beanz/m-draw-scad/readme.md

# M-draw-scad
Drawing bot with MGN rails

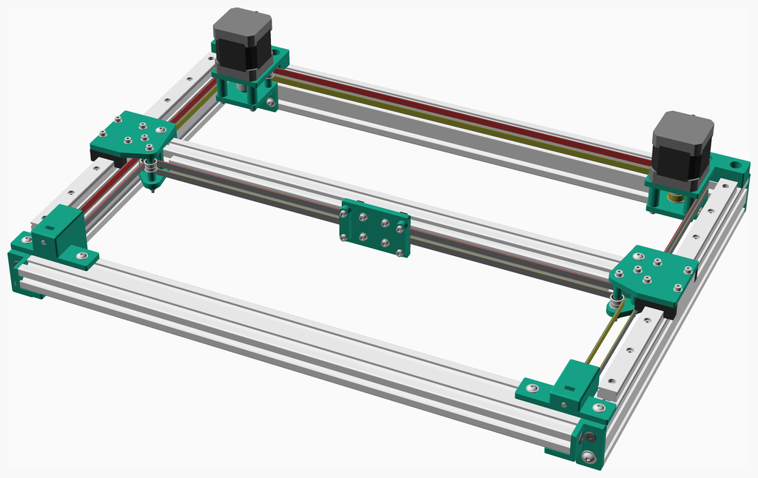
[picture p1: assemblies/main_assembled.png]
Main Assembly


<span></span>

---
## Table of Contents
1. [Parts list](#Parts_list)
1. [X Carriage Insert Assembly](#x_carriage_insert_assembly)
1. [X Carriage Assembly](#x_carriage_assembly)
1. [Idler Assembly](#idler_assembly)
1. [Right Y Carriage Assembly](#right_y_carriage_assembly)
1. [Left Y Carriage Assembly](#left_y_carriage_assembly)
1. [X Rail Carriage Assembly](#x_rail_carriage_assembly)
1. [X Rail Left Assembly](#x_rail_left_assembly)
1. [X Rail Assembly](#x_rail_assembly)
1. [Double Idler Assembly](#double_idler_assembly)
1. [Right Motor Pulley Assembly](#right_motor_pulley_assembly)
1. [Right Motor Assembly](#right_motor_assembly)
1. [Left Motor Pulley Assembly](#left_motor_pulley_assembly)
1. [Left Motor Assembly](#left_motor_assembly)
1. [Right Inner Idler Assembly](#right_inner_idler_assembly)
1. [Right Idler Assembly](#right_idler_assembly)
1. [Left Inner Idler Assembly](#left_inner_idler_assembly)
1. [Left Idler Assembly](#left_idler_assembly)
1. [Front Frame Left Assembly](#front_frame_left_assembly)
1. [Front Frame Assembly](#front_frame_assembly)
1. [Back Frame Left Assembly](#back_frame_left_assembly)
1. [Back Frame Assembly](#back_frame_assembly)
1. [Y Rail Assembly](#y_rail_assembly)
1. [Back And Y Assembly](#back_and_y_assembly)
1. [Frame Assembly](#frame_assembly)
1. [Frame Idler Assembly](#frame_idler_assembly)
1. [Frame Motor Assembly](#frame_motor_assembly)
1. [Frame X Rail Assembly](#frame_x_rail_assembly)
1. [Frame X Carriage Assembly](#frame_x_carriage_assembly)
1. [Main Assembly](#main_assembly)

<span></span>
[Top](#TOP)

---

## Parts list
| <span style="writing-mode: vertical-rl; text-orientation: mixed;">X&nbsp;Carriage&nbsp;Insert</span> | <span style="writing-mode: vertical-rl; text-orientation: mixed;">X&nbsp;Carriage</span> | <span style="writing-mode: vertical-rl; text-orientation: mixed;">8 x Idler</span> | <span style="writing-mode: vertical-rl; text-orientation: mixed;">Right&nbsp;Y&nbsp;Carriage</span> | <span style="writing-mode: vertical-rl; text-orientation: mixed;">Left&nbsp;Y&nbsp;Carriage</span> | <span style="writing-mode: vertical-rl; text-orientation: mixed;">X&nbsp;Rail&nbsp;Carriage</span> | <span style="writing-mode: vertical-rl; text-orientation: mixed;">X&nbsp;Rail&nbsp;Left</span> | <span style="writing-mode: vertical-rl; text-orientation: mixed;">X&nbsp;Rail</span> | <span style="writing-mode: vertical-rl; text-orientation: mixed;">2 x Double&nbsp;Idler</span> | <span style="writing-mode: vertical-rl; text-orientation: mixed;">Right&nbsp;Motor&nbsp;Pulley</span> | <span style="writing-mode: vertical-rl; text-orientation: mixed;">Right&nbsp;Motor</span> | <span style="writing-mode: vertical-rl; text-orientation: mixed;">Left&nbsp;Motor&nbsp;Pulley</span> | <span style="writing-mode: vertical-rl; text-orientation: mixed;">Left&nbsp;Motor</span> | <span style="writing-mode: vertical-rl; text-orientation: mixed;">Right&nbsp;Inner&nbsp;Idler</span> | <span style="writing-mode: vertical-rl; text-orientation: mixed;">Right&nbsp;Idler</span> | <span style="writing-mode: vertical-rl; text-orientation: mixed;">Left&nbsp;Inner&nbsp;Idler</span> | <span style="writing-mode: vertical-rl; text-orientation: mixed;">Left&nbsp;Idler</span> | <span style="writing-mode: vertical-rl; text-orientation: mixed;">Front&nbsp;Frame&nbsp;Left</span> | <span style="writing-mode: vertical-rl; text-orientation: mixed;">Front&nbsp;Frame</span> | <span style="writing-mode: vertical-rl; text-orientation: mixed;">Back&nbsp;Frame&nbsp;Left</span> | <span style="writing-mode: vertical-rl; text-orientation: mixed;">Back&nbsp;Frame</span> | <span style="writing-mode: vertical-rl; text-orientation: mixed;">2 x Y&nbsp;Rail</span> | <span style="writing-mode: vertical-rl; text-orientation: mixed;">Back&nbsp;And&nbsp;Y</span> | <span style="writing-mode: vertical-rl; text-orientation: mixed;">Frame</span> | <span style="writing-mode: vertical-rl; text-orientation: mixed;">Frame&nbsp;Idler</span> | <span style="writing-mode: vertical-rl; text-orientation: mixed;">Frame&nbsp;Motor</span> | <span style="writing-mode: vertical-rl; text-orientation: mixed;">Frame&nbsp;X&nbsp;Rail</span> | <span style="writing-mode: vertical-rl; text-orientation: mixed;">Frame&nbsp;X&nbsp;Carriage</span> | <span style="writing-mode: vertical-rl; text-orientation: mixed;">Main</span> | <span style="writing-mode: vertical-rl; text-orientation: mixed;">TOTALS</span> |  |
|---:|---:|---:|---:|---:|---:|---:|---:|---:|---:|---:|---:|---:|---:|---:|---:|---:|---:|---:|---:|---:|---:|---:|---:|---:|---:|---:|---:|---:|---:|:---|
|  |  |  |  |  |  |  |  |  |  |  |  |  |  |  |  |  |  |  |  |  |  |  |  |  |  |  |  |  | | **Vitamins** |
| &nbsp;&nbsp;.&nbsp; | &nbsp;&nbsp;.&nbsp; | &nbsp;&nbsp;16&nbsp; | &nbsp;&nbsp;.&nbsp; | &nbsp;&nbsp;.&nbsp; | &nbsp;&nbsp;.&nbsp; | &nbsp;&nbsp;.&nbsp; | &nbsp;&nbsp;.&nbsp; | &nbsp;&nbsp;8&nbsp; | &nbsp;&nbsp;.&nbsp; | &nbsp;&nbsp;.&nbsp; | &nbsp;&nbsp;.&nbsp; | &nbsp;&nbsp;.&nbsp; | &nbsp;&nbsp;.&nbsp; | &nbsp;&nbsp;.&nbsp; | &nbsp;&nbsp;.&nbsp; | &nbsp;&nbsp;.&nbsp; | &nbsp;&nbsp;.&nbsp; | &nbsp;&nbsp;.&nbsp; | &nbsp;&nbsp;.&nbsp; | &nbsp;&nbsp;.&nbsp; | &nbsp;&nbsp;.&nbsp; | &nbsp;&nbsp;.&nbsp; | &nbsp;&nbsp;.&nbsp; | &nbsp;&nbsp;.&nbsp; | &nbsp;&nbsp;.&nbsp; | &nbsp;&nbsp;.&nbsp; | &nbsp;&nbsp;.&nbsp; | &nbsp;&nbsp;.&nbsp; |  &nbsp;&nbsp;24&nbsp; | &nbsp;&nbsp; Ball bearing F623-2RS 3mm x 10mm x 4mm |
| &nbsp;&nbsp;.&nbsp; | &nbsp;&nbsp;.&nbsp; | &nbsp;&nbsp;.&nbsp; | &nbsp;&nbsp;.&nbsp; | &nbsp;&nbsp;.&nbsp; | &nbsp;&nbsp;.&nbsp; | &nbsp;&nbsp;.&nbsp; | &nbsp;&nbsp;.&nbsp; | &nbsp;&nbsp;.&nbsp; | &nbsp;&nbsp;.&nbsp; | &nbsp;&nbsp;.&nbsp; | &nbsp;&nbsp;.&nbsp; | &nbsp;&nbsp;.&nbsp; | &nbsp;&nbsp;.&nbsp; | &nbsp;&nbsp;.&nbsp; | &nbsp;&nbsp;.&nbsp; | &nbsp;&nbsp;.&nbsp; | &nbsp;&nbsp;.&nbsp; | &nbsp;&nbsp;.&nbsp; | &nbsp;&nbsp;.&nbsp; | &nbsp;&nbsp;.&nbsp; | &nbsp;&nbsp;.&nbsp; | &nbsp;&nbsp;.&nbsp; | &nbsp;&nbsp;.&nbsp; | &nbsp;&nbsp;.&nbsp; | &nbsp;&nbsp;.&nbsp; | &nbsp;&nbsp;.&nbsp; | &nbsp;&nbsp;.&nbsp; | &nbsp;&nbsp;1&nbsp; |  &nbsp;&nbsp;1&nbsp; | &nbsp;&nbsp; Belt GT2 x 6mm x 1524mm |
| &nbsp;&nbsp;.&nbsp; | &nbsp;&nbsp;.&nbsp; | &nbsp;&nbsp;.&nbsp; | &nbsp;&nbsp;.&nbsp; | &nbsp;&nbsp;.&nbsp; | &nbsp;&nbsp;.&nbsp; | &nbsp;&nbsp;.&nbsp; | &nbsp;&nbsp;.&nbsp; | &nbsp;&nbsp;.&nbsp; | &nbsp;&nbsp;.&nbsp; | &nbsp;&nbsp;.&nbsp; | &nbsp;&nbsp;.&nbsp; | &nbsp;&nbsp;.&nbsp; | &nbsp;&nbsp;.&nbsp; | &nbsp;&nbsp;.&nbsp; | &nbsp;&nbsp;.&nbsp; | &nbsp;&nbsp;.&nbsp; | &nbsp;&nbsp;.&nbsp; | &nbsp;&nbsp;.&nbsp; | &nbsp;&nbsp;.&nbsp; | &nbsp;&nbsp;.&nbsp; | &nbsp;&nbsp;.&nbsp; | &nbsp;&nbsp;.&nbsp; | &nbsp;&nbsp;.&nbsp; | &nbsp;&nbsp;.&nbsp; | &nbsp;&nbsp;.&nbsp; | &nbsp;&nbsp;.&nbsp; | &nbsp;&nbsp;.&nbsp; | &nbsp;&nbsp;1&nbsp; |  &nbsp;&nbsp;1&nbsp; | &nbsp;&nbsp; Belt GT2 x 6mm x 1524mm |
| &nbsp;&nbsp;.&nbsp; | &nbsp;&nbsp;.&nbsp; | &nbsp;&nbsp;.&nbsp; | &nbsp;&nbsp;.&nbsp; | &nbsp;&nbsp;.&nbsp; | &nbsp;&nbsp;1&nbsp; | &nbsp;&nbsp;.&nbsp; | &nbsp;&nbsp;.&nbsp; | &nbsp;&nbsp;.&nbsp; | &nbsp;&nbsp;.&nbsp; | &nbsp;&nbsp;.&nbsp; | &nbsp;&nbsp;.&nbsp; | &nbsp;&nbsp;.&nbsp; | &nbsp;&nbsp;.&nbsp; | &nbsp;&nbsp;.&nbsp; | &nbsp;&nbsp;.&nbsp; | &nbsp;&nbsp;.&nbsp; | &nbsp;&nbsp;.&nbsp; | &nbsp;&nbsp;.&nbsp; | &nbsp;&nbsp;.&nbsp; | &nbsp;&nbsp;.&nbsp; | &nbsp;&nbsp;.&nbsp; | &nbsp;&nbsp;.&nbsp; | &nbsp;&nbsp;.&nbsp; | &nbsp;&nbsp;.&nbsp; | &nbsp;&nbsp;.&nbsp; | &nbsp;&nbsp;.&nbsp; | &nbsp;&nbsp;.&nbsp; | &nbsp;&nbsp;.&nbsp; |  &nbsp;&nbsp;1&nbsp; | &nbsp;&nbsp; Extrusion E2020 x 450mm |
| &nbsp;&nbsp;.&nbsp; | &nbsp;&nbsp;.&nbsp; | &nbsp;&nbsp;.&nbsp; | &nbsp;&nbsp;.&nbsp; | &nbsp;&nbsp;.&nbsp; | &nbsp;&nbsp;.&nbsp; | &nbsp;&nbsp;.&nbsp; | &nbsp;&nbsp;.&nbsp; | &nbsp;&nbsp;.&nbsp; | &nbsp;&nbsp;.&nbsp; | &nbsp;&nbsp;.&nbsp; | &nbsp;&nbsp;.&nbsp; | &nbsp;&nbsp;.&nbsp; | &nbsp;&nbsp;.&nbsp; | &nbsp;&nbsp;.&nbsp; | &nbsp;&nbsp;.&nbsp; | &nbsp;&nbsp;.&nbsp; | &nbsp;&nbsp;.&nbsp; | &nbsp;&nbsp;.&nbsp; | &nbsp;&nbsp;.&nbsp; | &nbsp;&nbsp;.&nbsp; | &nbsp;&nbsp;2&nbsp; | &nbsp;&nbsp;.&nbsp; | &nbsp;&nbsp;.&nbsp; | &nbsp;&nbsp;.&nbsp; | &nbsp;&nbsp;.&nbsp; | &nbsp;&nbsp;.&nbsp; | &nbsp;&nbsp;.&nbsp; | &nbsp;&nbsp;.&nbsp; |  &nbsp;&nbsp;2&nbsp; | &nbsp;&nbsp; Extrusion E2040 x 354mm |
| &nbsp;&nbsp;.&nbsp; | &nbsp;&nbsp;.&nbsp; | &nbsp;&nbsp;.&nbsp; | &nbsp;&nbsp;.&nbsp; | &nbsp;&nbsp;.&nbsp; | &nbsp;&nbsp;.&nbsp; | &nbsp;&nbsp;.&nbsp; | &nbsp;&nbsp;.&nbsp; | &nbsp;&nbsp;.&nbsp; | &nbsp;&nbsp;.&nbsp; | &nbsp;&nbsp;.&nbsp; | &nbsp;&nbsp;.&nbsp; | &nbsp;&nbsp;.&nbsp; | &nbsp;&nbsp;.&nbsp; | &nbsp;&nbsp;.&nbsp; | &nbsp;&nbsp;.&nbsp; | &nbsp;&nbsp;.&nbsp; | &nbsp;&nbsp;1&nbsp; | &nbsp;&nbsp;.&nbsp; | &nbsp;&nbsp;1&nbsp; | &nbsp;&nbsp;.&nbsp; | &nbsp;&nbsp;.&nbsp; | &nbsp;&nbsp;.&nbsp; | &nbsp;&nbsp;.&nbsp; | &nbsp;&nbsp;.&nbsp; | &nbsp;&nbsp;.&nbsp; | &nbsp;&nbsp;.&nbsp; | &nbsp;&nbsp;.&nbsp; | &nbsp;&nbsp;.&nbsp; |  &nbsp;&nbsp;2&nbsp; | &nbsp;&nbsp; Extrusion E2040 x 472mm |
| &nbsp;&nbsp;4&nbsp; | &nbsp;&nbsp;.&nbsp; | &nbsp;&nbsp;.&nbsp; | &nbsp;&nbsp;.&nbsp; | &nbsp;&nbsp;.&nbsp; | &nbsp;&nbsp;.&nbsp; | &nbsp;&nbsp;.&nbsp; | &nbsp;&nbsp;.&nbsp; | &nbsp;&nbsp;.&nbsp; | &nbsp;&nbsp;.&nbsp; | &nbsp;&nbsp;.&nbsp; | &nbsp;&nbsp;.&nbsp; | &nbsp;&nbsp;.&nbsp; | &nbsp;&nbsp;.&nbsp; | &nbsp;&nbsp;.&nbsp; | &nbsp;&nbsp;.&nbsp; | &nbsp;&nbsp;.&nbsp; | &nbsp;&nbsp;.&nbsp; | &nbsp;&nbsp;.&nbsp; | &nbsp;&nbsp;.&nbsp; | &nbsp;&nbsp;.&nbsp; | &nbsp;&nbsp;.&nbsp; | &nbsp;&nbsp;.&nbsp; | &nbsp;&nbsp;.&nbsp; | &nbsp;&nbsp;.&nbsp; | &nbsp;&nbsp;.&nbsp; | &nbsp;&nbsp;.&nbsp; | &nbsp;&nbsp;.&nbsp; | &nbsp;&nbsp;.&nbsp; |  &nbsp;&nbsp;4&nbsp; | &nbsp;&nbsp; Heatfit insert M3 x 4mm |
| &nbsp;&nbsp;.&nbsp; | &nbsp;&nbsp;.&nbsp; | &nbsp;&nbsp;.&nbsp; | &nbsp;&nbsp;.&nbsp; | &nbsp;&nbsp;.&nbsp; | &nbsp;&nbsp;1&nbsp; | &nbsp;&nbsp;.&nbsp; | &nbsp;&nbsp;.&nbsp; | &nbsp;&nbsp;.&nbsp; | &nbsp;&nbsp;.&nbsp; | &nbsp;&nbsp;.&nbsp; | &nbsp;&nbsp;.&nbsp; | &nbsp;&nbsp;.&nbsp; | &nbsp;&nbsp;.&nbsp; | &nbsp;&nbsp;.&nbsp; | &nbsp;&nbsp;.&nbsp; | &nbsp;&nbsp;.&nbsp; | &nbsp;&nbsp;.&nbsp; | &nbsp;&nbsp;.&nbsp; | &nbsp;&nbsp;.&nbsp; | &nbsp;&nbsp;.&nbsp; | &nbsp;&nbsp;.&nbsp; | &nbsp;&nbsp;.&nbsp; | &nbsp;&nbsp;.&nbsp; | &nbsp;&nbsp;.&nbsp; | &nbsp;&nbsp;.&nbsp; | &nbsp;&nbsp;.&nbsp; | &nbsp;&nbsp;.&nbsp; | &nbsp;&nbsp;.&nbsp; |  &nbsp;&nbsp;1&nbsp; | &nbsp;&nbsp; Linear rail MGN12 x 400mm |
| &nbsp;&nbsp;.&nbsp; | &nbsp;&nbsp;.&nbsp; | &nbsp;&nbsp;.&nbsp; | &nbsp;&nbsp;.&nbsp; | &nbsp;&nbsp;.&nbsp; | &nbsp;&nbsp;.&nbsp; | &nbsp;&nbsp;.&nbsp; | &nbsp;&nbsp;.&nbsp; | &nbsp;&nbsp;.&nbsp; | &nbsp;&nbsp;.&nbsp; | &nbsp;&nbsp;.&nbsp; | &nbsp;&nbsp;.&nbsp; | &nbsp;&nbsp;.&nbsp; | &nbsp;&nbsp;.&nbsp; | &nbsp;&nbsp;.&nbsp; | &nbsp;&nbsp;.&nbsp; | &nbsp;&nbsp;.&nbsp; | &nbsp;&nbsp;.&nbsp; | &nbsp;&nbsp;.&nbsp; | &nbsp;&nbsp;.&nbsp; | &nbsp;&nbsp;.&nbsp; | &nbsp;&nbsp;2&nbsp; | &nbsp;&nbsp;.&nbsp; | &nbsp;&nbsp;.&nbsp; | &nbsp;&nbsp;.&nbsp; | &nbsp;&nbsp;.&nbsp; | &nbsp;&nbsp;.&nbsp; | &nbsp;&nbsp;.&nbsp; | &nbsp;&nbsp;.&nbsp; |  &nbsp;&nbsp;2&nbsp; | &nbsp;&nbsp; Linear rail MGN15 x 300mm |
| &nbsp;&nbsp;.&nbsp; | &nbsp;&nbsp;.&nbsp; | &nbsp;&nbsp;.&nbsp; | &nbsp;&nbsp;.&nbsp; | &nbsp;&nbsp;.&nbsp; | &nbsp;&nbsp;1&nbsp; | &nbsp;&nbsp;.&nbsp; | &nbsp;&nbsp;.&nbsp; | &nbsp;&nbsp;.&nbsp; | &nbsp;&nbsp;.&nbsp; | &nbsp;&nbsp;.&nbsp; | &nbsp;&nbsp;.&nbsp; | &nbsp;&nbsp;.&nbsp; | &nbsp;&nbsp;.&nbsp; | &nbsp;&nbsp;.&nbsp; | &nbsp;&nbsp;.&nbsp; | &nbsp;&nbsp;.&nbsp; | &nbsp;&nbsp;.&nbsp; | &nbsp;&nbsp;.&nbsp; | &nbsp;&nbsp;.&nbsp; | &nbsp;&nbsp;.&nbsp; | &nbsp;&nbsp;.&nbsp; | &nbsp;&nbsp;.&nbsp; | &nbsp;&nbsp;.&nbsp; | &nbsp;&nbsp;.&nbsp; | &nbsp;&nbsp;.&nbsp; | &nbsp;&nbsp;.&nbsp; | &nbsp;&nbsp;.&nbsp; | &nbsp;&nbsp;.&nbsp; |  &nbsp;&nbsp;1&nbsp; | &nbsp;&nbsp; Linear rail carriage MGN12H |
| &nbsp;&nbsp;.&nbsp; | &nbsp;&nbsp;.&nbsp; | &nbsp;&nbsp;.&nbsp; | &nbsp;&nbsp;.&nbsp; | &nbsp;&nbsp;.&nbsp; | &nbsp;&nbsp;.&nbsp; | &nbsp;&nbsp;.&nbsp; | &nbsp;&nbsp;.&nbsp; | &nbsp;&nbsp;.&nbsp; | &nbsp;&nbsp;.&nbsp; | &nbsp;&nbsp;.&nbsp; | &nbsp;&nbsp;.&nbsp; | &nbsp;&nbsp;.&nbsp; | &nbsp;&nbsp;.&nbsp; | &nbsp;&nbsp;.&nbsp; | &nbsp;&nbsp;.&nbsp; | &nbsp;&nbsp;.&nbsp; | &nbsp;&nbsp;.&nbsp; | &nbsp;&nbsp;.&nbsp; | &nbsp;&nbsp;.&nbsp; | &nbsp;&nbsp;.&nbsp; | &nbsp;&nbsp;2&nbsp; | &nbsp;&nbsp;.&nbsp; | &nbsp;&nbsp;.&nbsp; | &nbsp;&nbsp;.&nbsp; | &nbsp;&nbsp;.&nbsp; | &nbsp;&nbsp;.&nbsp; | &nbsp;&nbsp;.&nbsp; | &nbsp;&nbsp;.&nbsp; |  &nbsp;&nbsp;2&nbsp; | &nbsp;&nbsp; Linear rail carriage MGN15H |
| &nbsp;&nbsp;.&nbsp; | &nbsp;&nbsp;.&nbsp; | &nbsp;&nbsp;.&nbsp; | &nbsp;&nbsp;.&nbsp; | &nbsp;&nbsp;.&nbsp; | &nbsp;&nbsp;16&nbsp; | &nbsp;&nbsp;2&nbsp; | &nbsp;&nbsp;2&nbsp; | &nbsp;&nbsp;.&nbsp; | &nbsp;&nbsp;.&nbsp; | &nbsp;&nbsp;.&nbsp; | &nbsp;&nbsp;.&nbsp; | &nbsp;&nbsp;.&nbsp; | &nbsp;&nbsp;.&nbsp; | &nbsp;&nbsp;.&nbsp; | &nbsp;&nbsp;.&nbsp; | &nbsp;&nbsp;.&nbsp; | &nbsp;&nbsp;.&nbsp; | &nbsp;&nbsp;.&nbsp; | &nbsp;&nbsp;.&nbsp; | &nbsp;&nbsp;.&nbsp; | &nbsp;&nbsp;16&nbsp; | &nbsp;&nbsp;.&nbsp; | &nbsp;&nbsp;.&nbsp; | &nbsp;&nbsp;.&nbsp; | &nbsp;&nbsp;.&nbsp; | &nbsp;&nbsp;.&nbsp; | &nbsp;&nbsp;.&nbsp; | &nbsp;&nbsp;.&nbsp; |  &nbsp;&nbsp;36&nbsp; | &nbsp;&nbsp; Nut M3 sliding T |
| &nbsp;&nbsp;.&nbsp; | &nbsp;&nbsp;.&nbsp; | &nbsp;&nbsp;.&nbsp; | &nbsp;&nbsp;.&nbsp; | &nbsp;&nbsp;.&nbsp; | &nbsp;&nbsp;.&nbsp; | &nbsp;&nbsp;.&nbsp; | &nbsp;&nbsp;.&nbsp; | &nbsp;&nbsp;.&nbsp; | &nbsp;&nbsp;.&nbsp; | &nbsp;&nbsp;.&nbsp; | &nbsp;&nbsp;.&nbsp; | &nbsp;&nbsp;.&nbsp; | &nbsp;&nbsp;.&nbsp; | &nbsp;&nbsp;.&nbsp; | &nbsp;&nbsp;.&nbsp; | &nbsp;&nbsp;.&nbsp; | &nbsp;&nbsp;4&nbsp; | &nbsp;&nbsp;4&nbsp; | &nbsp;&nbsp;7&nbsp; | &nbsp;&nbsp;7&nbsp; | &nbsp;&nbsp;.&nbsp; | &nbsp;&nbsp;2&nbsp; | &nbsp;&nbsp;2&nbsp; | &nbsp;&nbsp;.&nbsp; | &nbsp;&nbsp;.&nbsp; | &nbsp;&nbsp;.&nbsp; | &nbsp;&nbsp;.&nbsp; | &nbsp;&nbsp;.&nbsp; |  &nbsp;&nbsp;26&nbsp; | &nbsp;&nbsp; Nut M4 sliding T |
| &nbsp;&nbsp;.&nbsp; | &nbsp;&nbsp;.&nbsp; | &nbsp;&nbsp;.&nbsp; | &nbsp;&nbsp;2&nbsp; | &nbsp;&nbsp;2&nbsp; | &nbsp;&nbsp;.&nbsp; | &nbsp;&nbsp;.&nbsp; | &nbsp;&nbsp;.&nbsp; | &nbsp;&nbsp;.&nbsp; | &nbsp;&nbsp;.&nbsp; | &nbsp;&nbsp;.&nbsp; | &nbsp;&nbsp;.&nbsp; | &nbsp;&nbsp;.&nbsp; | &nbsp;&nbsp;.&nbsp; | &nbsp;&nbsp;.&nbsp; | &nbsp;&nbsp;.&nbsp; | &nbsp;&nbsp;.&nbsp; | &nbsp;&nbsp;.&nbsp; | &nbsp;&nbsp;.&nbsp; | &nbsp;&nbsp;.&nbsp; | &nbsp;&nbsp;.&nbsp; | &nbsp;&nbsp;.&nbsp; | &nbsp;&nbsp;.&nbsp; | &nbsp;&nbsp;.&nbsp; | &nbsp;&nbsp;.&nbsp; | &nbsp;&nbsp;.&nbsp; | &nbsp;&nbsp;.&nbsp; | &nbsp;&nbsp;.&nbsp; | &nbsp;&nbsp;.&nbsp; |  &nbsp;&nbsp;4&nbsp; | &nbsp;&nbsp; Nut M4 x 3.2mm  |
| &nbsp;&nbsp;.&nbsp; | &nbsp;&nbsp;.&nbsp; | &nbsp;&nbsp;.&nbsp; | &nbsp;&nbsp;.&nbsp; | &nbsp;&nbsp;.&nbsp; | &nbsp;&nbsp;.&nbsp; | &nbsp;&nbsp;.&nbsp; | &nbsp;&nbsp;.&nbsp; | &nbsp;&nbsp;.&nbsp; | &nbsp;&nbsp;.&nbsp; | &nbsp;&nbsp;.&nbsp; | &nbsp;&nbsp;.&nbsp; | &nbsp;&nbsp;.&nbsp; | &nbsp;&nbsp;.&nbsp; | &nbsp;&nbsp;2&nbsp; | &nbsp;&nbsp;.&nbsp; | &nbsp;&nbsp;2&nbsp; | &nbsp;&nbsp;.&nbsp; | &nbsp;&nbsp;.&nbsp; | &nbsp;&nbsp;.&nbsp; | &nbsp;&nbsp;.&nbsp; | &nbsp;&nbsp;.&nbsp; | &nbsp;&nbsp;.&nbsp; | &nbsp;&nbsp;.&nbsp; | &nbsp;&nbsp;.&nbsp; | &nbsp;&nbsp;.&nbsp; | &nbsp;&nbsp;.&nbsp; | &nbsp;&nbsp;.&nbsp; | &nbsp;&nbsp;.&nbsp; |  &nbsp;&nbsp;4&nbsp; | &nbsp;&nbsp; Nut M4 x 3.2mm  |
| &nbsp;&nbsp;.&nbsp; | &nbsp;&nbsp;.&nbsp; | &nbsp;&nbsp;.&nbsp; | &nbsp;&nbsp;.&nbsp; | &nbsp;&nbsp;.&nbsp; | &nbsp;&nbsp;.&nbsp; | &nbsp;&nbsp;.&nbsp; | &nbsp;&nbsp;.&nbsp; | &nbsp;&nbsp;.&nbsp; | &nbsp;&nbsp;1&nbsp; | &nbsp;&nbsp;.&nbsp; | &nbsp;&nbsp;1&nbsp; | &nbsp;&nbsp;.&nbsp; | &nbsp;&nbsp;.&nbsp; | &nbsp;&nbsp;.&nbsp; | &nbsp;&nbsp;.&nbsp; | &nbsp;&nbsp;.&nbsp; | &nbsp;&nbsp;.&nbsp; | &nbsp;&nbsp;.&nbsp; | &nbsp;&nbsp;.&nbsp; | &nbsp;&nbsp;.&nbsp; | &nbsp;&nbsp;.&nbsp; | &nbsp;&nbsp;.&nbsp; | &nbsp;&nbsp;.&nbsp; | &nbsp;&nbsp;.&nbsp; | &nbsp;&nbsp;.&nbsp; | &nbsp;&nbsp;.&nbsp; | &nbsp;&nbsp;.&nbsp; | &nbsp;&nbsp;.&nbsp; |  &nbsp;&nbsp;2&nbsp; | &nbsp;&nbsp; Pulley GT2OB 20 teeth |
| &nbsp;&nbsp;.&nbsp; | &nbsp;&nbsp;4&nbsp; | &nbsp;&nbsp;.&nbsp; | &nbsp;&nbsp;.&nbsp; | &nbsp;&nbsp;.&nbsp; | &nbsp;&nbsp;14&nbsp; | &nbsp;&nbsp;.&nbsp; | &nbsp;&nbsp;.&nbsp; | &nbsp;&nbsp;.&nbsp; | &nbsp;&nbsp;.&nbsp; | &nbsp;&nbsp;.&nbsp; | &nbsp;&nbsp;.&nbsp; | &nbsp;&nbsp;.&nbsp; | &nbsp;&nbsp;.&nbsp; | &nbsp;&nbsp;.&nbsp; | &nbsp;&nbsp;.&nbsp; | &nbsp;&nbsp;.&nbsp; | &nbsp;&nbsp;.&nbsp; | &nbsp;&nbsp;.&nbsp; | &nbsp;&nbsp;.&nbsp; | &nbsp;&nbsp;.&nbsp; | &nbsp;&nbsp;12&nbsp; | &nbsp;&nbsp;.&nbsp; | &nbsp;&nbsp;.&nbsp; | &nbsp;&nbsp;.&nbsp; | &nbsp;&nbsp;.&nbsp; | &nbsp;&nbsp;8&nbsp; | &nbsp;&nbsp;4&nbsp; | &nbsp;&nbsp;.&nbsp; |  &nbsp;&nbsp;42&nbsp; | &nbsp;&nbsp; Screw M3 cap x 10mm |
| &nbsp;&nbsp;.&nbsp; | &nbsp;&nbsp;.&nbsp; | &nbsp;&nbsp;.&nbsp; | &nbsp;&nbsp;.&nbsp; | &nbsp;&nbsp;.&nbsp; | &nbsp;&nbsp;.&nbsp; | &nbsp;&nbsp;.&nbsp; | &nbsp;&nbsp;.&nbsp; | &nbsp;&nbsp;.&nbsp; | &nbsp;&nbsp;.&nbsp; | &nbsp;&nbsp;4&nbsp; | &nbsp;&nbsp;.&nbsp; | &nbsp;&nbsp;4&nbsp; | &nbsp;&nbsp;.&nbsp; | &nbsp;&nbsp;.&nbsp; | &nbsp;&nbsp;.&nbsp; | &nbsp;&nbsp;.&nbsp; | &nbsp;&nbsp;.&nbsp; | &nbsp;&nbsp;.&nbsp; | &nbsp;&nbsp;.&nbsp; | &nbsp;&nbsp;.&nbsp; | &nbsp;&nbsp;.&nbsp; | &nbsp;&nbsp;.&nbsp; | &nbsp;&nbsp;.&nbsp; | &nbsp;&nbsp;.&nbsp; | &nbsp;&nbsp;.&nbsp; | &nbsp;&nbsp;.&nbsp; | &nbsp;&nbsp;.&nbsp; | &nbsp;&nbsp;.&nbsp; |  &nbsp;&nbsp;8&nbsp; | &nbsp;&nbsp; Screw M3 cap x 35mm |
| &nbsp;&nbsp;.&nbsp; | &nbsp;&nbsp;.&nbsp; | &nbsp;&nbsp;.&nbsp; | &nbsp;&nbsp;2&nbsp; | &nbsp;&nbsp;2&nbsp; | &nbsp;&nbsp;.&nbsp; | &nbsp;&nbsp;.&nbsp; | &nbsp;&nbsp;.&nbsp; | &nbsp;&nbsp;.&nbsp; | &nbsp;&nbsp;.&nbsp; | &nbsp;&nbsp;.&nbsp; | &nbsp;&nbsp;.&nbsp; | &nbsp;&nbsp;.&nbsp; | &nbsp;&nbsp;.&nbsp; | &nbsp;&nbsp;.&nbsp; | &nbsp;&nbsp;.&nbsp; | &nbsp;&nbsp;.&nbsp; | &nbsp;&nbsp;.&nbsp; | &nbsp;&nbsp;.&nbsp; | &nbsp;&nbsp;.&nbsp; | &nbsp;&nbsp;.&nbsp; | &nbsp;&nbsp;.&nbsp; | &nbsp;&nbsp;.&nbsp; | &nbsp;&nbsp;.&nbsp; | &nbsp;&nbsp;.&nbsp; | &nbsp;&nbsp;.&nbsp; | &nbsp;&nbsp;.&nbsp; | &nbsp;&nbsp;.&nbsp; | &nbsp;&nbsp;.&nbsp; |  &nbsp;&nbsp;4&nbsp; | &nbsp;&nbsp; Screw M3 cap x 45mm |
| &nbsp;&nbsp;.&nbsp; | &nbsp;&nbsp;.&nbsp; | &nbsp;&nbsp;.&nbsp; | &nbsp;&nbsp;.&nbsp; | &nbsp;&nbsp;.&nbsp; | &nbsp;&nbsp;2&nbsp; | &nbsp;&nbsp;.&nbsp; | &nbsp;&nbsp;.&nbsp; | &nbsp;&nbsp;.&nbsp; | &nbsp;&nbsp;.&nbsp; | &nbsp;&nbsp;.&nbsp; | &nbsp;&nbsp;.&nbsp; | &nbsp;&nbsp;.&nbsp; | &nbsp;&nbsp;.&nbsp; | &nbsp;&nbsp;.&nbsp; | &nbsp;&nbsp;.&nbsp; | &nbsp;&nbsp;.&nbsp; | &nbsp;&nbsp;.&nbsp; | &nbsp;&nbsp;.&nbsp; | &nbsp;&nbsp;.&nbsp; | &nbsp;&nbsp;.&nbsp; | &nbsp;&nbsp;4&nbsp; | &nbsp;&nbsp;.&nbsp; | &nbsp;&nbsp;.&nbsp; | &nbsp;&nbsp;.&nbsp; | &nbsp;&nbsp;.&nbsp; | &nbsp;&nbsp;.&nbsp; | &nbsp;&nbsp;.&nbsp; | &nbsp;&nbsp;.&nbsp; |  &nbsp;&nbsp;6&nbsp; | &nbsp;&nbsp; Screw M3 cs cap x 12mm |
| &nbsp;&nbsp;.&nbsp; | &nbsp;&nbsp;.&nbsp; | &nbsp;&nbsp;.&nbsp; | &nbsp;&nbsp;.&nbsp; | &nbsp;&nbsp;.&nbsp; | &nbsp;&nbsp;.&nbsp; | &nbsp;&nbsp;.&nbsp; | &nbsp;&nbsp;.&nbsp; | &nbsp;&nbsp;.&nbsp; | &nbsp;&nbsp;2&nbsp; | &nbsp;&nbsp;.&nbsp; | &nbsp;&nbsp;2&nbsp; | &nbsp;&nbsp;.&nbsp; | &nbsp;&nbsp;.&nbsp; | &nbsp;&nbsp;.&nbsp; | &nbsp;&nbsp;.&nbsp; | &nbsp;&nbsp;.&nbsp; | &nbsp;&nbsp;.&nbsp; | &nbsp;&nbsp;.&nbsp; | &nbsp;&nbsp;.&nbsp; | &nbsp;&nbsp;.&nbsp; | &nbsp;&nbsp;.&nbsp; | &nbsp;&nbsp;.&nbsp; | &nbsp;&nbsp;.&nbsp; | &nbsp;&nbsp;.&nbsp; | &nbsp;&nbsp;.&nbsp; | &nbsp;&nbsp;.&nbsp; | &nbsp;&nbsp;.&nbsp; | &nbsp;&nbsp;.&nbsp; |  &nbsp;&nbsp;4&nbsp; | &nbsp;&nbsp; Screw M3 grub x  6mm |
| &nbsp;&nbsp;.&nbsp; | &nbsp;&nbsp;.&nbsp; | &nbsp;&nbsp;.&nbsp; | &nbsp;&nbsp;.&nbsp; | &nbsp;&nbsp;.&nbsp; | &nbsp;&nbsp;.&nbsp; | &nbsp;&nbsp;.&nbsp; | &nbsp;&nbsp;.&nbsp; | &nbsp;&nbsp;.&nbsp; | &nbsp;&nbsp;.&nbsp; | &nbsp;&nbsp;.&nbsp; | &nbsp;&nbsp;.&nbsp; | &nbsp;&nbsp;.&nbsp; | &nbsp;&nbsp;1&nbsp; | &nbsp;&nbsp;.&nbsp; | &nbsp;&nbsp;1&nbsp; | &nbsp;&nbsp;.&nbsp; | &nbsp;&nbsp;.&nbsp; | &nbsp;&nbsp;.&nbsp; | &nbsp;&nbsp;.&nbsp; | &nbsp;&nbsp;.&nbsp; | &nbsp;&nbsp;.&nbsp; | &nbsp;&nbsp;.&nbsp; | &nbsp;&nbsp;.&nbsp; | &nbsp;&nbsp;.&nbsp; | &nbsp;&nbsp;.&nbsp; | &nbsp;&nbsp;.&nbsp; | &nbsp;&nbsp;.&nbsp; | &nbsp;&nbsp;.&nbsp; |  &nbsp;&nbsp;2&nbsp; | &nbsp;&nbsp; Screw M3 grub x 20mm |
| &nbsp;&nbsp;.&nbsp; | &nbsp;&nbsp;.&nbsp; | &nbsp;&nbsp;.&nbsp; | &nbsp;&nbsp;.&nbsp; | &nbsp;&nbsp;.&nbsp; | &nbsp;&nbsp;.&nbsp; | &nbsp;&nbsp;1&nbsp; | &nbsp;&nbsp;1&nbsp; | &nbsp;&nbsp;.&nbsp; | &nbsp;&nbsp;.&nbsp; | &nbsp;&nbsp;.&nbsp; | &nbsp;&nbsp;.&nbsp; | &nbsp;&nbsp;.&nbsp; | &nbsp;&nbsp;.&nbsp; | &nbsp;&nbsp;.&nbsp; | &nbsp;&nbsp;.&nbsp; | &nbsp;&nbsp;.&nbsp; | &nbsp;&nbsp;1&nbsp; | &nbsp;&nbsp;1&nbsp; | &nbsp;&nbsp;3&nbsp; | &nbsp;&nbsp;3&nbsp; | &nbsp;&nbsp;.&nbsp; | &nbsp;&nbsp;.&nbsp; | &nbsp;&nbsp;.&nbsp; | &nbsp;&nbsp;6&nbsp; | &nbsp;&nbsp;10&nbsp; | &nbsp;&nbsp;.&nbsp; | &nbsp;&nbsp;.&nbsp; | &nbsp;&nbsp;.&nbsp; |  &nbsp;&nbsp;26&nbsp; | &nbsp;&nbsp; Screw M4 flanged x 10mm |
| &nbsp;&nbsp;.&nbsp; | &nbsp;&nbsp;.&nbsp; | &nbsp;&nbsp;.&nbsp; | &nbsp;&nbsp;.&nbsp; | &nbsp;&nbsp;.&nbsp; | &nbsp;&nbsp;.&nbsp; | &nbsp;&nbsp;1&nbsp; | &nbsp;&nbsp;1&nbsp; | &nbsp;&nbsp;.&nbsp; | &nbsp;&nbsp;.&nbsp; | &nbsp;&nbsp;.&nbsp; | &nbsp;&nbsp;.&nbsp; | &nbsp;&nbsp;.&nbsp; | &nbsp;&nbsp;.&nbsp; | &nbsp;&nbsp;.&nbsp; | &nbsp;&nbsp;.&nbsp; | &nbsp;&nbsp;.&nbsp; | &nbsp;&nbsp;.&nbsp; | &nbsp;&nbsp;.&nbsp; | &nbsp;&nbsp;.&nbsp; | &nbsp;&nbsp;.&nbsp; | &nbsp;&nbsp;.&nbsp; | &nbsp;&nbsp;.&nbsp; | &nbsp;&nbsp;.&nbsp; | &nbsp;&nbsp;.&nbsp; | &nbsp;&nbsp;.&nbsp; | &nbsp;&nbsp;.&nbsp; | &nbsp;&nbsp;.&nbsp; | &nbsp;&nbsp;.&nbsp; |  &nbsp;&nbsp;2&nbsp; | &nbsp;&nbsp; Screw M4 flanged x 16mm |
| &nbsp;&nbsp;.&nbsp; | &nbsp;&nbsp;.&nbsp; | &nbsp;&nbsp;.&nbsp; | &nbsp;&nbsp;.&nbsp; | &nbsp;&nbsp;.&nbsp; | &nbsp;&nbsp;.&nbsp; | &nbsp;&nbsp;.&nbsp; | &nbsp;&nbsp;.&nbsp; | &nbsp;&nbsp;.&nbsp; | &nbsp;&nbsp;.&nbsp; | &nbsp;&nbsp;.&nbsp; | &nbsp;&nbsp;.&nbsp; | &nbsp;&nbsp;.&nbsp; | &nbsp;&nbsp;2&nbsp; | &nbsp;&nbsp;.&nbsp; | &nbsp;&nbsp;2&nbsp; | &nbsp;&nbsp;.&nbsp; | &nbsp;&nbsp;.&nbsp; | &nbsp;&nbsp;.&nbsp; | &nbsp;&nbsp;.&nbsp; | &nbsp;&nbsp;.&nbsp; | &nbsp;&nbsp;.&nbsp; | &nbsp;&nbsp;.&nbsp; | &nbsp;&nbsp;.&nbsp; | &nbsp;&nbsp;.&nbsp; | &nbsp;&nbsp;.&nbsp; | &nbsp;&nbsp;.&nbsp; | &nbsp;&nbsp;.&nbsp; | &nbsp;&nbsp;.&nbsp; |  &nbsp;&nbsp;4&nbsp; | &nbsp;&nbsp; Screw M4 flanged x 45mm |
| &nbsp;&nbsp;.&nbsp; | &nbsp;&nbsp;.&nbsp; | &nbsp;&nbsp;.&nbsp; | &nbsp;&nbsp;.&nbsp; | &nbsp;&nbsp;.&nbsp; | &nbsp;&nbsp;.&nbsp; | &nbsp;&nbsp;.&nbsp; | &nbsp;&nbsp;.&nbsp; | &nbsp;&nbsp;.&nbsp; | &nbsp;&nbsp;.&nbsp; | &nbsp;&nbsp;.&nbsp; | &nbsp;&nbsp;.&nbsp; | &nbsp;&nbsp;.&nbsp; | &nbsp;&nbsp;.&nbsp; | &nbsp;&nbsp;.&nbsp; | &nbsp;&nbsp;.&nbsp; | &nbsp;&nbsp;.&nbsp; | &nbsp;&nbsp;.&nbsp; | &nbsp;&nbsp;.&nbsp; | &nbsp;&nbsp;.&nbsp; | &nbsp;&nbsp;.&nbsp; | &nbsp;&nbsp;.&nbsp; | &nbsp;&nbsp;4&nbsp; | &nbsp;&nbsp;2&nbsp; | &nbsp;&nbsp;.&nbsp; | &nbsp;&nbsp;.&nbsp; | &nbsp;&nbsp;.&nbsp; | &nbsp;&nbsp;.&nbsp; | &nbsp;&nbsp;.&nbsp; |  &nbsp;&nbsp;6&nbsp; | &nbsp;&nbsp; Screw M5 flanged x 10mm |
| &nbsp;&nbsp;.&nbsp; | &nbsp;&nbsp;.&nbsp; | &nbsp;&nbsp;.&nbsp; | &nbsp;&nbsp;.&nbsp; | &nbsp;&nbsp;.&nbsp; | &nbsp;&nbsp;.&nbsp; | &nbsp;&nbsp;.&nbsp; | &nbsp;&nbsp;.&nbsp; | &nbsp;&nbsp;.&nbsp; | &nbsp;&nbsp;.&nbsp; | &nbsp;&nbsp;.&nbsp; | &nbsp;&nbsp;.&nbsp; | &nbsp;&nbsp;.&nbsp; | &nbsp;&nbsp;.&nbsp; | &nbsp;&nbsp;.&nbsp; | &nbsp;&nbsp;.&nbsp; | &nbsp;&nbsp;.&nbsp; | &nbsp;&nbsp;1&nbsp; | &nbsp;&nbsp;1&nbsp; | &nbsp;&nbsp;.&nbsp; | &nbsp;&nbsp;.&nbsp; | &nbsp;&nbsp;.&nbsp; | &nbsp;&nbsp;.&nbsp; | &nbsp;&nbsp;2&nbsp; | &nbsp;&nbsp;.&nbsp; | &nbsp;&nbsp;.&nbsp; | &nbsp;&nbsp;.&nbsp; | &nbsp;&nbsp;.&nbsp; | &nbsp;&nbsp;.&nbsp; |  &nbsp;&nbsp;4&nbsp; | &nbsp;&nbsp; Screw M5 low profile x 10mm |
| &nbsp;&nbsp;.&nbsp; | &nbsp;&nbsp;.&nbsp; | &nbsp;&nbsp;.&nbsp; | &nbsp;&nbsp;.&nbsp; | &nbsp;&nbsp;.&nbsp; | &nbsp;&nbsp;.&nbsp; | &nbsp;&nbsp;.&nbsp; | &nbsp;&nbsp;.&nbsp; | &nbsp;&nbsp;.&nbsp; | &nbsp;&nbsp;1&nbsp; | &nbsp;&nbsp;.&nbsp; | &nbsp;&nbsp;1&nbsp; | &nbsp;&nbsp;.&nbsp; | &nbsp;&nbsp;.&nbsp; | &nbsp;&nbsp;.&nbsp; | &nbsp;&nbsp;.&nbsp; | &nbsp;&nbsp;.&nbsp; | &nbsp;&nbsp;.&nbsp; | &nbsp;&nbsp;.&nbsp; | &nbsp;&nbsp;.&nbsp; | &nbsp;&nbsp;.&nbsp; | &nbsp;&nbsp;.&nbsp; | &nbsp;&nbsp;.&nbsp; | &nbsp;&nbsp;.&nbsp; | &nbsp;&nbsp;.&nbsp; | &nbsp;&nbsp;.&nbsp; | &nbsp;&nbsp;.&nbsp; | &nbsp;&nbsp;.&nbsp; | &nbsp;&nbsp;.&nbsp; |  &nbsp;&nbsp;2&nbsp; | &nbsp;&nbsp; Stepper motor NEMA17 x 47mm (5x24 shaft) |
| &nbsp;&nbsp;.&nbsp; | &nbsp;&nbsp;.&nbsp; | &nbsp;&nbsp;24&nbsp; | &nbsp;&nbsp;2&nbsp; | &nbsp;&nbsp;2&nbsp; | &nbsp;&nbsp;.&nbsp; | &nbsp;&nbsp;.&nbsp; | &nbsp;&nbsp;.&nbsp; | &nbsp;&nbsp;14&nbsp; | &nbsp;&nbsp;.&nbsp; | &nbsp;&nbsp;4&nbsp; | &nbsp;&nbsp;.&nbsp; | &nbsp;&nbsp;4&nbsp; | &nbsp;&nbsp;.&nbsp; | &nbsp;&nbsp;.&nbsp; | &nbsp;&nbsp;.&nbsp; | &nbsp;&nbsp;.&nbsp; | &nbsp;&nbsp;.&nbsp; | &nbsp;&nbsp;.&nbsp; | &nbsp;&nbsp;.&nbsp; | &nbsp;&nbsp;.&nbsp; | &nbsp;&nbsp;.&nbsp; | &nbsp;&nbsp;.&nbsp; | &nbsp;&nbsp;.&nbsp; | &nbsp;&nbsp;.&nbsp; | &nbsp;&nbsp;.&nbsp; | &nbsp;&nbsp;8&nbsp; | &nbsp;&nbsp;4&nbsp; | &nbsp;&nbsp;.&nbsp; |  &nbsp;&nbsp;62&nbsp; | &nbsp;&nbsp; Washer  M3 x 7mm x 0.5mm |
| &nbsp;&nbsp;.&nbsp; | &nbsp;&nbsp;.&nbsp; | &nbsp;&nbsp;.&nbsp; | &nbsp;&nbsp;2&nbsp; | &nbsp;&nbsp;2&nbsp; | &nbsp;&nbsp;.&nbsp; | &nbsp;&nbsp;.&nbsp; | &nbsp;&nbsp;.&nbsp; | &nbsp;&nbsp;.&nbsp; | &nbsp;&nbsp;.&nbsp; | &nbsp;&nbsp;.&nbsp; | &nbsp;&nbsp;.&nbsp; | &nbsp;&nbsp;.&nbsp; | &nbsp;&nbsp;.&nbsp; | &nbsp;&nbsp;.&nbsp; | &nbsp;&nbsp;.&nbsp; | &nbsp;&nbsp;.&nbsp; | &nbsp;&nbsp;.&nbsp; | &nbsp;&nbsp;.&nbsp; | &nbsp;&nbsp;.&nbsp; | &nbsp;&nbsp;.&nbsp; | &nbsp;&nbsp;.&nbsp; | &nbsp;&nbsp;.&nbsp; | &nbsp;&nbsp;.&nbsp; | &nbsp;&nbsp;.&nbsp; | &nbsp;&nbsp;.&nbsp; | &nbsp;&nbsp;.&nbsp; | &nbsp;&nbsp;.&nbsp; | &nbsp;&nbsp;.&nbsp; |  &nbsp;&nbsp;4&nbsp; | &nbsp;&nbsp; Washer  M4 x 9mm x 0.8mm |
| &nbsp;&nbsp;4&nbsp; | &nbsp;&nbsp;4&nbsp; | &nbsp;&nbsp;40&nbsp; | &nbsp;&nbsp;8&nbsp; | &nbsp;&nbsp;8&nbsp; | &nbsp;&nbsp;35&nbsp; | &nbsp;&nbsp;4&nbsp; | &nbsp;&nbsp;4&nbsp; | &nbsp;&nbsp;22&nbsp; | &nbsp;&nbsp;4&nbsp; | &nbsp;&nbsp;8&nbsp; | &nbsp;&nbsp;4&nbsp; | &nbsp;&nbsp;8&nbsp; | &nbsp;&nbsp;3&nbsp; | &nbsp;&nbsp;2&nbsp; | &nbsp;&nbsp;3&nbsp; | &nbsp;&nbsp;2&nbsp; | &nbsp;&nbsp;7&nbsp; | &nbsp;&nbsp;6&nbsp; | &nbsp;&nbsp;11&nbsp; | &nbsp;&nbsp;10&nbsp; | &nbsp;&nbsp;38&nbsp; | &nbsp;&nbsp;6&nbsp; | &nbsp;&nbsp;6&nbsp; | &nbsp;&nbsp;6&nbsp; | &nbsp;&nbsp;10&nbsp; | &nbsp;&nbsp;16&nbsp; | &nbsp;&nbsp;8&nbsp; | &nbsp;&nbsp;2&nbsp; | &nbsp;&nbsp;289&nbsp; | &nbsp;&nbsp;Total vitamins count |
|  |  |  |  |  |  |  |  |  |  |  |  |  |  |  |  |  |  |  |  |  |  |  |  |  |  |  |  |  | | **3D printed parts** |
| &nbsp;&nbsp;.&nbsp; | &nbsp;&nbsp;.&nbsp; | &nbsp;&nbsp;.&nbsp; | &nbsp;&nbsp;.&nbsp; | &nbsp;&nbsp;.&nbsp; | &nbsp;&nbsp;.&nbsp; | &nbsp;&nbsp;.&nbsp; | &nbsp;&nbsp;.&nbsp; | &nbsp;&nbsp;.&nbsp; | &nbsp;&nbsp;.&nbsp; | &nbsp;&nbsp;.&nbsp; | &nbsp;&nbsp;.&nbsp; | &nbsp;&nbsp;.&nbsp; | &nbsp;&nbsp;.&nbsp; | &nbsp;&nbsp;.&nbsp; | &nbsp;&nbsp;.&nbsp; | &nbsp;&nbsp;.&nbsp; | &nbsp;&nbsp;.&nbsp; | &nbsp;&nbsp;.&nbsp; | &nbsp;&nbsp;1&nbsp; | &nbsp;&nbsp;.&nbsp; | &nbsp;&nbsp;.&nbsp; | &nbsp;&nbsp;.&nbsp; | &nbsp;&nbsp;.&nbsp; | &nbsp;&nbsp;.&nbsp; | &nbsp;&nbsp;.&nbsp; | &nbsp;&nbsp;.&nbsp; | &nbsp;&nbsp;.&nbsp; | &nbsp;&nbsp;.&nbsp; |  &nbsp;&nbsp;1&nbsp; | &nbsp;&nbsp;left_back_corner.stl |
| &nbsp;&nbsp;.&nbsp; | &nbsp;&nbsp;.&nbsp; | &nbsp;&nbsp;.&nbsp; | &nbsp;&nbsp;.&nbsp; | &nbsp;&nbsp;.&nbsp; | &nbsp;&nbsp;.&nbsp; | &nbsp;&nbsp;.&nbsp; | &nbsp;&nbsp;.&nbsp; | &nbsp;&nbsp;.&nbsp; | &nbsp;&nbsp;.&nbsp; | &nbsp;&nbsp;.&nbsp; | &nbsp;&nbsp;.&nbsp; | &nbsp;&nbsp;.&nbsp; | &nbsp;&nbsp;.&nbsp; | &nbsp;&nbsp;.&nbsp; | &nbsp;&nbsp;.&nbsp; | &nbsp;&nbsp;.&nbsp; | &nbsp;&nbsp;1&nbsp; | &nbsp;&nbsp;.&nbsp; | &nbsp;&nbsp;.&nbsp; | &nbsp;&nbsp;.&nbsp; | &nbsp;&nbsp;.&nbsp; | &nbsp;&nbsp;.&nbsp; | &nbsp;&nbsp;.&nbsp; | &nbsp;&nbsp;.&nbsp; | &nbsp;&nbsp;.&nbsp; | &nbsp;&nbsp;.&nbsp; | &nbsp;&nbsp;.&nbsp; | &nbsp;&nbsp;.&nbsp; |  &nbsp;&nbsp;1&nbsp; | &nbsp;&nbsp;left_front_corner.stl |
| &nbsp;&nbsp;.&nbsp; | &nbsp;&nbsp;.&nbsp; | &nbsp;&nbsp;.&nbsp; | &nbsp;&nbsp;.&nbsp; | &nbsp;&nbsp;.&nbsp; | &nbsp;&nbsp;.&nbsp; | &nbsp;&nbsp;.&nbsp; | &nbsp;&nbsp;.&nbsp; | &nbsp;&nbsp;.&nbsp; | &nbsp;&nbsp;.&nbsp; | &nbsp;&nbsp;.&nbsp; | &nbsp;&nbsp;.&nbsp; | &nbsp;&nbsp;.&nbsp; | &nbsp;&nbsp;.&nbsp; | &nbsp;&nbsp;.&nbsp; | &nbsp;&nbsp;1&nbsp; | &nbsp;&nbsp;.&nbsp; | &nbsp;&nbsp;.&nbsp; | &nbsp;&nbsp;.&nbsp; | &nbsp;&nbsp;.&nbsp; | &nbsp;&nbsp;.&nbsp; | &nbsp;&nbsp;.&nbsp; | &nbsp;&nbsp;.&nbsp; | &nbsp;&nbsp;.&nbsp; | &nbsp;&nbsp;.&nbsp; | &nbsp;&nbsp;.&nbsp; | &nbsp;&nbsp;.&nbsp; | &nbsp;&nbsp;.&nbsp; | &nbsp;&nbsp;.&nbsp; |  &nbsp;&nbsp;1&nbsp; | &nbsp;&nbsp;left_front_idler.stl |
| &nbsp;&nbsp;.&nbsp; | &nbsp;&nbsp;.&nbsp; | &nbsp;&nbsp;.&nbsp; | &nbsp;&nbsp;.&nbsp; | &nbsp;&nbsp;.&nbsp; | &nbsp;&nbsp;.&nbsp; | &nbsp;&nbsp;.&nbsp; | &nbsp;&nbsp;.&nbsp; | &nbsp;&nbsp;.&nbsp; | &nbsp;&nbsp;.&nbsp; | &nbsp;&nbsp;.&nbsp; | &nbsp;&nbsp;.&nbsp; | &nbsp;&nbsp;.&nbsp; | &nbsp;&nbsp;.&nbsp; | &nbsp;&nbsp;.&nbsp; | &nbsp;&nbsp;.&nbsp; | &nbsp;&nbsp;1&nbsp; | &nbsp;&nbsp;.&nbsp; | &nbsp;&nbsp;.&nbsp; | &nbsp;&nbsp;.&nbsp; | &nbsp;&nbsp;.&nbsp; | &nbsp;&nbsp;.&nbsp; | &nbsp;&nbsp;.&nbsp; | &nbsp;&nbsp;.&nbsp; | &nbsp;&nbsp;.&nbsp; | &nbsp;&nbsp;.&nbsp; | &nbsp;&nbsp;.&nbsp; | &nbsp;&nbsp;.&nbsp; | &nbsp;&nbsp;.&nbsp; |  &nbsp;&nbsp;1&nbsp; | &nbsp;&nbsp;left_idler_mount.stl |
| &nbsp;&nbsp;.&nbsp; | &nbsp;&nbsp;.&nbsp; | &nbsp;&nbsp;.&nbsp; | &nbsp;&nbsp;.&nbsp; | &nbsp;&nbsp;.&nbsp; | &nbsp;&nbsp;.&nbsp; | &nbsp;&nbsp;.&nbsp; | &nbsp;&nbsp;.&nbsp; | &nbsp;&nbsp;.&nbsp; | &nbsp;&nbsp;.&nbsp; | &nbsp;&nbsp;.&nbsp; | &nbsp;&nbsp;.&nbsp; | &nbsp;&nbsp;1&nbsp; | &nbsp;&nbsp;.&nbsp; | &nbsp;&nbsp;.&nbsp; | &nbsp;&nbsp;.&nbsp; | &nbsp;&nbsp;.&nbsp; | &nbsp;&nbsp;.&nbsp; | &nbsp;&nbsp;.&nbsp; | &nbsp;&nbsp;.&nbsp; | &nbsp;&nbsp;.&nbsp; | &nbsp;&nbsp;.&nbsp; | &nbsp;&nbsp;.&nbsp; | &nbsp;&nbsp;.&nbsp; | &nbsp;&nbsp;.&nbsp; | &nbsp;&nbsp;.&nbsp; | &nbsp;&nbsp;.&nbsp; | &nbsp;&nbsp;.&nbsp; | &nbsp;&nbsp;.&nbsp; |  &nbsp;&nbsp;1&nbsp; | &nbsp;&nbsp;left_lower_motor_mount.stl |
| &nbsp;&nbsp;.&nbsp; | &nbsp;&nbsp;.&nbsp; | &nbsp;&nbsp;.&nbsp; | &nbsp;&nbsp;.&nbsp; | &nbsp;&nbsp;1&nbsp; | &nbsp;&nbsp;.&nbsp; | &nbsp;&nbsp;.&nbsp; | &nbsp;&nbsp;.&nbsp; | &nbsp;&nbsp;.&nbsp; | &nbsp;&nbsp;.&nbsp; | &nbsp;&nbsp;.&nbsp; | &nbsp;&nbsp;.&nbsp; | &nbsp;&nbsp;.&nbsp; | &nbsp;&nbsp;.&nbsp; | &nbsp;&nbsp;.&nbsp; | &nbsp;&nbsp;.&nbsp; | &nbsp;&nbsp;.&nbsp; | &nbsp;&nbsp;.&nbsp; | &nbsp;&nbsp;.&nbsp; | &nbsp;&nbsp;.&nbsp; | &nbsp;&nbsp;.&nbsp; | &nbsp;&nbsp;.&nbsp; | &nbsp;&nbsp;.&nbsp; | &nbsp;&nbsp;.&nbsp; | &nbsp;&nbsp;.&nbsp; | &nbsp;&nbsp;.&nbsp; | &nbsp;&nbsp;.&nbsp; | &nbsp;&nbsp;.&nbsp; | &nbsp;&nbsp;.&nbsp; |  &nbsp;&nbsp;1&nbsp; | &nbsp;&nbsp;left_lower_y_carriage.stl |
| &nbsp;&nbsp;.&nbsp; | &nbsp;&nbsp;.&nbsp; | &nbsp;&nbsp;.&nbsp; | &nbsp;&nbsp;.&nbsp; | &nbsp;&nbsp;.&nbsp; | &nbsp;&nbsp;.&nbsp; | &nbsp;&nbsp;.&nbsp; | &nbsp;&nbsp;.&nbsp; | &nbsp;&nbsp;.&nbsp; | &nbsp;&nbsp;.&nbsp; | &nbsp;&nbsp;.&nbsp; | &nbsp;&nbsp;.&nbsp; | &nbsp;&nbsp;1&nbsp; | &nbsp;&nbsp;.&nbsp; | &nbsp;&nbsp;.&nbsp; | &nbsp;&nbsp;.&nbsp; | &nbsp;&nbsp;.&nbsp; | &nbsp;&nbsp;.&nbsp; | &nbsp;&nbsp;.&nbsp; | &nbsp;&nbsp;.&nbsp; | &nbsp;&nbsp;.&nbsp; | &nbsp;&nbsp;.&nbsp; | &nbsp;&nbsp;.&nbsp; | &nbsp;&nbsp;.&nbsp; | &nbsp;&nbsp;.&nbsp; | &nbsp;&nbsp;.&nbsp; | &nbsp;&nbsp;.&nbsp; | &nbsp;&nbsp;.&nbsp; | &nbsp;&nbsp;.&nbsp; |  &nbsp;&nbsp;1&nbsp; | &nbsp;&nbsp;left_motor_mount.stl |
| &nbsp;&nbsp;.&nbsp; | &nbsp;&nbsp;.&nbsp; | &nbsp;&nbsp;.&nbsp; | &nbsp;&nbsp;.&nbsp; | &nbsp;&nbsp;1&nbsp; | &nbsp;&nbsp;.&nbsp; | &nbsp;&nbsp;.&nbsp; | &nbsp;&nbsp;.&nbsp; | &nbsp;&nbsp;.&nbsp; | &nbsp;&nbsp;.&nbsp; | &nbsp;&nbsp;.&nbsp; | &nbsp;&nbsp;.&nbsp; | &nbsp;&nbsp;.&nbsp; | &nbsp;&nbsp;.&nbsp; | &nbsp;&nbsp;.&nbsp; | &nbsp;&nbsp;.&nbsp; | &nbsp;&nbsp;.&nbsp; | &nbsp;&nbsp;.&nbsp; | &nbsp;&nbsp;.&nbsp; | &nbsp;&nbsp;.&nbsp; | &nbsp;&nbsp;.&nbsp; | &nbsp;&nbsp;.&nbsp; | &nbsp;&nbsp;.&nbsp; | &nbsp;&nbsp;.&nbsp; | &nbsp;&nbsp;.&nbsp; | &nbsp;&nbsp;.&nbsp; | &nbsp;&nbsp;.&nbsp; | &nbsp;&nbsp;.&nbsp; | &nbsp;&nbsp;.&nbsp; |  &nbsp;&nbsp;1&nbsp; | &nbsp;&nbsp;left_y_carriage.stl |
| &nbsp;&nbsp;.&nbsp; | &nbsp;&nbsp;.&nbsp; | &nbsp;&nbsp;.&nbsp; | &nbsp;&nbsp;.&nbsp; | &nbsp;&nbsp;.&nbsp; | &nbsp;&nbsp;.&nbsp; | &nbsp;&nbsp;.&nbsp; | &nbsp;&nbsp;.&nbsp; | &nbsp;&nbsp;.&nbsp; | &nbsp;&nbsp;.&nbsp; | &nbsp;&nbsp;.&nbsp; | &nbsp;&nbsp;.&nbsp; | &nbsp;&nbsp;.&nbsp; | &nbsp;&nbsp;.&nbsp; | &nbsp;&nbsp;.&nbsp; | &nbsp;&nbsp;.&nbsp; | &nbsp;&nbsp;.&nbsp; | &nbsp;&nbsp;.&nbsp; | &nbsp;&nbsp;.&nbsp; | &nbsp;&nbsp;.&nbsp; | &nbsp;&nbsp;1&nbsp; | &nbsp;&nbsp;.&nbsp; | &nbsp;&nbsp;.&nbsp; | &nbsp;&nbsp;.&nbsp; | &nbsp;&nbsp;.&nbsp; | &nbsp;&nbsp;.&nbsp; | &nbsp;&nbsp;.&nbsp; | &nbsp;&nbsp;.&nbsp; | &nbsp;&nbsp;.&nbsp; |  &nbsp;&nbsp;1&nbsp; | &nbsp;&nbsp;right_back_corner.stl |
| &nbsp;&nbsp;.&nbsp; | &nbsp;&nbsp;.&nbsp; | &nbsp;&nbsp;.&nbsp; | &nbsp;&nbsp;.&nbsp; | &nbsp;&nbsp;.&nbsp; | &nbsp;&nbsp;.&nbsp; | &nbsp;&nbsp;.&nbsp; | &nbsp;&nbsp;.&nbsp; | &nbsp;&nbsp;.&nbsp; | &nbsp;&nbsp;.&nbsp; | &nbsp;&nbsp;.&nbsp; | &nbsp;&nbsp;.&nbsp; | &nbsp;&nbsp;.&nbsp; | &nbsp;&nbsp;.&nbsp; | &nbsp;&nbsp;.&nbsp; | &nbsp;&nbsp;.&nbsp; | &nbsp;&nbsp;.&nbsp; | &nbsp;&nbsp;.&nbsp; | &nbsp;&nbsp;1&nbsp; | &nbsp;&nbsp;.&nbsp; | &nbsp;&nbsp;.&nbsp; | &nbsp;&nbsp;.&nbsp; | &nbsp;&nbsp;.&nbsp; | &nbsp;&nbsp;.&nbsp; | &nbsp;&nbsp;.&nbsp; | &nbsp;&nbsp;.&nbsp; | &nbsp;&nbsp;.&nbsp; | &nbsp;&nbsp;.&nbsp; | &nbsp;&nbsp;.&nbsp; |  &nbsp;&nbsp;1&nbsp; | &nbsp;&nbsp;right_front_corner.stl |
| &nbsp;&nbsp;.&nbsp; | &nbsp;&nbsp;.&nbsp; | &nbsp;&nbsp;.&nbsp; | &nbsp;&nbsp;.&nbsp; | &nbsp;&nbsp;.&nbsp; | &nbsp;&nbsp;.&nbsp; | &nbsp;&nbsp;.&nbsp; | &nbsp;&nbsp;.&nbsp; | &nbsp;&nbsp;.&nbsp; | &nbsp;&nbsp;.&nbsp; | &nbsp;&nbsp;.&nbsp; | &nbsp;&nbsp;.&nbsp; | &nbsp;&nbsp;.&nbsp; | &nbsp;&nbsp;1&nbsp; | &nbsp;&nbsp;.&nbsp; | &nbsp;&nbsp;.&nbsp; | &nbsp;&nbsp;.&nbsp; | &nbsp;&nbsp;.&nbsp; | &nbsp;&nbsp;.&nbsp; | &nbsp;&nbsp;.&nbsp; | &nbsp;&nbsp;.&nbsp; | &nbsp;&nbsp;.&nbsp; | &nbsp;&nbsp;.&nbsp; | &nbsp;&nbsp;.&nbsp; | &nbsp;&nbsp;.&nbsp; | &nbsp;&nbsp;.&nbsp; | &nbsp;&nbsp;.&nbsp; | &nbsp;&nbsp;.&nbsp; | &nbsp;&nbsp;.&nbsp; |  &nbsp;&nbsp;1&nbsp; | &nbsp;&nbsp;right_front_idler.stl |
| &nbsp;&nbsp;.&nbsp; | &nbsp;&nbsp;.&nbsp; | &nbsp;&nbsp;.&nbsp; | &nbsp;&nbsp;.&nbsp; | &nbsp;&nbsp;.&nbsp; | &nbsp;&nbsp;.&nbsp; | &nbsp;&nbsp;.&nbsp; | &nbsp;&nbsp;.&nbsp; | &nbsp;&nbsp;.&nbsp; | &nbsp;&nbsp;.&nbsp; | &nbsp;&nbsp;.&nbsp; | &nbsp;&nbsp;.&nbsp; | &nbsp;&nbsp;.&nbsp; | &nbsp;&nbsp;.&nbsp; | &nbsp;&nbsp;1&nbsp; | &nbsp;&nbsp;.&nbsp; | &nbsp;&nbsp;.&nbsp; | &nbsp;&nbsp;.&nbsp; | &nbsp;&nbsp;.&nbsp; | &nbsp;&nbsp;.&nbsp; | &nbsp;&nbsp;.&nbsp; | &nbsp;&nbsp;.&nbsp; | &nbsp;&nbsp;.&nbsp; | &nbsp;&nbsp;.&nbsp; | &nbsp;&nbsp;.&nbsp; | &nbsp;&nbsp;.&nbsp; | &nbsp;&nbsp;.&nbsp; | &nbsp;&nbsp;.&nbsp; | &nbsp;&nbsp;.&nbsp; |  &nbsp;&nbsp;1&nbsp; | &nbsp;&nbsp;right_idler_mount.stl |
| &nbsp;&nbsp;.&nbsp; | &nbsp;&nbsp;.&nbsp; | &nbsp;&nbsp;.&nbsp; | &nbsp;&nbsp;.&nbsp; | &nbsp;&nbsp;.&nbsp; | &nbsp;&nbsp;.&nbsp; | &nbsp;&nbsp;.&nbsp; | &nbsp;&nbsp;.&nbsp; | &nbsp;&nbsp;.&nbsp; | &nbsp;&nbsp;.&nbsp; | &nbsp;&nbsp;1&nbsp; | &nbsp;&nbsp;.&nbsp; | &nbsp;&nbsp;.&nbsp; | &nbsp;&nbsp;.&nbsp; | &nbsp;&nbsp;.&nbsp; | &nbsp;&nbsp;.&nbsp; | &nbsp;&nbsp;.&nbsp; | &nbsp;&nbsp;.&nbsp; | &nbsp;&nbsp;.&nbsp; | &nbsp;&nbsp;.&nbsp; | &nbsp;&nbsp;.&nbsp; | &nbsp;&nbsp;.&nbsp; | &nbsp;&nbsp;.&nbsp; | &nbsp;&nbsp;.&nbsp; | &nbsp;&nbsp;.&nbsp; | &nbsp;&nbsp;.&nbsp; | &nbsp;&nbsp;.&nbsp; | &nbsp;&nbsp;.&nbsp; | &nbsp;&nbsp;.&nbsp; |  &nbsp;&nbsp;1&nbsp; | &nbsp;&nbsp;right_lower_motor_mount.stl |
| &nbsp;&nbsp;.&nbsp; | &nbsp;&nbsp;.&nbsp; | &nbsp;&nbsp;.&nbsp; | &nbsp;&nbsp;1&nbsp; | &nbsp;&nbsp;.&nbsp; | &nbsp;&nbsp;.&nbsp; | &nbsp;&nbsp;.&nbsp; | &nbsp;&nbsp;.&nbsp; | &nbsp;&nbsp;.&nbsp; | &nbsp;&nbsp;.&nbsp; | &nbsp;&nbsp;.&nbsp; | &nbsp;&nbsp;.&nbsp; | &nbsp;&nbsp;.&nbsp; | &nbsp;&nbsp;.&nbsp; | &nbsp;&nbsp;.&nbsp; | &nbsp;&nbsp;.&nbsp; | &nbsp;&nbsp;.&nbsp; | &nbsp;&nbsp;.&nbsp; | &nbsp;&nbsp;.&nbsp; | &nbsp;&nbsp;.&nbsp; | &nbsp;&nbsp;.&nbsp; | &nbsp;&nbsp;.&nbsp; | &nbsp;&nbsp;.&nbsp; | &nbsp;&nbsp;.&nbsp; | &nbsp;&nbsp;.&nbsp; | &nbsp;&nbsp;.&nbsp; | &nbsp;&nbsp;.&nbsp; | &nbsp;&nbsp;.&nbsp; | &nbsp;&nbsp;.&nbsp; |  &nbsp;&nbsp;1&nbsp; | &nbsp;&nbsp;right_lower_y_carriage.stl |
| &nbsp;&nbsp;.&nbsp; | &nbsp;&nbsp;.&nbsp; | &nbsp;&nbsp;.&nbsp; | &nbsp;&nbsp;.&nbsp; | &nbsp;&nbsp;.&nbsp; | &nbsp;&nbsp;.&nbsp; | &nbsp;&nbsp;.&nbsp; | &nbsp;&nbsp;.&nbsp; | &nbsp;&nbsp;.&nbsp; | &nbsp;&nbsp;.&nbsp; | &nbsp;&nbsp;1&nbsp; | &nbsp;&nbsp;.&nbsp; | &nbsp;&nbsp;.&nbsp; | &nbsp;&nbsp;.&nbsp; | &nbsp;&nbsp;.&nbsp; | &nbsp;&nbsp;.&nbsp; | &nbsp;&nbsp;.&nbsp; | &nbsp;&nbsp;.&nbsp; | &nbsp;&nbsp;.&nbsp; | &nbsp;&nbsp;.&nbsp; | &nbsp;&nbsp;.&nbsp; | &nbsp;&nbsp;.&nbsp; | &nbsp;&nbsp;.&nbsp; | &nbsp;&nbsp;.&nbsp; | &nbsp;&nbsp;.&nbsp; | &nbsp;&nbsp;.&nbsp; | &nbsp;&nbsp;.&nbsp; | &nbsp;&nbsp;.&nbsp; | &nbsp;&nbsp;.&nbsp; |  &nbsp;&nbsp;1&nbsp; | &nbsp;&nbsp;right_motor_mount.stl |
| &nbsp;&nbsp;.&nbsp; | &nbsp;&nbsp;.&nbsp; | &nbsp;&nbsp;.&nbsp; | &nbsp;&nbsp;1&nbsp; | &nbsp;&nbsp;.&nbsp; | &nbsp;&nbsp;.&nbsp; | &nbsp;&nbsp;.&nbsp; | &nbsp;&nbsp;.&nbsp; | &nbsp;&nbsp;.&nbsp; | &nbsp;&nbsp;.&nbsp; | &nbsp;&nbsp;.&nbsp; | &nbsp;&nbsp;.&nbsp; | &nbsp;&nbsp;.&nbsp; | &nbsp;&nbsp;.&nbsp; | &nbsp;&nbsp;.&nbsp; | &nbsp;&nbsp;.&nbsp; | &nbsp;&nbsp;.&nbsp; | &nbsp;&nbsp;.&nbsp; | &nbsp;&nbsp;.&nbsp; | &nbsp;&nbsp;.&nbsp; | &nbsp;&nbsp;.&nbsp; | &nbsp;&nbsp;.&nbsp; | &nbsp;&nbsp;.&nbsp; | &nbsp;&nbsp;.&nbsp; | &nbsp;&nbsp;.&nbsp; | &nbsp;&nbsp;.&nbsp; | &nbsp;&nbsp;.&nbsp; | &nbsp;&nbsp;.&nbsp; | &nbsp;&nbsp;.&nbsp; |  &nbsp;&nbsp;1&nbsp; | &nbsp;&nbsp;right_y_carriage.stl |
| &nbsp;&nbsp;.&nbsp; | &nbsp;&nbsp;2&nbsp; | &nbsp;&nbsp;.&nbsp; | &nbsp;&nbsp;.&nbsp; | &nbsp;&nbsp;.&nbsp; | &nbsp;&nbsp;.&nbsp; | &nbsp;&nbsp;.&nbsp; | &nbsp;&nbsp;.&nbsp; | &nbsp;&nbsp;.&nbsp; | &nbsp;&nbsp;.&nbsp; | &nbsp;&nbsp;.&nbsp; | &nbsp;&nbsp;.&nbsp; | &nbsp;&nbsp;.&nbsp; | &nbsp;&nbsp;.&nbsp; | &nbsp;&nbsp;.&nbsp; | &nbsp;&nbsp;.&nbsp; | &nbsp;&nbsp;.&nbsp; | &nbsp;&nbsp;.&nbsp; | &nbsp;&nbsp;.&nbsp; | &nbsp;&nbsp;.&nbsp; | &nbsp;&nbsp;.&nbsp; | &nbsp;&nbsp;.&nbsp; | &nbsp;&nbsp;.&nbsp; | &nbsp;&nbsp;.&nbsp; | &nbsp;&nbsp;.&nbsp; | &nbsp;&nbsp;.&nbsp; | &nbsp;&nbsp;.&nbsp; | &nbsp;&nbsp;.&nbsp; | &nbsp;&nbsp;.&nbsp; |  &nbsp;&nbsp;2&nbsp; | &nbsp;&nbsp;x_belt_clamp.stl |
| &nbsp;&nbsp;1&nbsp; | &nbsp;&nbsp;.&nbsp; | &nbsp;&nbsp;.&nbsp; | &nbsp;&nbsp;.&nbsp; | &nbsp;&nbsp;.&nbsp; | &nbsp;&nbsp;.&nbsp; | &nbsp;&nbsp;.&nbsp; | &nbsp;&nbsp;.&nbsp; | &nbsp;&nbsp;.&nbsp; | &nbsp;&nbsp;.&nbsp; | &nbsp;&nbsp;.&nbsp; | &nbsp;&nbsp;.&nbsp; | &nbsp;&nbsp;.&nbsp; | &nbsp;&nbsp;.&nbsp; | &nbsp;&nbsp;.&nbsp; | &nbsp;&nbsp;.&nbsp; | &nbsp;&nbsp;.&nbsp; | &nbsp;&nbsp;.&nbsp; | &nbsp;&nbsp;.&nbsp; | &nbsp;&nbsp;.&nbsp; | &nbsp;&nbsp;.&nbsp; | &nbsp;&nbsp;.&nbsp; | &nbsp;&nbsp;.&nbsp; | &nbsp;&nbsp;.&nbsp; | &nbsp;&nbsp;.&nbsp; | &nbsp;&nbsp;.&nbsp; | &nbsp;&nbsp;.&nbsp; | &nbsp;&nbsp;.&nbsp; | &nbsp;&nbsp;.&nbsp; |  &nbsp;&nbsp;1&nbsp; | &nbsp;&nbsp;x_carriage.stl |
| &nbsp;&nbsp;1&nbsp; | &nbsp;&nbsp;2&nbsp; | &nbsp;&nbsp;.&nbsp; | &nbsp;&nbsp;2&nbsp; | &nbsp;&nbsp;2&nbsp; | &nbsp;&nbsp;.&nbsp; | &nbsp;&nbsp;.&nbsp; | &nbsp;&nbsp;.&nbsp; | &nbsp;&nbsp;.&nbsp; | &nbsp;&nbsp;.&nbsp; | &nbsp;&nbsp;2&nbsp; | &nbsp;&nbsp;.&nbsp; | &nbsp;&nbsp;2&nbsp; | &nbsp;&nbsp;1&nbsp; | &nbsp;&nbsp;1&nbsp; | &nbsp;&nbsp;1&nbsp; | &nbsp;&nbsp;1&nbsp; | &nbsp;&nbsp;1&nbsp; | &nbsp;&nbsp;1&nbsp; | &nbsp;&nbsp;1&nbsp; | &nbsp;&nbsp;1&nbsp; | &nbsp;&nbsp;.&nbsp; | &nbsp;&nbsp;.&nbsp; | &nbsp;&nbsp;.&nbsp; | &nbsp;&nbsp;.&nbsp; | &nbsp;&nbsp;.&nbsp; | &nbsp;&nbsp;.&nbsp; | &nbsp;&nbsp;.&nbsp; | &nbsp;&nbsp;.&nbsp; | &nbsp;&nbsp;19&nbsp; | &nbsp;&nbsp;Total 3D printed parts count |

<span></span>
[Top](#TOP)

---

## X Carriage Insert Assembly
### Vitamins
|Qty|Description|
|---:|:---|
|4| Heatfit insert M3 x 4mm|

### 3D Printed parts

| 1 x [x_carriage.stl](stls/x_carriage.stl) |
|---|
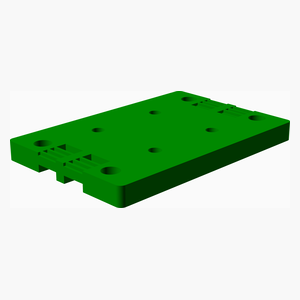
[picture p2: stls/x_carriage.png]
x_carriage.stl
|  

### Assembly instructions
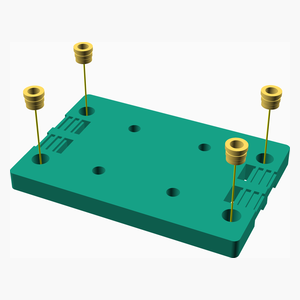
[picture p3: assemblies/x_carriage_insert_assembly_tn.png]
x_carriage_insert_assembly


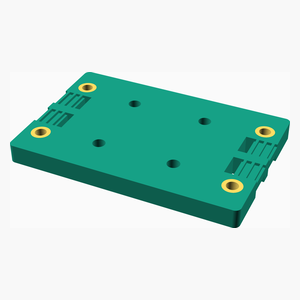
[picture p4: assemblies/x_carriage_insert_assembled_tn.png]
x_carriage_insert_assembled


<span></span>
[Top](#TOP)

---

## X Carriage Assembly
### Vitamins
|Qty|Description|
|---:|:---|
|4| Screw M3 cap x 10mm|

### 3D Printed parts

| 2 x [x_belt_clamp.stl](stls/x_belt_clamp.stl) |
|---|
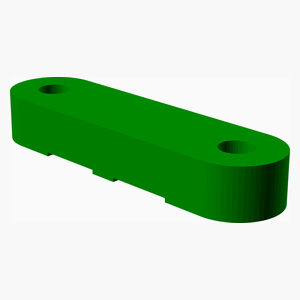
[picture p5: stls/x_belt_clamp.png]
x_belt_clamp.stl
|  

### Sub-assemblies

| 1 x x_carriage_insert_assembly |
|---|
| x_carriage_insert_assembled 

### Assembly instructions
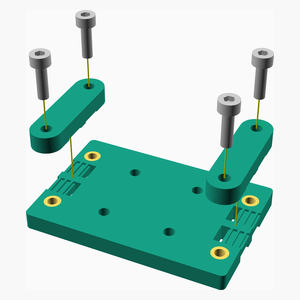
[picture p6: assemblies/x_carriage_assembly_tn.png]
x_carriage_assembly


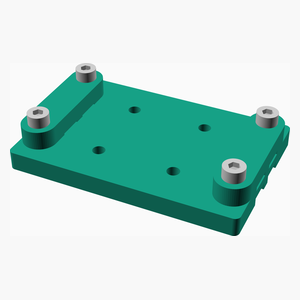
[picture p7: assemblies/x_carriage_assembled_tn.png]
x_carriage_assembled


<span></span>
[Top](#TOP)

---

## 8 x Idler Assembly
### Vitamins
|Qty|Description|
|---:|:---|
|16| Ball bearing F623-2RS 3mm x 10mm x 4mm|
|24| Washer  M3 x 7mm x 0.5mm|

### Assembly instructions
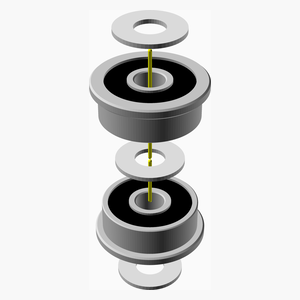
[picture p8: assemblies/idler_assembly_tn.png]
idler_assembly


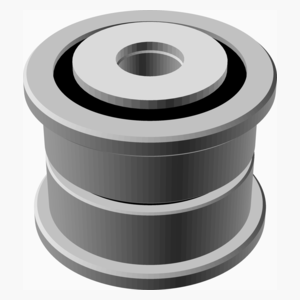
[picture p9: assemblies/idler_assembled_tn.png]
idler_assembled


<span></span>
[Top](#TOP)

---

## Right Y Carriage Assembly
### Vitamins
|Qty|Description|
|---:|:---|
|2| Nut M4 x 3.2mm |
|2| Screw M3 cap x 45mm|
|2| Washer  M3 x 7mm x 0.5mm|
|2| Washer  M4 x 9mm x 0.8mm|

### 3D Printed parts

| 1 x [right_lower_y_carriage.stl](stls/right_lower_y_carriage.stl) | 1 x [right_y_carriage.stl](stls/right_y_carriage.stl) |
|---|---|
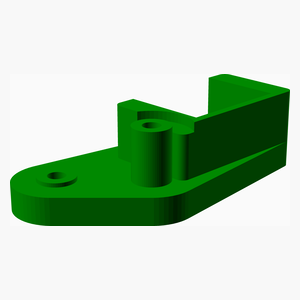
[picture p10: stls/right_lower_y_carriage.png]
right_lower_y_carriage.stl
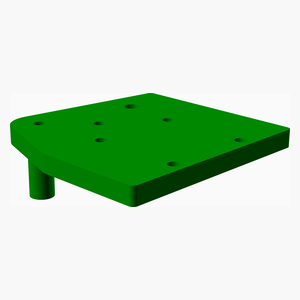
[picture p11: stls/right_y_carriage.png]
right_y_carriage.stl
|  |  

### Sub-assemblies

| 2 x idler_assembly |
|---|
| idler_assembled 

### Assembly instructions
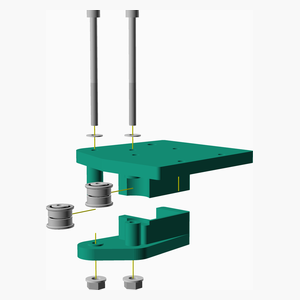
[picture p12: assemblies/right_y_carriage_assembly_tn.png]
right_y_carriage_assembly


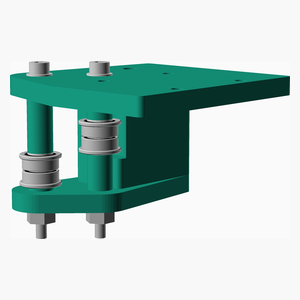
[picture p13: assemblies/right_y_carriage_assembled_tn.png]
right_y_carriage_assembled


<span></span>
[Top](#TOP)

---

## Left Y Carriage Assembly
### Vitamins
|Qty|Description|
|---:|:---|
|2| Nut M4 x 3.2mm |
|2| Screw M3 cap x 45mm|
|2| Washer  M3 x 7mm x 0.5mm|
|2| Washer  M4 x 9mm x 0.8mm|

### 3D Printed parts

| 1 x [left_lower_y_carriage.stl](stls/left_lower_y_carriage.stl) | 1 x [left_y_carriage.stl](stls/left_y_carriage.stl) |
|---|---|
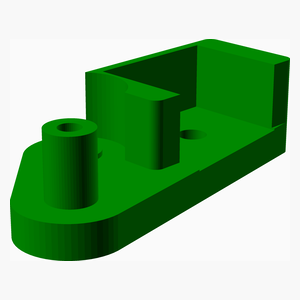
[picture p14: stls/left_lower_y_carriage.png]
left_lower_y_carriage.stl
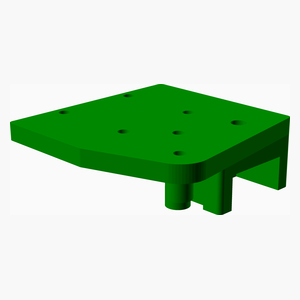
[picture p15: stls/left_y_carriage.png]
left_y_carriage.stl
|  |  

### Sub-assemblies

| 2 x idler_assembly |
|---|
| idler_assembled 

### Assembly instructions
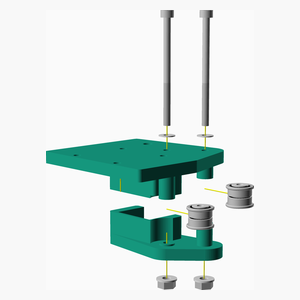
[picture p16: assemblies/left_y_carriage_assembly_tn.png]
left_y_carriage_assembly


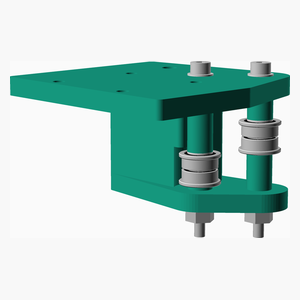
[picture p17: assemblies/left_y_carriage_assembled_tn.png]
left_y_carriage_assembled


<span></span>
[Top](#TOP)

---

## X Rail Carriage Assembly
### Vitamins
|Qty|Description|
|---:|:---|
|1| Extrusion E2020 x 450mm|
|1| Linear rail MGN12 x 400mm|
|1| Linear rail carriage MGN12H|
|16| Nut M3 sliding T|
|14| Screw M3 cap x 10mm|
|2| Screw M3 cs cap x 12mm|

### Assembly instructions
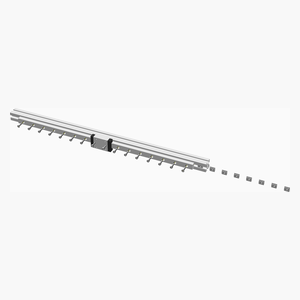
[picture p18: assemblies/x_rail_carriage_assembly_tn.png]
x_rail_carriage_assembly


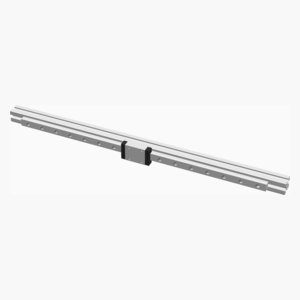
[picture p19: assemblies/x_rail_carriage_assembled_tn.png]
x_rail_carriage_assembled


<span></span>
[Top](#TOP)

---

## X Rail Left Assembly
### Vitamins
|Qty|Description|
|---:|:---|
|2| Nut M3 sliding T|
|1| Screw M4 flanged x 10mm|
|1| Screw M4 flanged x 16mm|

### Sub-assemblies

| 1 x left_y_carriage_assembly | 1 x x_rail_carriage_assembly |
|---|---|
| left_y_carriage_assembled | x_rail_carriage_assembled 

### Assembly instructions
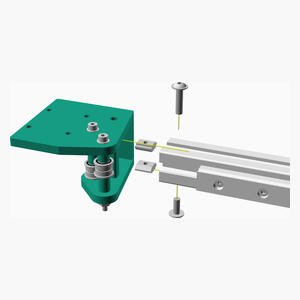
[picture p20: assemblies/x_rail_left_assembly_tn.png]
x_rail_left_assembly


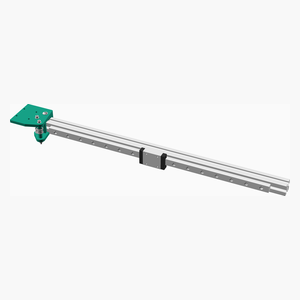
[picture p21: assemblies/x_rail_left_assembled_tn.png]
x_rail_left_assembled


<span></span>
[Top](#TOP)

---

## X Rail Assembly
### Vitamins
|Qty|Description|
|---:|:---|
|2| Nut M3 sliding T|
|1| Screw M4 flanged x 10mm|
|1| Screw M4 flanged x 16mm|

### Sub-assemblies

| 1 x right_y_carriage_assembly | 1 x x_rail_left_assembly |
|---|---|
| right_y_carriage_assembled | x_rail_left_assembled 

### Assembly instructions
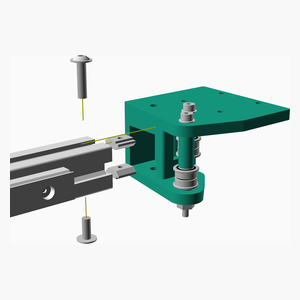
[picture p22: assemblies/x_rail_assembly_tn.png]
x_rail_assembly


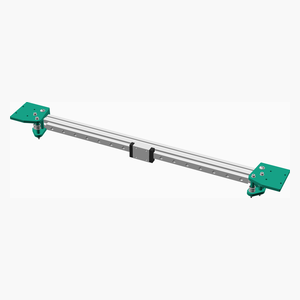
[picture p23: assemblies/x_rail_assembled_tn.png]
x_rail_assembled


<span></span>
[Top](#TOP)

---

## 2 x Double Idler Assembly
### Vitamins
|Qty|Description|
|---:|:---|
|8| Ball bearing F623-2RS 3mm x 10mm x 4mm|
|14| Washer  M3 x 7mm x 0.5mm|

### Assembly instructions
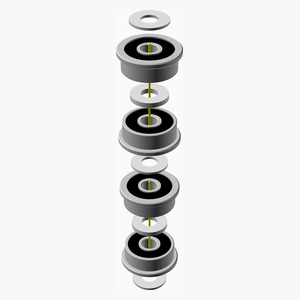
[picture p24: assemblies/double_idler_assembly_tn.png]
double_idler_assembly


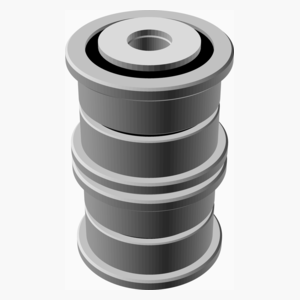
[picture p25: assemblies/double_idler_assembled_tn.png]
double_idler_assembled


<span></span>
[Top](#TOP)

---

## Right Motor Pulley Assembly
### Vitamins
|Qty|Description|
|---:|:---|
|1| Pulley GT2OB 20 teeth|
|2| Screw M3 grub x  6mm|
|1| Stepper motor NEMA17 x 47mm (5x24 shaft)|

### Assembly instructions
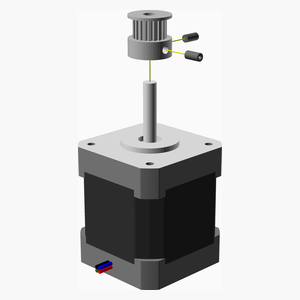
[picture p26: assemblies/right_motor_pulley_assembly_tn.png]
right_motor_pulley_assembly


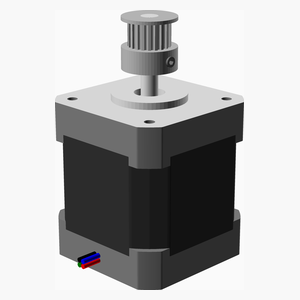
[picture p27: assemblies/right_motor_pulley_assembled_tn.png]
right_motor_pulley_assembled


<span></span>
[Top](#TOP)

---

## Right Motor Assembly
### Vitamins
|Qty|Description|
|---:|:---|
|4| Screw M3 cap x 35mm|
|4| Washer  M3 x 7mm x 0.5mm|

### 3D Printed parts

| 1 x [right_lower_motor_mount.stl](stls/right_lower_motor_mount.stl) | 1 x [right_motor_mount.stl](stls/right_motor_mount.stl) |
|---|---|
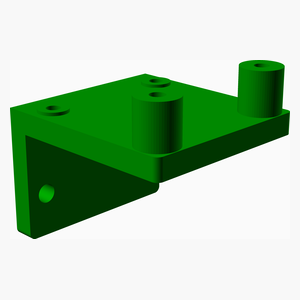
[picture p28: stls/right_lower_motor_mount.png]
right_lower_motor_mount.stl
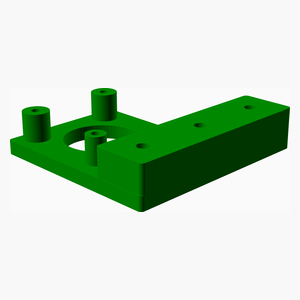
[picture p29: stls/right_motor_mount.png]
right_motor_mount.stl
|  |  

### Sub-assemblies

| 1 x double_idler_assembly | 1 x idler_assembly | 1 x right_motor_pulley_assembly |
|---|---|---|
| double_idler_assembled | idler_assembled | right_motor_pulley_assembled 

### Assembly instructions
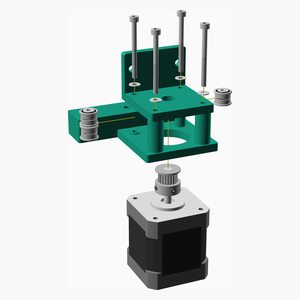
[picture p30: assemblies/right_motor_assembly_tn.png]
right_motor_assembly


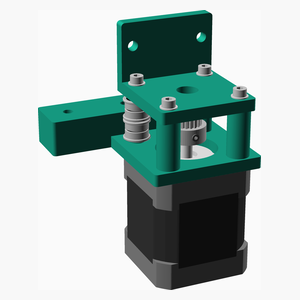
[picture p31: assemblies/right_motor_assembled_tn.png]
right_motor_assembled


<span></span>
[Top](#TOP)

---

## Left Motor Pulley Assembly
### Vitamins
|Qty|Description|
|---:|:---|
|1| Pulley GT2OB 20 teeth|
|2| Screw M3 grub x  6mm|
|1| Stepper motor NEMA17 x 47mm (5x24 shaft)|

### Assembly instructions
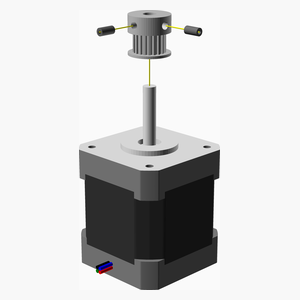
[picture p32: assemblies/left_motor_pulley_assembly_tn.png]
left_motor_pulley_assembly


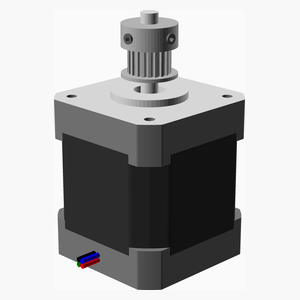
[picture p33: assemblies/left_motor_pulley_assembled_tn.png]
left_motor_pulley_assembled


<span></span>
[Top](#TOP)

---

## Left Motor Assembly
### Vitamins
|Qty|Description|
|---:|:---|
|4| Screw M3 cap x 35mm|
|4| Washer  M3 x 7mm x 0.5mm|

### 3D Printed parts

| 1 x [left_lower_motor_mount.stl](stls/left_lower_motor_mount.stl) | 1 x [left_motor_mount.stl](stls/left_motor_mount.stl) |
|---|---|
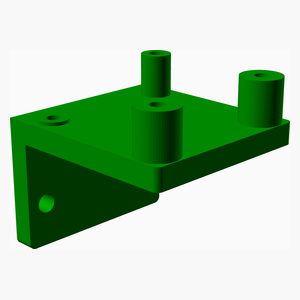
[picture p34: stls/left_lower_motor_mount.png]
left_lower_motor_mount.stl
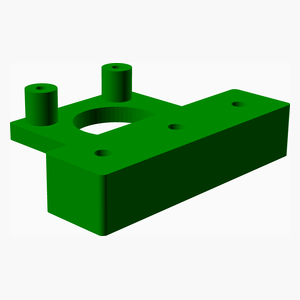
[picture p35: stls/left_motor_mount.png]
left_motor_mount.stl
|  |  

### Sub-assemblies

| 1 x double_idler_assembly | 1 x idler_assembly | 1 x left_motor_pulley_assembly |
|---|---|---|
| double_idler_assembled | idler_assembled | left_motor_pulley_assembled 

### Assembly instructions
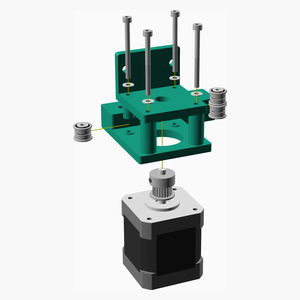
[picture p36: assemblies/left_motor_assembly_tn.png]
left_motor_assembly


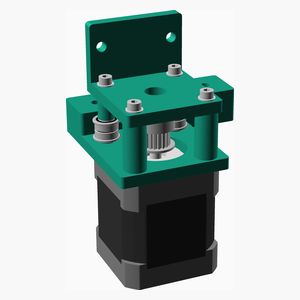
[picture p37: assemblies/left_motor_assembled_tn.png]
left_motor_assembled


<span></span>
[Top](#TOP)

---

## Right Inner Idler Assembly
### Vitamins
|Qty|Description|
|---:|:---|
|1| Screw M3 grub x 20mm|
|2| Screw M4 flanged x 45mm|

### 3D Printed parts

| 1 x [right_front_idler.stl](stls/right_front_idler.stl) |
|---|
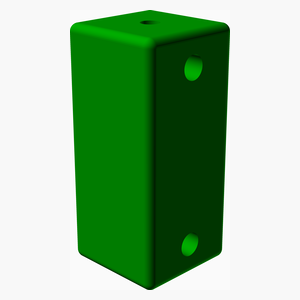
[picture p38: stls/right_front_idler.png]
right_front_idler.stl
|  

### Sub-assemblies

| 1 x idler_assembly |
|---|
| idler_assembled 

### Assembly instructions
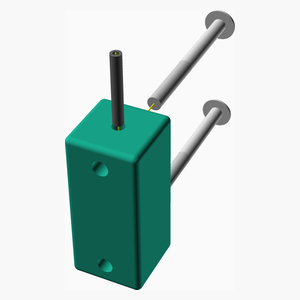
[picture p39: assemblies/right_inner_idler_assembly_tn.png]
right_inner_idler_assembly


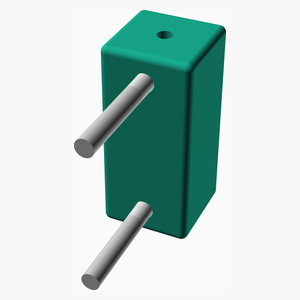
[picture p40: assemblies/right_inner_idler_assembled_tn.png]
right_inner_idler_assembled


<span></span>
[Top](#TOP)

---

## Right Idler Assembly
### Vitamins
|Qty|Description|
|---:|:---|
|2| Nut M4 x 3.2mm |

### 3D Printed parts

| 1 x [right_idler_mount.stl](stls/right_idler_mount.stl) |
|---|
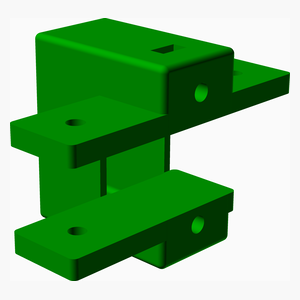
[picture p41: stls/right_idler_mount.png]
right_idler_mount.stl
|  

### Sub-assemblies

| 1 x right_inner_idler_assembly |
|---|
| right_inner_idler_assembled 

### Assembly instructions
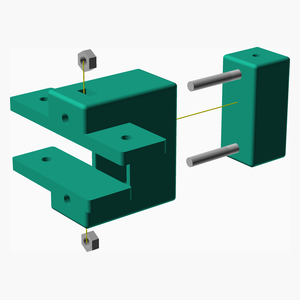
[picture p42: assemblies/right_idler_assembly_tn.png]
right_idler_assembly


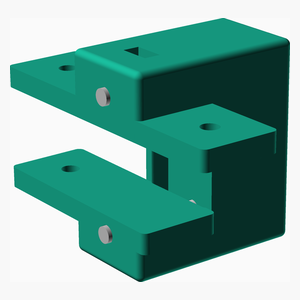
[picture p43: assemblies/right_idler_assembled_tn.png]
right_idler_assembled


<span></span>
[Top](#TOP)

---

## Left Inner Idler Assembly
### Vitamins
|Qty|Description|
|---:|:---|
|1| Screw M3 grub x 20mm|
|2| Screw M4 flanged x 45mm|

### 3D Printed parts

| 1 x [left_front_idler.stl](stls/left_front_idler.stl) |
|---|
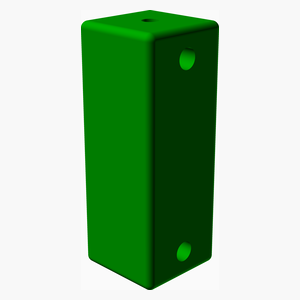
[picture p44: stls/left_front_idler.png]
left_front_idler.stl
|  

### Sub-assemblies

| 1 x idler_assembly |
|---|
| idler_assembled 

### Assembly instructions
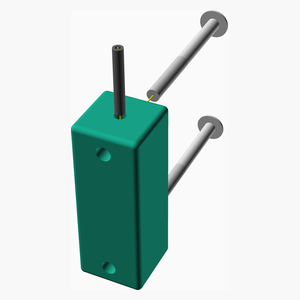
[picture p45: assemblies/left_inner_idler_assembly_tn.png]
left_inner_idler_assembly


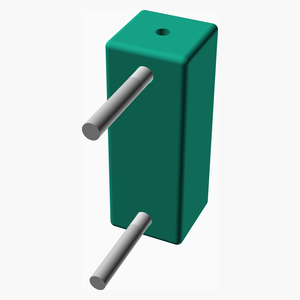
[picture p46: assemblies/left_inner_idler_assembled_tn.png]
left_inner_idler_assembled


<span></span>
[Top](#TOP)

---

## Left Idler Assembly
### Vitamins
|Qty|Description|
|---:|:---|
|2| Nut M4 x 3.2mm |

### 3D Printed parts

| 1 x [left_idler_mount.stl](stls/left_idler_mount.stl) |
|---|
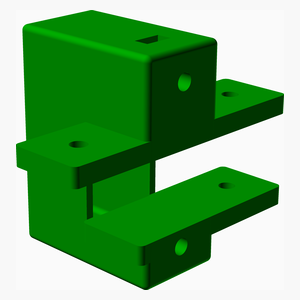
[picture p47: stls/left_idler_mount.png]
left_idler_mount.stl
|  

### Sub-assemblies

| 1 x left_inner_idler_assembly |
|---|
| left_inner_idler_assembled 

### Assembly instructions
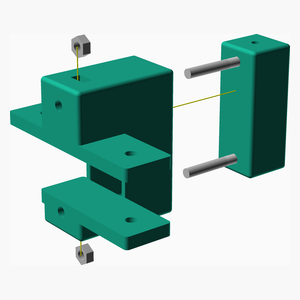
[picture p48: assemblies/left_idler_assembly_tn.png]
left_idler_assembly


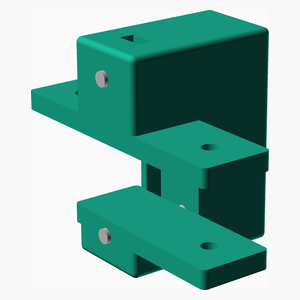
[picture p49: assemblies/left_idler_assembled_tn.png]
left_idler_assembled


<span></span>
[Top](#TOP)

---

## Front Frame Left Assembly
### Vitamins
|Qty|Description|
|---:|:---|
|1| Extrusion E2040 x 472mm|
|4| Nut M4 sliding T|
|1| Screw M4 flanged x 10mm|
|1| Screw M5 low profile x 10mm|

### 3D Printed parts

| 1 x [left_front_corner.stl](stls/left_front_corner.stl) |
|---|
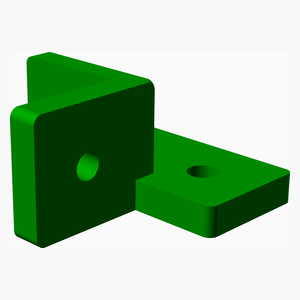
[picture p50: stls/left_front_corner.png]
left_front_corner.stl
|  

### Assembly instructions
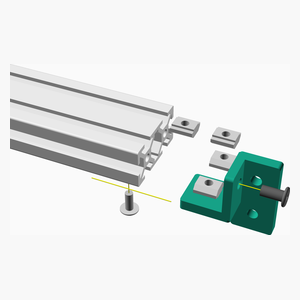
[picture p51: assemblies/front_frame_left_assembly_tn.png]
front_frame_left_assembly


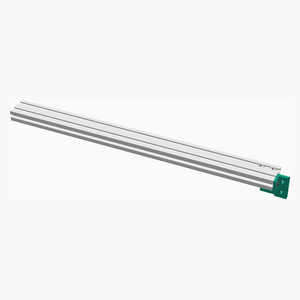
[picture p52: assemblies/front_frame_left_assembled_tn.png]
front_frame_left_assembled


<span></span>
[Top](#TOP)

---

## Front Frame Assembly
### Vitamins
|Qty|Description|
|---:|:---|
|4| Nut M4 sliding T|
|1| Screw M4 flanged x 10mm|
|1| Screw M5 low profile x 10mm|

### 3D Printed parts

| 1 x [right_front_corner.stl](stls/right_front_corner.stl) |
|---|
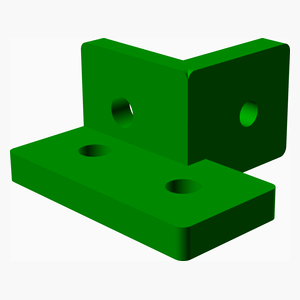
[picture p53: stls/right_front_corner.png]
right_front_corner.stl
|  

### Sub-assemblies

| 1 x front_frame_left_assembly |
|---|
| front_frame_left_assembled 

### Assembly instructions
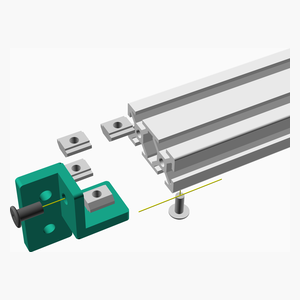
[picture p54: assemblies/front_frame_assembly_tn.png]
front_frame_assembly


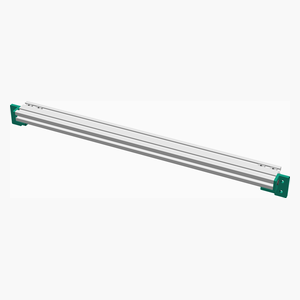
[picture p55: assemblies/front_frame_assembled_tn.png]
front_frame_assembled


<span></span>
[Top](#TOP)

---

## Back Frame Left Assembly
### Vitamins
|Qty|Description|
|---:|:---|
|1| Extrusion E2040 x 472mm|
|7| Nut M4 sliding T|
|3| Screw M4 flanged x 10mm|

### 3D Printed parts

| 1 x [left_back_corner.stl](stls/left_back_corner.stl) |
|---|
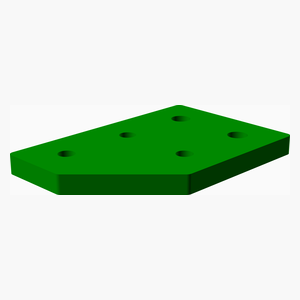
[picture p56: stls/left_back_corner.png]
left_back_corner.stl
|  

### Assembly instructions
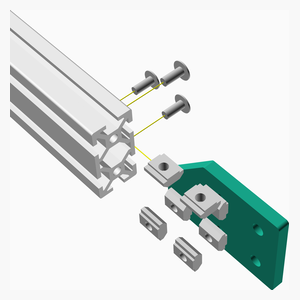
[picture p57: assemblies/back_frame_left_assembly_tn.png]
back_frame_left_assembly


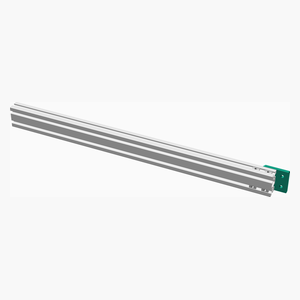
[picture p58: assemblies/back_frame_left_assembled_tn.png]
back_frame_left_assembled


<span></span>
[Top](#TOP)

---

## Back Frame Assembly
### Vitamins
|Qty|Description|
|---:|:---|
|7| Nut M4 sliding T|
|3| Screw M4 flanged x 10mm|

### 3D Printed parts

| 1 x [right_back_corner.stl](stls/right_back_corner.stl) |
|---|
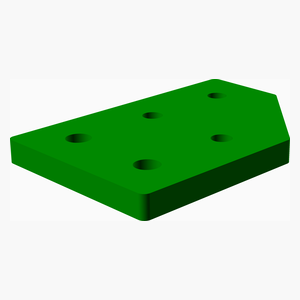
[picture p59: stls/right_back_corner.png]
right_back_corner.stl
|  

### Sub-assemblies

| 1 x back_frame_left_assembly |
|---|
| back_frame_left_assembled 

### Assembly instructions
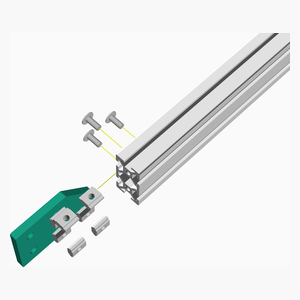
[picture p60: assemblies/back_frame_assembly_tn.png]
back_frame_assembly


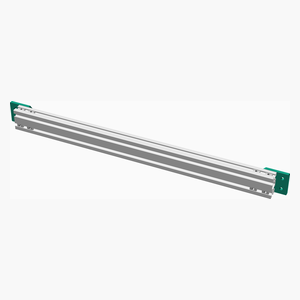
[picture p61: assemblies/back_frame_assembled_tn.png]
back_frame_assembled


<span></span>
[Top](#TOP)

---

## 2 x Y Rail Assembly
### Vitamins
|Qty|Description|
|---:|:---|
|2| Extrusion E2040 x 354mm|
|2| Linear rail MGN15 x 300mm|
|2| Linear rail carriage MGN15H|
|16| Nut M3 sliding T|
|12| Screw M3 cap x 10mm|
|4| Screw M3 cs cap x 12mm|

### Assembly instructions
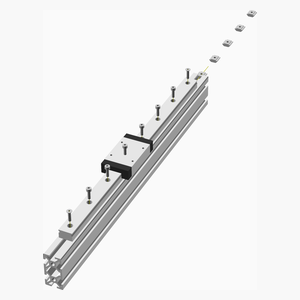
[picture p62: assemblies/y_rail_assembly_tn.png]
y_rail_assembly


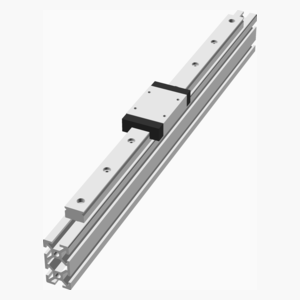
[picture p63: assemblies/y_rail_assembled_tn.png]
y_rail_assembled


<span></span>
[Top](#TOP)

---

## Back And Y Assembly
### Vitamins
|Qty|Description|
|---:|:---|
|2| Nut M4 sliding T|
|4| Screw M5 flanged x 10mm|

### Sub-assemblies

| 1 x back_frame_assembly | 2 x y_rail_assembly |
|---|---|
| back_frame_assembled | y_rail_assembled 

### Assembly instructions
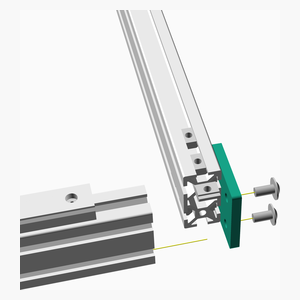
[picture p64: assemblies/back_and_y_assembly_tn.png]
back_and_y_assembly


Repeat for both back corners

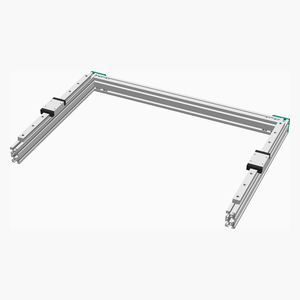
[picture p65: assemblies/back_and_y_assembled_tn.png]
back_and_y_assembled


<span></span>
[Top](#TOP)

---

## Frame Assembly
### Vitamins
|Qty|Description|
|---:|:---|
|2| Nut M4 sliding T|
|2| Screw M5 flanged x 10mm|
|2| Screw M5 low profile x 10mm|

### Sub-assemblies

| 1 x back_and_y_assembly | 1 x front_frame_assembly |
|---|---|
| back_and_y_assembled | front_frame_assembled 

### Assembly instructions
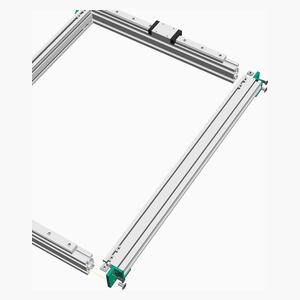
[picture p66: assemblies/frame_assembly_tn.png]
frame_assembly


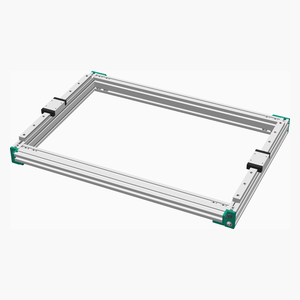
[picture p67: assemblies/frame_assembled_tn.png]
frame_assembled


<span></span>
[Top](#TOP)

---

## Frame Idler Assembly
### Vitamins
|Qty|Description|
|---:|:---|
|6| Screw M4 flanged x 10mm|

### Sub-assemblies

| 1 x frame_assembly | 1 x left_idler_assembly | 1 x right_idler_assembly |
|---|---|---|
| frame_assembled | left_idler_assembled | right_idler_assembled 

### Assembly instructions
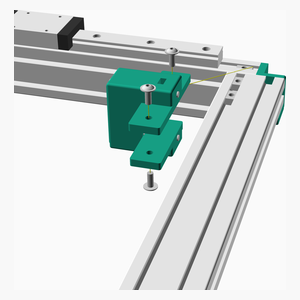
[picture p68: assemblies/frame_idler_assembly_tn.png]
frame_idler_assembly


Repeat at both front idler mounts

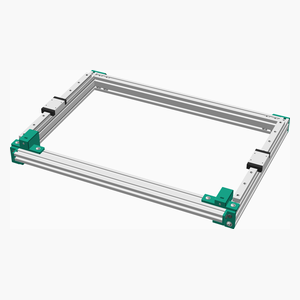
[picture p69: assemblies/frame_idler_assembled_tn.png]
frame_idler_assembled


<span></span>
[Top](#TOP)

---

## Frame Motor Assembly
### Vitamins
|Qty|Description|
|---:|:---|
|10| Screw M4 flanged x 10mm|

### Sub-assemblies

| 1 x frame_idler_assembly | 1 x left_motor_assembly | 1 x right_motor_assembly |
|---|---|---|
| frame_idler_assembled | left_motor_assembled | right_motor_assembled 

### Assembly instructions
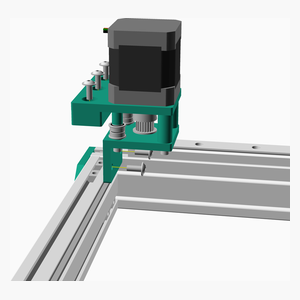
[picture p70: assemblies/frame_motor_assembly_tn.png]
frame_motor_assembly


Repeat at both motor mounts

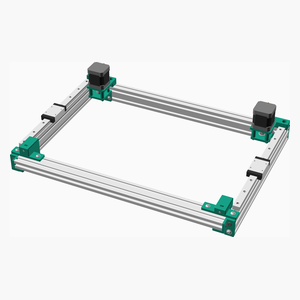
[picture p71: assemblies/frame_motor_assembled_tn.png]
frame_motor_assembled


<span></span>
[Top](#TOP)

---

## Frame X Rail Assembly
### Vitamins
|Qty|Description|
|---:|:---|
|8| Screw M3 cap x 10mm|
|8| Washer  M3 x 7mm x 0.5mm|

### Sub-assemblies

| 1 x frame_motor_assembly | 1 x x_rail_assembly |
|---|---|
| frame_motor_assembled | x_rail_assembled 

### Assembly instructions
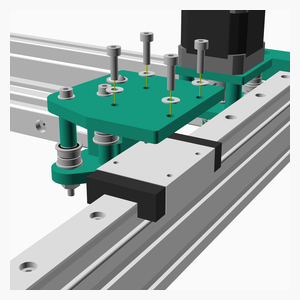
[picture p72: assemblies/frame_x_rail_assembly_tn.png]
frame_x_rail_assembly


Repeat at both y carriages

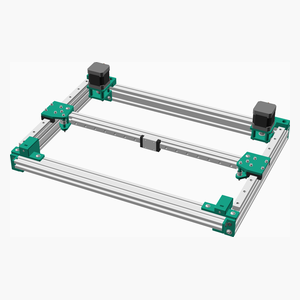
[picture p73: assemblies/frame_x_rail_assembled_tn.png]
frame_x_rail_assembled


<span></span>
[Top](#TOP)

---

## Frame X Carriage Assembly
### Vitamins
|Qty|Description|
|---:|:---|
|4| Screw M3 cap x 10mm|
|4| Washer  M3 x 7mm x 0.5mm|

### Sub-assemblies

| 1 x frame_x_rail_assembly | 1 x x_carriage_assembly |
|---|---|
| frame_x_rail_assembled | x_carriage_assembled 

### Assembly instructions
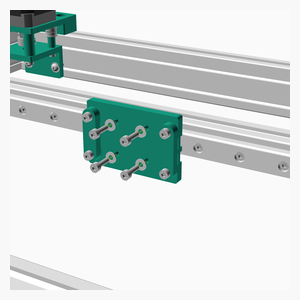
[picture p74: assemblies/frame_x_carriage_assembly_tn.png]
frame_x_carriage_assembly


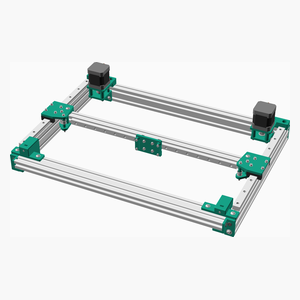
[picture p75: assemblies/frame_x_carriage_assembled_tn.png]
frame_x_carriage_assembled


<span></span>
[Top](#TOP)

---

## Main Assembly
### Vitamins
|Qty|Description|
|---:|:---|
|1| Belt GT2 x 6mm x 1524mm|
|1| Belt GT2 x 6mm x 1524mm|

### Sub-assemblies

| 1 x frame_x_carriage_assembly |
|---|
| frame_x_carriage_assembled 

### Assembly instructions
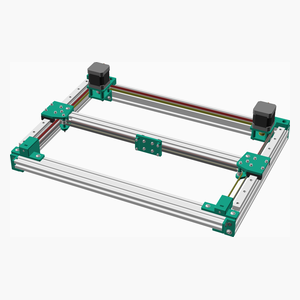
[picture p76: assemblies/main_assembly_tn.png]
main_assembly


Put the belts in with front idlers as loose then
tighten the clamps. Finally, tighten the idlers
evenly.

main_assembled

<span></span>
[Top](#TOP)
