beanz/m-draw-scad/stls/x_belt_clamp.stl

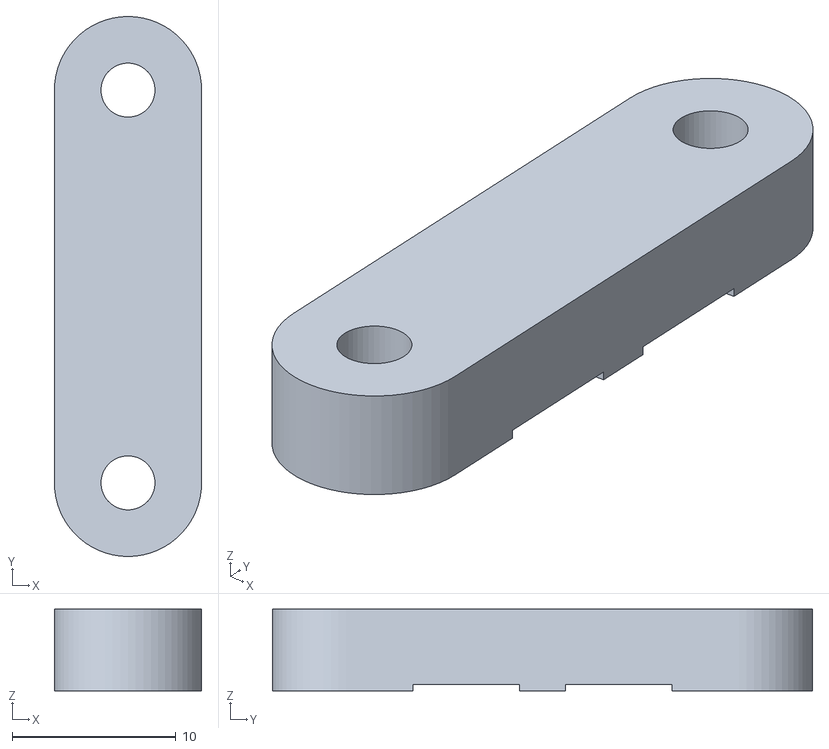
[picture p77: CAD file, 2025-06-01]
stls/x_belt_clamp.stl
9.00 x 33.0 x 5.00
