beanz/m-draw-scad/stls/x_carriage.stl

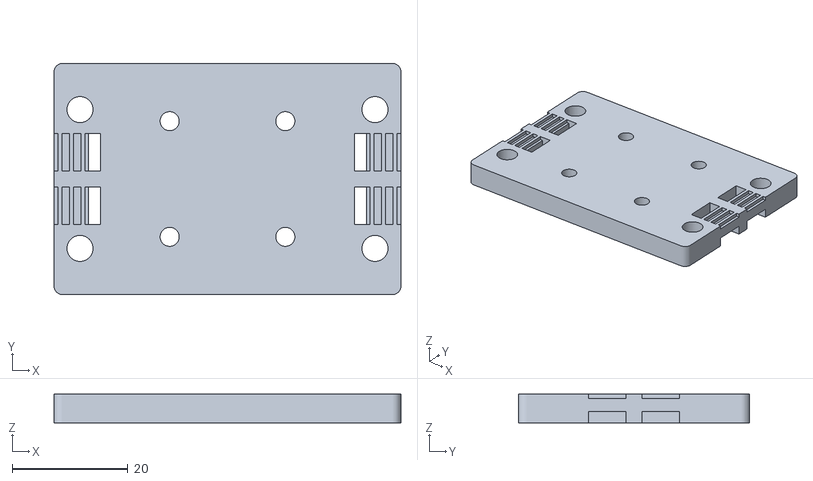
[picture p78: CAD file, 2025-06-01]
stls/x_carriage.stl
60.0 x 40.0 x 5.00
