beanz/m-draw-scad/stls/right_front_corner.stl

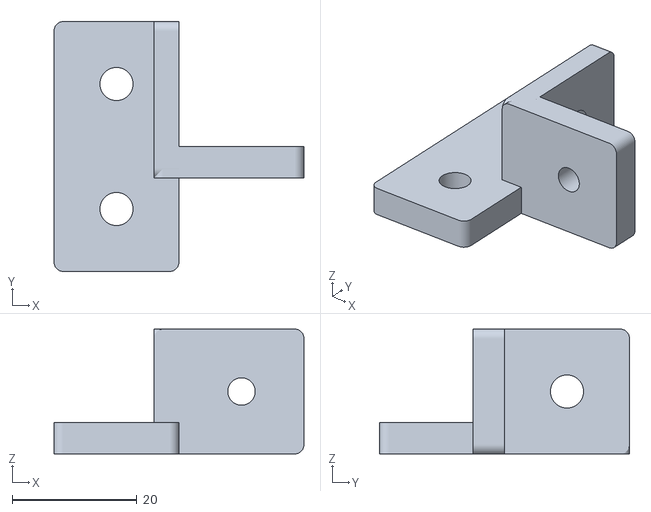
[picture p79: CAD file, 2025-06-01]
stls/right_front_corner.stl
40.0 x 40.0 x 20.0
