beanz/m-draw-scad/stls/right_idler_mount.stl

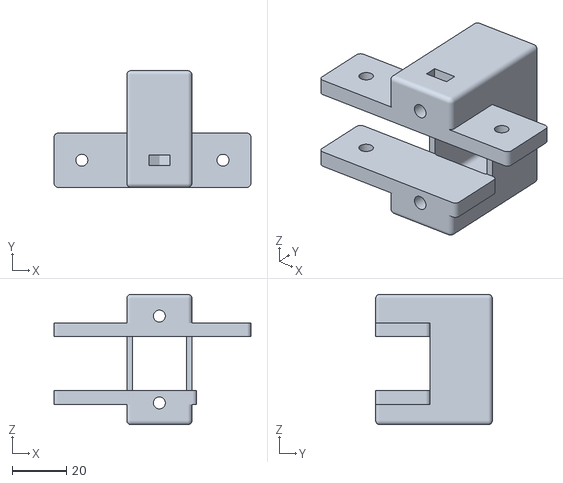
[picture p80: CAD file, 2025-06-01]
stls/right_idler_mount.stl
72.6 x 43.0 x 48.0
