beanz/m-draw-scad/stls/left_idler_mount.stl

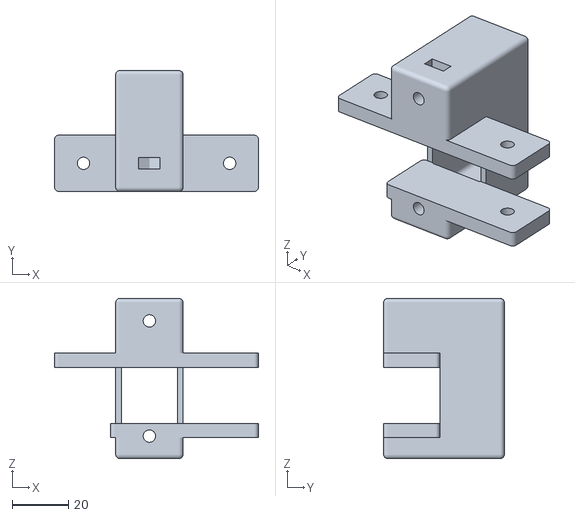
[picture p81: CAD file, 2025-06-01]
stls/left_idler_mount.stl
72.6 x 43.0 x 57.0
