beanz/m-draw-scad/stls/left_lower_y_carriage.stl

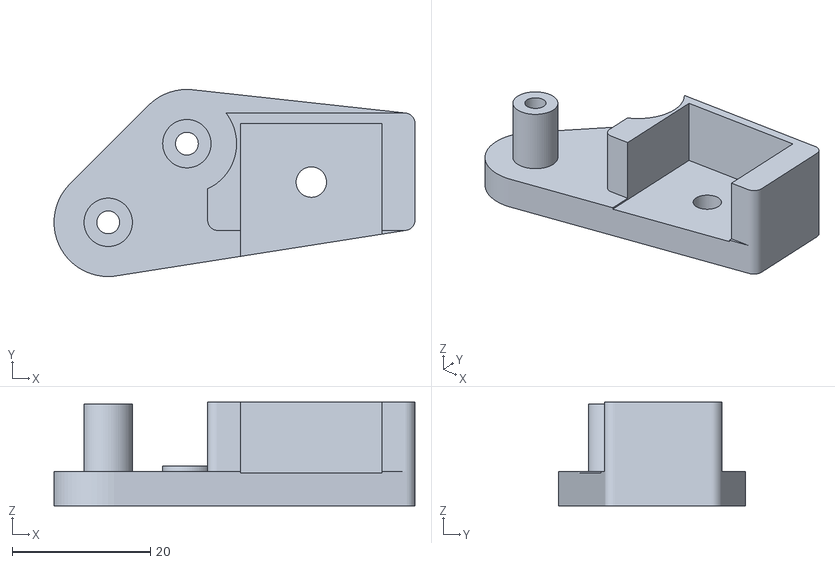
[picture p82: CAD file, 2025-06-01]
stls/left_lower_y_carriage.stl
52.2 x 27.1 x 15.0
