beanz/m-draw-scad/stls/right_lower_motor_mount.stl

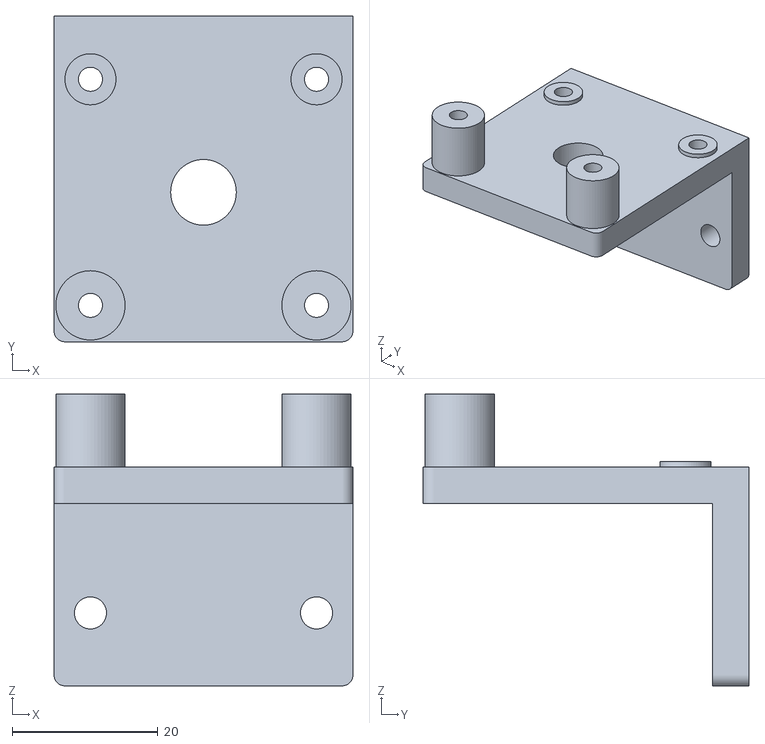
[picture p83: CAD file, 2025-06-01]
stls/right_lower_motor_mount.stl
41.0 x 44.6 x 40.0
