beanz/m-draw-scad/stls/right_motor_mount.stl

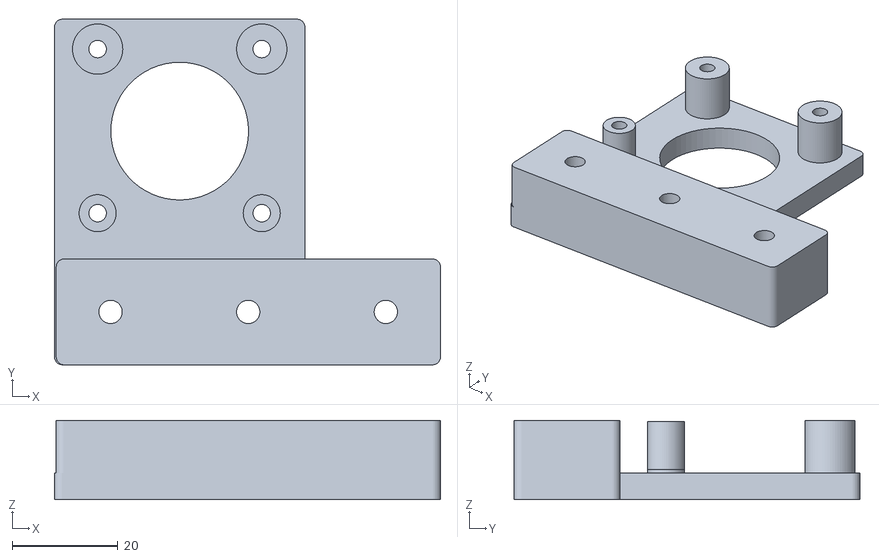
[picture p84: CAD file, 2025-06-01]
stls/right_motor_mount.stl
72.9 x 65.3 x 15.0
