beanz/m-draw-scad/stls/left_front_idler.stl

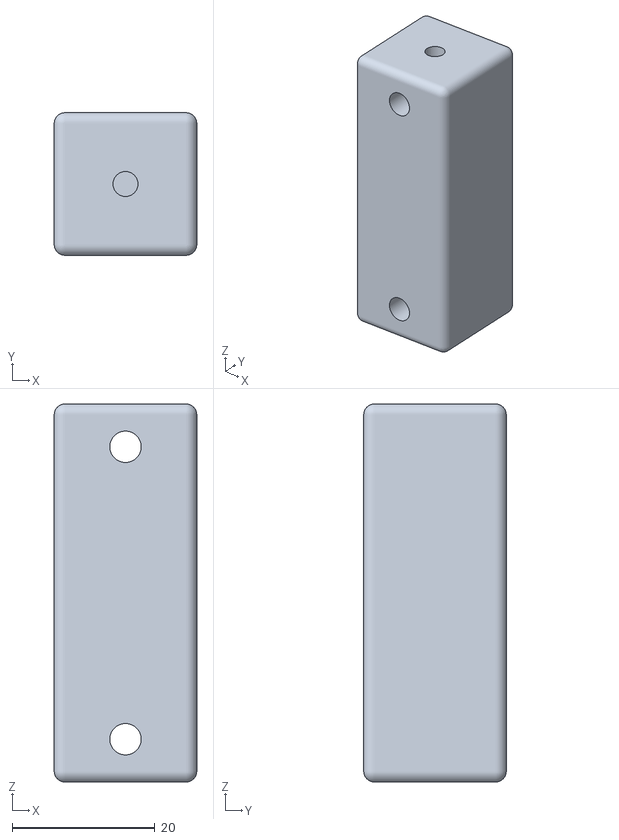
[picture p85: CAD file, 2025-06-01]
stls/left_front_idler.stl
20.0 x 20.0 x 53.0
