beanz/m-draw-scad/stls/right_back_corner.stl

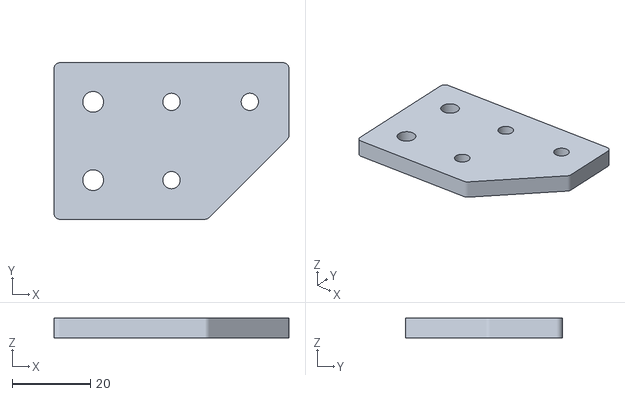
[picture p86: CAD file, 2025-06-01]
stls/right_back_corner.stl
60.0 x 40.0 x 5.00
