beanz/m-draw-scad/stls/right_lower_y_carriage.stl

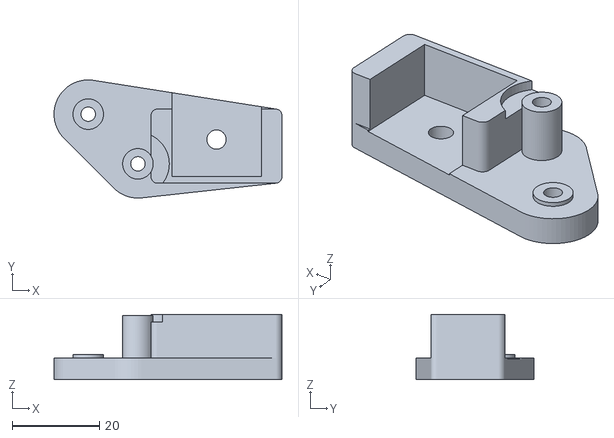
[picture p87: CAD file, 2025-06-01]
stls/right_lower_y_carriage.stl
52.2 x 27.1 x 15.0
