beanz/m-draw-scad/stls/right_y_carriage.stl

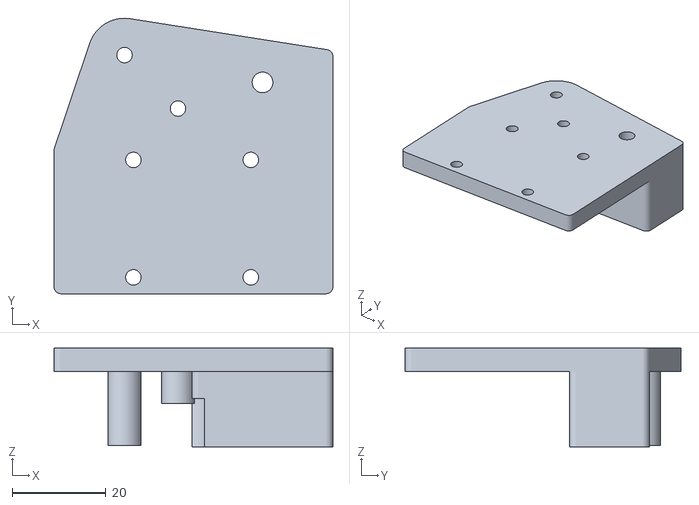
[picture p88: CAD file, 2025-06-01]
stls/right_y_carriage.stl
59.4 x 58.7 x 21.0
