beanz/m-draw-scad/stls/right_front_idler.stl

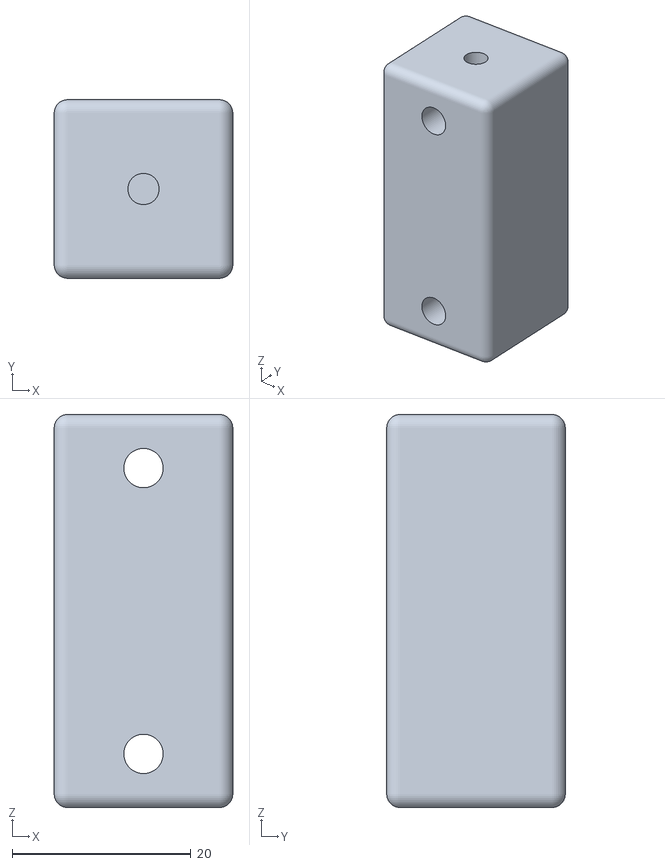
[picture p89: CAD file, 2025-06-01]
stls/right_front_idler.stl
20.0 x 20.0 x 44.0
