beanz/m-draw-scad/stls/left_lower_motor_mount.stl

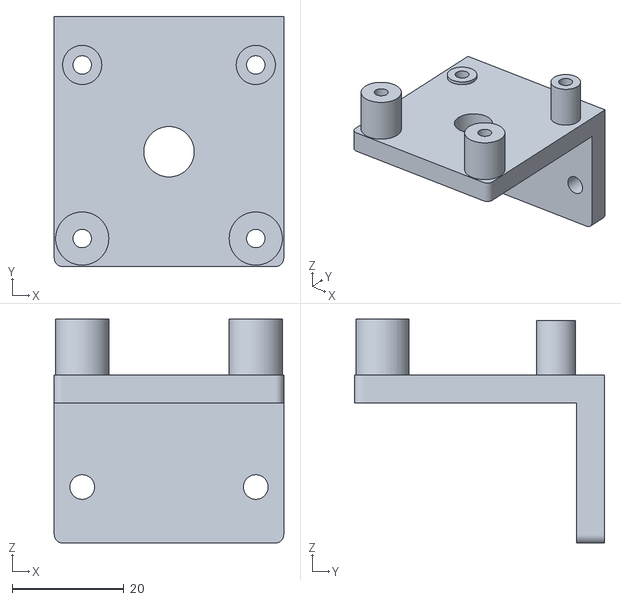
[picture p90: CAD file, 2025-06-01]
stls/left_lower_motor_mount.stl
41.0 x 44.6 x 40.0
