beanz/m-draw-scad/scad/idlers.scad

include <conf.scad>
include <lazy.scad>
include <shapes.scad>

module left_idler_assembly()
    pose([70, 0, 52], [-14, 2, -8]) assembly("left_idler") {
  left_idler_mount_stl();
  txyz(-NEMA_hole_pitch(NEMA17_47)/2, -10,
       -(ew2-top_belt_h-idler_h/2)-idler_h/2) {
    explode([0, 60, 0]) left_inner_idler_assembly();
    for (z = [12, -20-(top_belt_h-bottom_belt_h)]) {
      tz(z) rx(-90)
       tz(-motor_y_offset+ew-nut_thickness(tensioning_nut)/2)
          explode([0, z < 0 ? 20 : -20, 0]) rz(90) nut(tensioning_nut);
    }
  }
}

module left_idler_mount_stl() stl("left_idler_mount") {
  depth = 43;
  color(print_color) render() difference() {
    union() {
      txy(-motor_x_offset/2+(ew+3)/2, -motor_y_offset+ew/2)
        rrcf([motor_x_offset+NEMA_width(NEMA17_47)/2+th/2, ew, th]);
      txyz(-NEMA_hole_pitch(NEMA17_47)/2,
           -10,
           -(ew2-top_belt_h-idler_h/2)-idler_h/2) {
        tyz(-motor_y_offset+depth/2+ew/2, -4-(top_belt_h-bottom_belt_h)/2)
          rc([24, depth, 48+(top_belt_h-bottom_belt_h)]);
      }
      txyz(-motor_x_offset/2+(ew+3)/2+ew/2, -motor_y_offset+ew/2, -ew-th)
        rrcf([motor_x_offset+NEMA_width(NEMA17_47)/2+th/2-ew, ew, th]);
    }

    // idler slot
    hull() for (y = [10,-4]) {
      txyz(-NEMA_hole_pitch(NEMA17_47)/2,
           y-10,
           -(ew2-top_belt_h-idler_h/2)-idler_h/2) {
        tz(-4-(top_belt_h-bottom_belt_h)/2)
          rc([21,21,45+(top_belt_h-bottom_belt_h)]);
      }
    }

    // tensioning screw holes
    txyz(-NEMA_hole_pitch(NEMA17_47)/2, -10,
           -(ew2-top_belt_h-idler_h/2)-idler_h/2) {
      for (z = [12, -20-(top_belt_h-bottom_belt_h)]) {
        tz(z) rx(-90) {
          cylinder(d = screw_clearance_d(tensioning_screw),
                   h = 80, center = true);
        }
        tz(z) ty(-motor_y_offset+ew) {
          hull() {
            simple_nut_trap(M4_nut);
            tz(z < 0 ? -20 : 20) simple_nut_trap(M4_nut);
          }
        }
      }
    }

    txyz(-motor_x_offset/2+(ew+3)/2, -motor_y_offset+ew/2, -ew/2)
      cc([100, ew, ew]);

    // extrusion mount holes
    for (x = [ew*.5, 72-ew/2]) {
      txy(-motor_x_offset+x, -motor_y_offset+ew*.5) {
        cylinder(d = screw_clearance_d(ex_print_screw),
                 h = 100, center = true);
      }
    }
  }
}

module left_inner_idler_assembly() assembly("left_inner_idler") {
  idler_assembly();
  left_front_idler_stl();
  for (z = [12, -20-(top_belt_h-bottom_belt_h)])
    tz(z) rx(-90) tz(10) screw(tensioning_screw, 45);
  tz(9) screw(front_idler_screw, 20);
}

module left_front_idler_stl() stl("left_front_idler") {
  color(print_color) render() difference() {
    tz(-4-(top_belt_h-bottom_belt_h)/2)
      rc([20,20,44+(top_belt_h-bottom_belt_h)]);
    // belt hole
    hull() {
      cylinder(d = 15, h = idler_h+1, center = true);
      ty(10) cylinder(d = 15, h = idler_h+1, center = true);
    }

    // axle hole
    tz(-11) cylinder(d = 3.5, h = 32);

    // tensioning screw holes
    for (z = [12, -20-(top_belt_h-bottom_belt_h)]) {
      tz(z) rx(-90)
        cylinder(d = screw_clearance_d(tensioning_screw),
                 h = 100, center = true);
    }
  }
}

module right_idler_assembly()
    pose([70, 0, 52], [-1, 14, -15]) assembly("right_idler") {
  right_idler_mount_stl();
  txyz(NEMA_hole_pitch(NEMA17_47)/2, -10,
       -(ew2-bottom_belt_h-idler_h/2)-idler_h/2) {
    explode([0, 60, 0]) right_inner_idler_assembly();
    for (z = [12, -20]) {
      tz(z) rx(-90)
       tz(-motor_y_offset+ew-nut_thickness(tensioning_nut)/2)
          explode([0, z < 0 ? 20 : -20, 0]) rz(90) nut(tensioning_nut);
    }
  }
}

module right_idler_mount_stl() stl("right_idler_mount") {
  depth = 43;
  color(print_color) render() difference() {
    union() {
      txy(+motor_x_offset/2-(ew+3)/2, -motor_y_offset+ew/2)
        rrcf([motor_x_offset+NEMA_width(NEMA17_47)/2+th/2, ew, th]);
      txyz(NEMA_hole_pitch(NEMA17_47)/2,
           -10,
           -(ew2-bottom_belt_h-idler_h/2)-idler_h/2) {
        tyz(-motor_y_offset+depth/2+ew/2, -4)
          rc([24, depth, 48]);
      }
      txyz(+motor_x_offset/2-(ew+3)/2-ew/2, -motor_y_offset+ew/2, -ew-th)
        rrcf([motor_x_offset+NEMA_width(NEMA17_47)/2+th/2-ew, ew, th]);
    }

    // idler slot
    hull() for (y = [10,-4]) {
      txyz(NEMA_hole_pitch(NEMA17_47)/2,
           y-10,
           -(ew2-bottom_belt_h-idler_h/2)-idler_h/2) {
        tz(-4) rc([21,21,45]);
      }
    }

    // tensioning screw holes
    txyz(NEMA_hole_pitch(NEMA17_47)/2, -10,
           -(ew2-bottom_belt_h-idler_h/2)-idler_h/2) {
      for (z = [12, -20]) {
        tz(z) rx(-90) {
          cylinder(d = screw_clearance_d(tensioning_screw),
                   h = 80, center = true);
        }
        tz(z) ty(-motor_y_offset+ew) {
          hull() {
            simple_nut_trap(M4_nut);
            tz(z < 0 ? -20 : 20) simple_nut_trap(M4_nut);
          }
        }
      }
    }

    txyz(+motor_x_offset/2-(ew+3)/2, -motor_y_offset+ew/2, -ew/2)
      cc([100, ew, ew]);

    // extrusion mount holes
    for (x = [ew*.5, 72-ew/2]) {
      txy(motor_x_offset-x, -motor_y_offset+ew*.5) {
        cylinder(d = screw_clearance_d(ex_print_screw),
                 h = 100, center = true);
      }
    }
  }
}

module right_inner_idler_assembly() assembly("right_inner_idler") {
  idler_assembly();
  right_front_idler_stl();
  for (z = [12, -20])
    tz(z) rx(-90) tz(10) screw(tensioning_screw, 45);
  tz(9) screw(front_idler_screw, 20);
}

module right_front_idler_stl() stl("right_front_idler") {
  color(print_color) render() difference() {
    tz(-4) rc([20,20,44]);
    // belt hole
    hull() {
      cylinder(d = 15, h = idler_h+1, center = true);
      ty(10) cylinder(d = 15, h = idler_h+1, center = true);
    }

    // axle hole
    tz(-11) cylinder(d = 3.5, h = 32);

    // tensioning screw holes
    for (z = [12, -20]) {
      tz(z) rx(-90)
        cylinder(d = screw_clearance_d(tensioning_screw),
                 h = 100, center = true);
    }
  }
}

module idler_assembly() assembly("idler") {
  tz(-washer_h(M3_washer)/2) washer(M3_washer);
  mxy(washer_h(M3_washer)/2) {
    explode([0, 0, 5], true) {
      tz(ball_bearing_h(BBF623)/2) {
        mirror([0,0,1]) ball_bearing(BBF623);
        explode([0, 0, 5], true) {
          tz(ball_bearing_h(BBF623)/2) {
            washer(M3_washer);
          }
        }
      }
    }
  }
}

module double_idler_assembly() assembly("double_idler") {
  tz(-washer_h(M3_washer)/2) washer(M3_washer);
  mxy(idler_h/2-washer_h(M3_washer)/2) {
    explode([0, 0, 10], true) {
      mxy(washer_h(M3_washer)/2) {
        tz(-washer_h(M3_washer)/2) washer(M3_washer);
        explode([0, 0, 5], true) {
          tz(ball_bearing_h(BBF623)/2) {
            mirror([0,0,1]) ball_bearing(BBF623);
          }
        }
      }
      explode([0, 0, 10]) tz(idler_h/2-washer_h(M3_washer))
        washer(M3_washer);
    }
  }
}

module simple_nut_trap(type) {
 rx(-90) rz(90)
   nut_trap(0, nut_trap_radius(type)+0.4, supported = false,
            depth = nut_trap_depth(type)/2);
}
