beanz/m-draw-scad/(list of files, cad)

Other CAD files:
stls/left_front_corner.stl
stls/left_back_corner.stl
stls/left_y_carriage.stl
stls/left_motor_mount.stl
