beanz/m-draw-scad/printme.html

# M-draw-scad

Drawing bot with MGN rails

Main Assembly

## Table of Contents

1. Parts list
2. X Carriage Insert Assembly
3. X Carriage Assembly
4. Idler Assembly
5. Right Y Carriage Assembly
6. Left Y Carriage Assembly
7. X Rail Carriage Assembly
8. X Rail Left Assembly
9. X Rail Assembly
10. Double Idler Assembly
11. Right Motor Pulley Assembly
12. Right Motor Assembly
13. Left Motor Pulley Assembly
14. Left Motor Assembly
15. Right Inner Idler Assembly
16. Right Idler Assembly
17. Left Inner Idler Assembly
18. Left Idler Assembly
19. Front Frame Left Assembly
20. Front Frame Assembly
21. Back Frame Left Assembly
22. Back Frame Assembly
23. Y Rail Assembly
24. Back And Y Assembly
25. Frame Assembly
26. Frame Idler Assembly
27. Frame Motor Assembly
28. Frame X Rail Assembly
29. Frame X Carriage Assembly
30. Main Assembly

## Parts list

X Carriage Insert | X Carriage | 8 x Idler | Right Y Carriage | Left Y Carriage | X Rail Carriage | X Rail Left | X Rail | 2 x Double Idler | Right Motor Pulley | Right Motor | Left Motor Pulley | Left Motor | Right Inner Idler | Right Idler | Left Inner Idler | Left Idler | Front Frame Left | Front Frame | Back Frame Left | Back Frame | 2 x Y Rail | Back And Y | Frame | Frame Idler | Frame Motor | Frame X Rail | Frame X Carriage | Main | TOTALS
| | | | | | | | | | | | | | | | | | | | | | | | | | | | | | Vitamins
. | . | 16 | . | . | . | . | . | 8 | . | . | . | . | . | . | . | . | . | . | . | . | . | . | . | . | . | . | . | . | 24 | Ball bearing F623-2RS 3mm x 10mm x 4mm
. | . | . | . | . | . | . | . | . | . | . | . | . | . | . | . | . | . | . | . | . | . | . | . | . | . | . | . | 1 | 1 | Belt GT2 x 6mm x 1524mm
. | . | . | . | . | . | . | . | . | . | . | . | . | . | . | . | . | . | . | . | . | . | . | . | . | . | . | . | 1 | 1 | Belt GT2 x 6mm x 1524mm
. | . | . | . | . | 1 | . | . | . | . | . | . | . | . | . | . | . | . | . | . | . | . | . | . | . | . | . | . | . | 1 | Extrusion E2020 x 450mm
. | . | . | . | . | . | . | . | . | . | . | . | . | . | . | . | . | . | . | . | . | 2 | . | . | . | . | . | . | . | 2 | Extrusion E2040 x 354mm
. | . | . | . | . | . | . | . | . | . | . | . | . | . | . | . | . | 1 | . | 1 | . | . | . | . | . | . | . | . | . | 2 | Extrusion E2040 x 472mm
4 | . | . | . | . | . | . | . | . | . | . | . | . | . | . | . | . | . | . | . | . | . | . | . | . | . | . | . | . | 4 | Heatfit insert M3 x 4mm
. | . | . | . | . | 1 | . | . | . | . | . | . | . | . | . | . | . | . | . | . | . | . | . | . | . | . | . | . | . | 1 | Linear rail MGN12 x 400mm
. | . | . | . | . | . | . | . | . | . | . | . | . | . | . | . | . | . | . | . | . | 2 | . | . | . | . | . | . | . | 2 | Linear rail MGN15 x 300mm
. | . | . | . | . | 1 | . | . | . | . | . | . | . | . | . | . | . | . | . | . | . | . | . | . | . | . | . | . | . | 1 | Linear rail carriage MGN12H
. | . | . | . | . | . | . | . | . | . | . | . | . | . | . | . | . | . | . | . | . | 2 | . | . | . | . | . | . | . | 2 | Linear rail carriage MGN15H
. | . | . | . | . | 16 | 2 | 2 | . | . | . | . | . | . | . | . | . | . | . | . | . | 16 | . | . | . | . | . | . | . | 36 | Nut M3 sliding T
. | . | . | . | . | . | . | . | . | . | . | . | . | . | . | . | . | 4 | 4 | 7 | 7 | . | 2 | 2 | . | . | . | . | . | 26 | Nut M4 sliding T
. | . | . | 2 | 2 | . | . | . | . | . | . | . | . | . | . | . | . | . | . | . | . | . | . | . | . | . | . | . | . | 4 | Nut M4 x 3.2mm
. | . | . | . | . | . | . | . | . | . | . | . | . | . | 2 | . | 2 | . | . | . | . | . | . | . | . | . | . | . | . | 4 | Nut M4 x 3.2mm
. | . | . | . | . | . | . | . | . | 1 | . | 1 | . | . | . | . | . | . | . | . | . | . | . | . | . | . | . | . | . | 2 | Pulley GT2OB 20 teeth
. | 4 | . | . | . | 14 | . | . | . | . | . | . | . | . | . | . | . | . | . | . | . | 12 | . | . | . | . | 8 | 4 | . | 42 | Screw M3 cap x 10mm
. | . | . | . | . | . | . | . | . | . | 4 | . | 4 | . | . | . | . | . | . | . | . | . | . | . | . | . | . | . | . | 8 | Screw M3 cap x 35mm
. | . | . | 2 | 2 | . | . | . | . | . | . | . | . | . | . | . | . | . | . | . | . | . | . | . | . | . | . | . | . | 4 | Screw M3 cap x 45mm
. | . | . | . | . | 2 | . | . | . | . | . | . | . | . | . | . | . | . | . | . | . | 4 | . | . | . | . | . | . | . | 6 | Screw M3 cs cap x 12mm
. | . | . | . | . | . | . | . | . | 2 | . | 2 | . | . | . | . | . | . | . | . | . | . | . | . | . | . | . | . | . | 4 | Screw M3 grub x 6mm
. | . | . | . | . | . | . | . | . | . | . | . | . | 1 | . | 1 | . | . | . | . | . | . | . | . | . | . | . | . | . | 2 | Screw M3 grub x 20mm
. | . | . | . | . | . | 1 | 1 | . | . | . | . | . | . | . | . | . | 1 | 1 | 3 | 3 | . | . | . | 6 | 10 | . | . | . | 26 | Screw M4 flanged x 10mm
. | . | . | . | . | . | 1 | 1 | . | . | . | . | . | . | . | . | . | . | . | . | . | . | . | . | . | . | . | . | . | 2 | Screw M4 flanged x 16mm
. | . | . | . | . | . | . | . | . | . | . | . | . | 2 | . | 2 | . | . | . | . | . | . | . | . | . | . | . | . | . | 4 | Screw M4 flanged x 45mm
. | . | . | . | . | . | . | . | . | . | . | . | . | . | . | . | . | . | . | . | . | . | 4 | 2 | . | . | . | . | . | 6 | Screw M5 flanged x 10mm
. | . | . | . | . | . | . | . | . | . | . | . | . | . | . | . | . | 1 | 1 | . | . | . | . | 2 | . | . | . | . | . | 4 | Screw M5 low profile x 10mm
. | . | . | . | . | . | . | . | . | 1 | . | 1 | . | . | . | . | . | . | . | . | . | . | . | . | . | . | . | . | . | 2 | Stepper motor NEMA17 x 47mm (5x24 shaft)
. | . | 24 | 2 | 2 | . | . | . | 14 | . | 4 | . | 4 | . | . | . | . | . | . | . | . | . | . | . | . | . | 8 | 4 | . | 62 | Washer M3 x 7mm x 0.5mm
. | . | . | 2 | 2 | . | . | . | . | . | . | . | . | . | . | . | . | . | . | . | . | . | . | . | . | . | . | . | . | 4 | Washer M4 x 9mm x 0.8mm
4 | 4 | 40 | 8 | 8 | 35 | 4 | 4 | 22 | 4 | 8 | 4 | 8 | 3 | 2 | 3 | 2 | 7 | 6 | 11 | 10 | 38 | 6 | 6 | 6 | 10 | 16 | 8 | 2 | 289 | Total vitamins count
| | | | | | | | | | | | | | | | | | | | | | | | | | | | | | 3D printed parts
. | . | . | . | . | . | . | . | . | . | . | . | . | . | . | . | . | . | . | 1 | . | . | . | . | . | . | . | . | . | 1 | left_back_corner.stl
. | . | . | . | . | . | . | . | . | . | . | . | . | . | . | . | . | 1 | . | . | . | . | . | . | . | . | . | . | . | 1 | left_front_corner.stl
. | . | . | . | . | . | . | . | . | . | . | . | . | . | . | 1 | . | . | . | . | . | . | . | . | . | . | . | . | . | 1 | left_front_idler.stl
. | . | . | . | . | . | . | . | . | . | . | . | . | . | . | . | 1 | . | . | . | . | . | . | . | . | . | . | . | . | 1 | left_idler_mount.stl
. | . | . | . | . | . | . | . | . | . | . | . | 1 | . | . | . | . | . | . | . | . | . | . | . | . | . | . | . | . | 1 | left_lower_motor_mount.stl
. | . | . | . | 1 | . | . | . | . | . | . | . | . | . | . | . | . | . | . | . | . | . | . | . | . | . | . | . | . | 1 | left_lower_y_carriage.stl
. | . | . | . | . | . | . | . | . | . | . | . | 1 | . | . | . | . | . | . | . | . | . | . | . | . | . | . | . | . | 1 | left_motor_mount.stl
. | . | . | . | 1 | . | . | . | . | . | . | . | . | . | . | . | . | . | . | . | . | . | . | . | . | . | . | . | . | 1 | left_y_carriage.stl
. | . | . | . | . | . | . | . | . | . | . | . | . | . | . | . | . | . | . | . | 1 | . | . | . | . | . | . | . | . | 1 | right_back_corner.stl
. | . | . | . | . | . | . | . | . | . | . | . | . | . | . | . | . | . | 1 | . | . | . | . | . | . | . | . | . | . | 1 | right_front_corner.stl
. | . | . | . | . | . | . | . | . | . | . | . | . | 1 | . | . | . | . | . | . | . | . | . | . | . | . | . | . | . | 1 | right_front_idler.stl
. | . | . | . | . | . | . | . | . | . | . | . | . | . | 1 | . | . | . | . | . | . | . | . | . | . | . | . | . | . | 1 | right_idler_mount.stl
. | . | . | . | . | . | . | . | . | . | 1 | . | . | . | . | . | . | . | . | . | . | . | . | . | . | . | . | . | . | 1 | right_lower_motor_mount.stl
. | . | . | 1 | . | . | . | . | . | . | . | . | . | . | . | . | . | . | . | . | . | . | . | . | . | . | . | . | . | 1 | right_lower_y_carriage.stl
. | . | . | . | . | . | . | . | . | . | 1 | . | . | . | . | . | . | . | . | . | . | . | . | . | . | . | . | . | . | 1 | right_motor_mount.stl
. | . | . | 1 | . | . | . | . | . | . | . | . | . | . | . | . | . | . | . | . | . | . | . | . | . | . | . | . | . | 1 | right_y_carriage.stl
. | 2 | . | . | . | . | . | . | . | . | . | . | . | . | . | . | . | . | . | . | . | . | . | . | . | . | . | . | . | 2 | x_belt_clamp.stl
1 | . | . | . | . | . | . | . | . | . | . | . | . | . | . | . | . | . | . | . | . | . | . | . | . | . | . | . | . | 1 | x_carriage.stl
1 | 2 | . | 2 | 2 | . | . | . | . | . | 2 | . | 2 | 1 | 1 | 1 | 1 | 1 | 1 | 1 | 1 | . | . | . | . | . | . | . | . | 19 | Total 3D printed parts count

## X Carriage Insert Assembly

### Vitamins

Qty | Description
4 | Heatfit insert M3 x 4mm

### 3D Printed parts

1 x x_carriage.stl

x_carriage.stl

### Assembly instructions

x_carriage_insert_assembly

x_carriage_insert_assembled

## X Carriage Assembly

### Vitamins

Qty | Description
4 | Screw M3 cap x 10mm

### 3D Printed parts

2 x x_belt_clamp.stl

x_belt_clamp.stl

### Sub-assemblies

1 x x_carriage_insert_assembly

x_carriage_insert_assembled

### Assembly instructions

x_carriage_assembly

x_carriage_assembled

## 8 x Idler Assembly

### Vitamins

Qty | Description
16 | Ball bearing F623-2RS 3mm x 10mm x 4mm
24 | Washer M3 x 7mm x 0.5mm

### Assembly instructions

idler_assembly

idler_assembled

## Right Y Carriage Assembly

### Vitamins

Qty | Description
2 | Nut M4 x 3.2mm
2 | Screw M3 cap x 45mm
2 | Washer M3 x 7mm x 0.5mm
2 | Washer M4 x 9mm x 0.8mm

### 3D Printed parts

1 x right_lower_y_carriage.stl | 1 x right_y_carriage.stl
right_lower_y_carriage.stl | right_y_carriage.stl

### Sub-assemblies

2 x idler_assembly

idler_assembled

### Assembly instructions

right_y_carriage_assembly

right_y_carriage_assembled

## Left Y Carriage Assembly

### Vitamins

Qty | Description
2 | Nut M4 x 3.2mm
2 | Screw M3 cap x 45mm
2 | Washer M3 x 7mm x 0.5mm
2 | Washer M4 x 9mm x 0.8mm

### 3D Printed parts

1 x left_lower_y_carriage.stl | 1 x left_y_carriage.stl
left_lower_y_carriage.stl | left_y_carriage.stl

### Sub-assemblies

2 x idler_assembly

idler_assembled

### Assembly instructions

left_y_carriage_assembly

left_y_carriage_assembled

## X Rail Carriage Assembly

### Vitamins

Qty | Description
1 | Extrusion E2020 x 450mm
1 | Linear rail MGN12 x 400mm
1 | Linear rail carriage MGN12H
16 | Nut M3 sliding T
14 | Screw M3 cap x 10mm
2 | Screw M3 cs cap x 12mm

### Assembly instructions

x_rail_carriage_assembly

x_rail_carriage_assembled

## X Rail Left Assembly

### Vitamins

Qty | Description
2 | Nut M3 sliding T
1 | Screw M4 flanged x 10mm
1 | Screw M4 flanged x 16mm

### Sub-assemblies

1 x left_y_carriage_assembly | 1 x x_rail_carriage_assembly
left_y_carriage_assembled | x_rail_carriage_assembled

### Assembly instructions

x_rail_left_assembly

x_rail_left_assembled

## X Rail Assembly

### Vitamins

Qty | Description
2 | Nut M3 sliding T
1 | Screw M4 flanged x 10mm
1 | Screw M4 flanged x 16mm

### Sub-assemblies

1 x right_y_carriage_assembly | 1 x x_rail_left_assembly
right_y_carriage_assembled | x_rail_left_assembled

### Assembly instructions

x_rail_assembly

x_rail_assembled

## 2 x Double Idler Assembly

### Vitamins

Qty | Description
8 | Ball bearing F623-2RS 3mm x 10mm x 4mm
14 | Washer M3 x 7mm x 0.5mm

### Assembly instructions

double_idler_assembly

double_idler_assembled

## Right Motor Pulley Assembly

### Vitamins

Qty | Description
1 | Pulley GT2OB 20 teeth
2 | Screw M3 grub x 6mm
1 | Stepper motor NEMA17 x 47mm (5x24 shaft)

### Assembly instructions

right_motor_pulley_assembly

right_motor_pulley_assembled

## Right Motor Assembly

### Vitamins

Qty | Description
4 | Screw M3 cap x 35mm
4 | Washer M3 x 7mm x 0.5mm

### 3D Printed parts

1 x right_lower_motor_mount.stl | 1 x right_motor_mount.stl
right_lower_motor_mount.stl | right_motor_mount.stl

### Sub-assemblies

1 x double_idler_assembly | 1 x idler_assembly | 1 x right_motor_pulley_assembly
double_idler_assembled | idler_assembled | right_motor_pulley_assembled

### Assembly instructions

right_motor_assembly

right_motor_assembled

## Left Motor Pulley Assembly

### Vitamins

Qty | Description
1 | Pulley GT2OB 20 teeth
2 | Screw M3 grub x 6mm
1 | Stepper motor NEMA17 x 47mm (5x24 shaft)

### Assembly instructions

left_motor_pulley_assembly

left_motor_pulley_assembled

## Left Motor Assembly

### Vitamins

Qty | Description
4 | Screw M3 cap x 35mm
4 | Washer M3 x 7mm x 0.5mm

### 3D Printed parts

1 x left_lower_motor_mount.stl | 1 x left_motor_mount.stl
left_lower_motor_mount.stl | left_motor_mount.stl

### Sub-assemblies

1 x double_idler_assembly | 1 x idler_assembly | 1 x left_motor_pulley_assembly
double_idler_assembled | idler_assembled | left_motor_pulley_assembled

### Assembly instructions

left_motor_assembly

left_motor_assembled

## Right Inner Idler Assembly

### Vitamins

Qty | Description
1 | Screw M3 grub x 20mm
2 | Screw M4 flanged x 45mm

### 3D Printed parts

1 x right_front_idler.stl

right_front_idler.stl

### Sub-assemblies

1 x idler_assembly

idler_assembled

### Assembly instructions

right_inner_idler_assembly

right_inner_idler_assembled

## Right Idler Assembly

### Vitamins

Qty | Description
2 | Nut M4 x 3.2mm

### 3D Printed parts

1 x right_idler_mount.stl

right_idler_mount.stl

### Sub-assemblies

1 x right_inner_idler_assembly

right_inner_idler_assembled

### Assembly instructions

right_idler_assembly

right_idler_assembled

## Left Inner Idler Assembly

### Vitamins

Qty | Description
1 | Screw M3 grub x 20mm
2 | Screw M4 flanged x 45mm

### 3D Printed parts

1 x left_front_idler.stl

left_front_idler.stl

### Sub-assemblies

1 x idler_assembly

idler_assembled

### Assembly instructions

left_inner_idler_assembly

left_inner_idler_assembled

## Left Idler Assembly

### Vitamins

Qty | Description
2 | Nut M4 x 3.2mm

### 3D Printed parts

1 x left_idler_mount.stl

left_idler_mount.stl

### Sub-assemblies

1 x left_inner_idler_assembly

left_inner_idler_assembled

### Assembly instructions

left_idler_assembly

left_idler_assembled

## Front Frame Left Assembly

### Vitamins

Qty | Description
1 | Extrusion E2040 x 472mm
4 | Nut M4 sliding T
1 | Screw M4 flanged x 10mm
1 | Screw M5 low profile x 10mm

### 3D Printed parts

1 x left_front_corner.stl

left_front_corner.stl

### Assembly instructions

front_frame_left_assembly

front_frame_left_assembled

## Front Frame Assembly

### Vitamins

Qty | Description
4 | Nut M4 sliding T
1 | Screw M4 flanged x 10mm
1 | Screw M5 low profile x 10mm

### 3D Printed parts

1 x right_front_corner.stl

right_front_corner.stl

### Sub-assemblies

1 x front_frame_left_assembly

front_frame_left_assembled

### Assembly instructions

front_frame_assembly

front_frame_assembled

## Back Frame Left Assembly

### Vitamins

Qty | Description
1 | Extrusion E2040 x 472mm
7 | Nut M4 sliding T
3 | Screw M4 flanged x 10mm

### 3D Printed parts

1 x left_back_corner.stl

left_back_corner.stl

### Assembly instructions

back_frame_left_assembly

back_frame_left_assembled

## Back Frame Assembly

### Vitamins

Qty | Description
7 | Nut M4 sliding T
3 | Screw M4 flanged x 10mm

### 3D Printed parts

1 x right_back_corner.stl

right_back_corner.stl

### Sub-assemblies

1 x back_frame_left_assembly

back_frame_left_assembled

### Assembly instructions

back_frame_assembly

back_frame_assembled

## 2 x Y Rail Assembly

### Vitamins

Qty | Description
2 | Extrusion E2040 x 354mm
2 | Linear rail MGN15 x 300mm
2 | Linear rail carriage MGN15H
16 | Nut M3 sliding T
12 | Screw M3 cap x 10mm
4 | Screw M3 cs cap x 12mm

### Assembly instructions

y_rail_assembly

y_rail_assembled

## Back And Y Assembly

### Vitamins

Qty | Description
2 | Nut M4 sliding T
4 | Screw M5 flanged x 10mm

### Sub-assemblies

1 x back_frame_assembly | 2 x y_rail_assembly
back_frame_assembled | y_rail_assembled

### Assembly instructions

back_and_y_assembly

Repeat for both back corners

back_and_y_assembled

## Frame Assembly

### Vitamins

Qty | Description
2 | Nut M4 sliding T
2 | Screw M5 flanged x 10mm
2 | Screw M5 low profile x 10mm

### Sub-assemblies

1 x back_and_y_assembly | 1 x front_frame_assembly
back_and_y_assembled | front_frame_assembled

### Assembly instructions

frame_assembly

frame_assembled

## Frame Idler Assembly

### Vitamins

Qty | Description
6 | Screw M4 flanged x 10mm

### Sub-assemblies

1 x frame_assembly | 1 x left_idler_assembly | 1 x right_idler_assembly
frame_assembled | left_idler_assembled | right_idler_assembled

### Assembly instructions

frame_idler_assembly

Repeat at both front idler mounts

frame_idler_assembled

## Frame Motor Assembly

### Vitamins

Qty | Description
10 | Screw M4 flanged x 10mm

### Sub-assemblies

1 x frame_idler_assembly | 1 x left_motor_assembly | 1 x right_motor_assembly
frame_idler_assembled | left_motor_assembled | right_motor_assembled

### Assembly instructions

frame_motor_assembly

Repeat at both motor mounts

frame_motor_assembled

## Frame X Rail Assembly

### Vitamins

Qty | Description
8 | Screw M3 cap x 10mm
8 | Washer M3 x 7mm x 0.5mm

### Sub-assemblies

1 x frame_motor_assembly | 1 x x_rail_assembly
frame_motor_assembled | x_rail_assembled

### Assembly instructions

frame_x_rail_assembly

Repeat at both y carriages

frame_x_rail_assembled

## Frame X Carriage Assembly

### Vitamins

Qty | Description
4 | Screw M3 cap x 10mm
4 | Washer M3 x 7mm x 0.5mm

### Sub-assemblies

1 x frame_x_rail_assembly | 1 x x_carriage_assembly
frame_x_rail_assembled | x_carriage_assembled

### Assembly instructions

frame_x_carriage_assembly

frame_x_carriage_assembled

## Main Assembly

### Vitamins

Qty | Description
1 | Belt GT2 x 6mm x 1524mm
1 | Belt GT2 x 6mm x 1524mm

### Sub-assemblies

1 x frame_x_carriage_assembly

frame_x_carriage_assembled

### Assembly instructions

main_assembly

Put the belts in with front idlers as loose then tighten the clamps. Finally, tighten the idlers evenly.

main_assembled
