beanz/m-draw-scad/assemblies/back_and_y_assembled.png

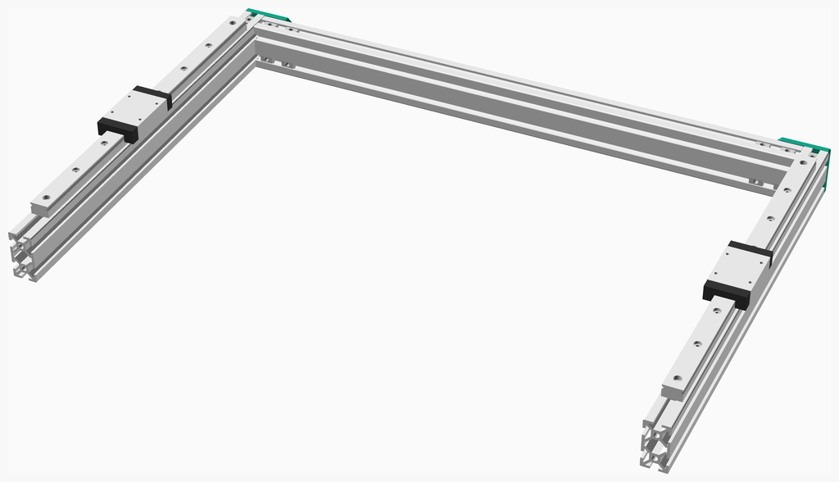
assemblies/back_and_y_assembled.png
