beanz/m-draw-scad/assemblies/back_and_y_assembly.png

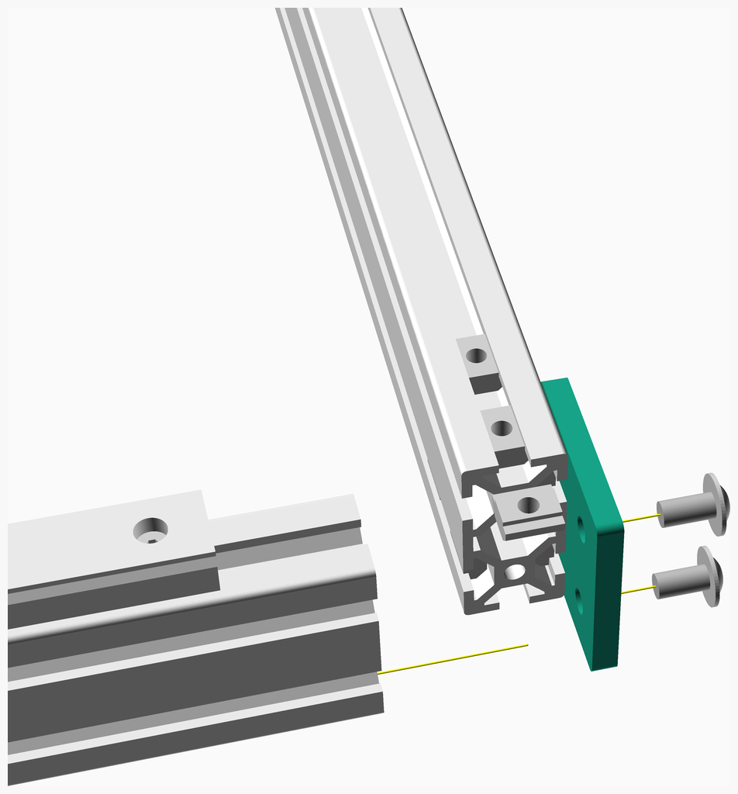
assemblies/back_and_y_assembly.png
