beanz/m-draw-scad/assemblies/back_frame_assembled.png

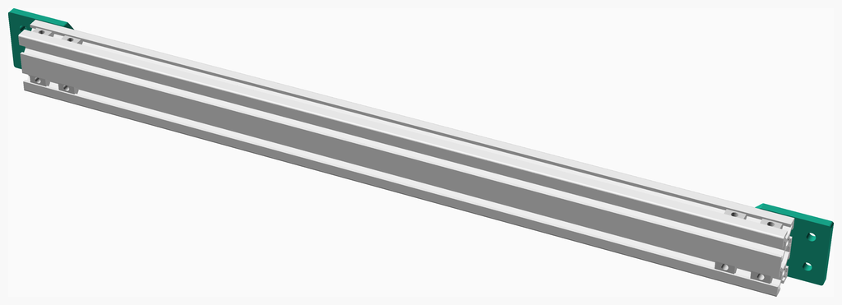
assemblies/back_frame_assembled.png
