beanz/m-draw-scad/assemblies/back_frame_assembly.png

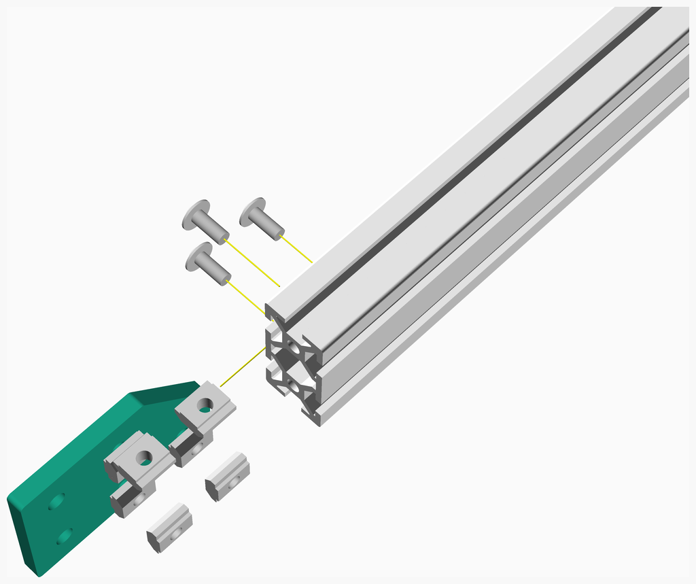
assemblies/back_frame_assembly.png
