beanz/m-draw-scad/assemblies/back_frame_left_assembly.png

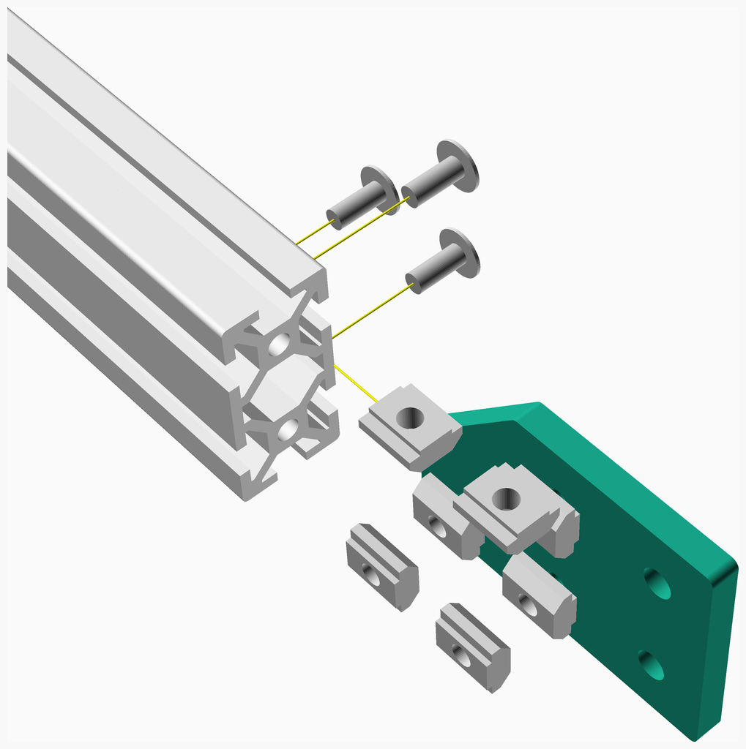
assemblies/back_frame_left_assembly.png
