beanz/m-draw-scad/assemblies/double_idler_assembled.png

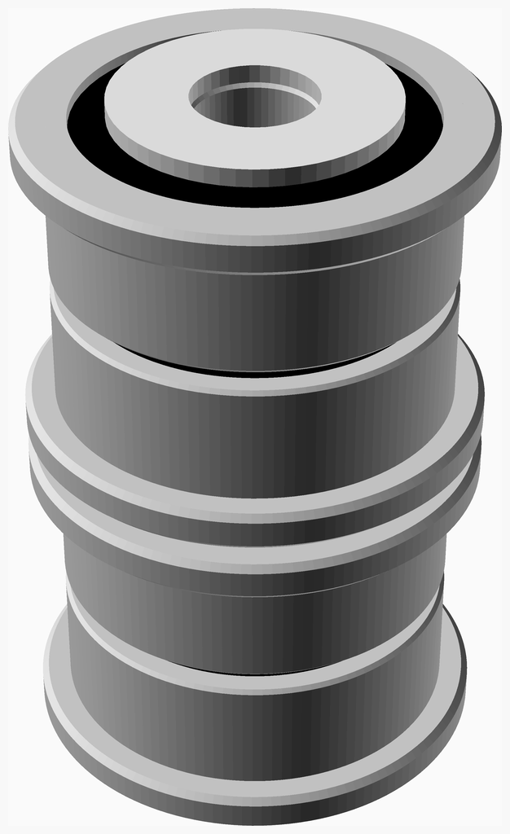
assemblies/double_idler_assembled.png
