beanz/m-draw-scad/assemblies/double_idler_assembly.png

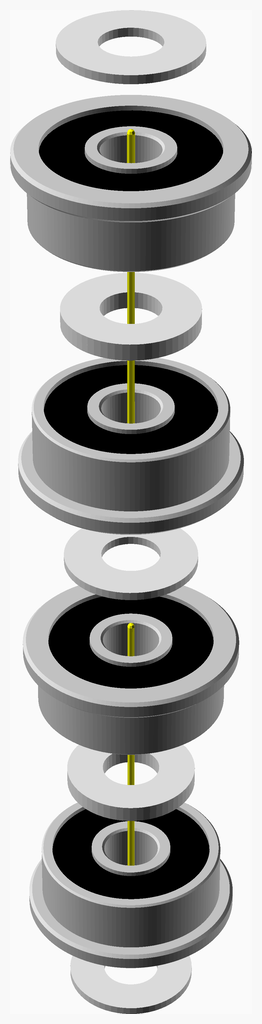
assemblies/double_idler_assembly.png
