beanz/m-draw-scad/assemblies/frame_assembled.png

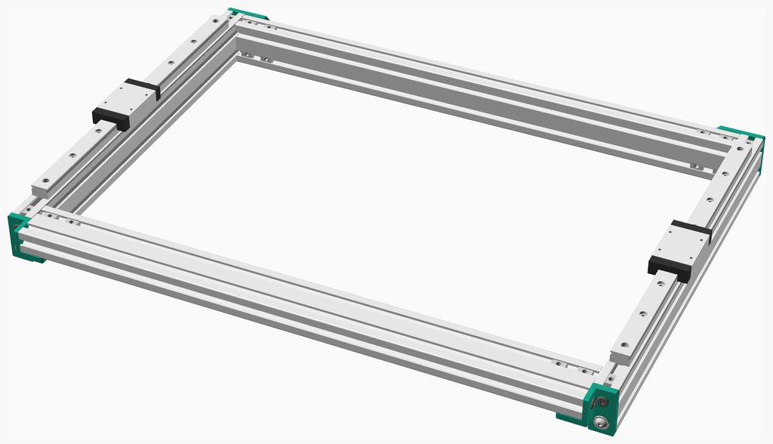
assemblies/frame_assembled.png
