beanz/m-draw-scad/assemblies/frame_assembly.png

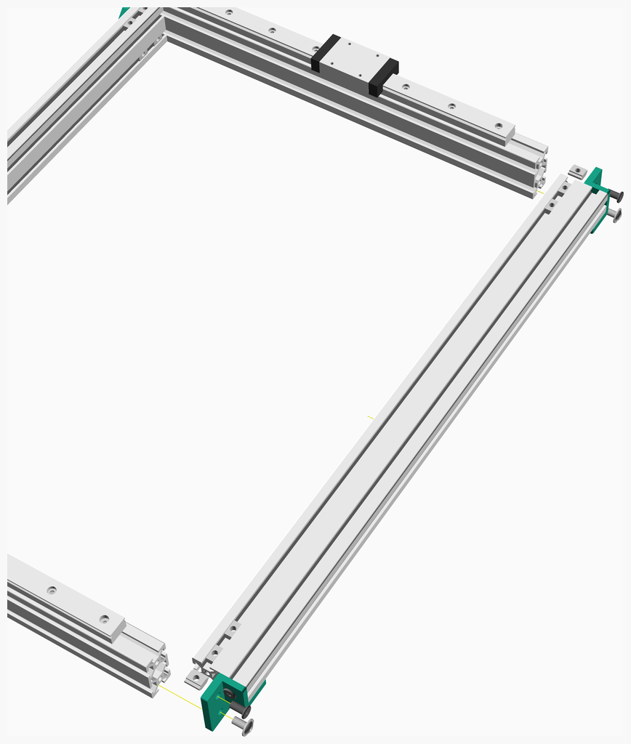
assemblies/frame_assembly.png
