beanz/m-draw-scad/assemblies/frame_idler_assembly.png

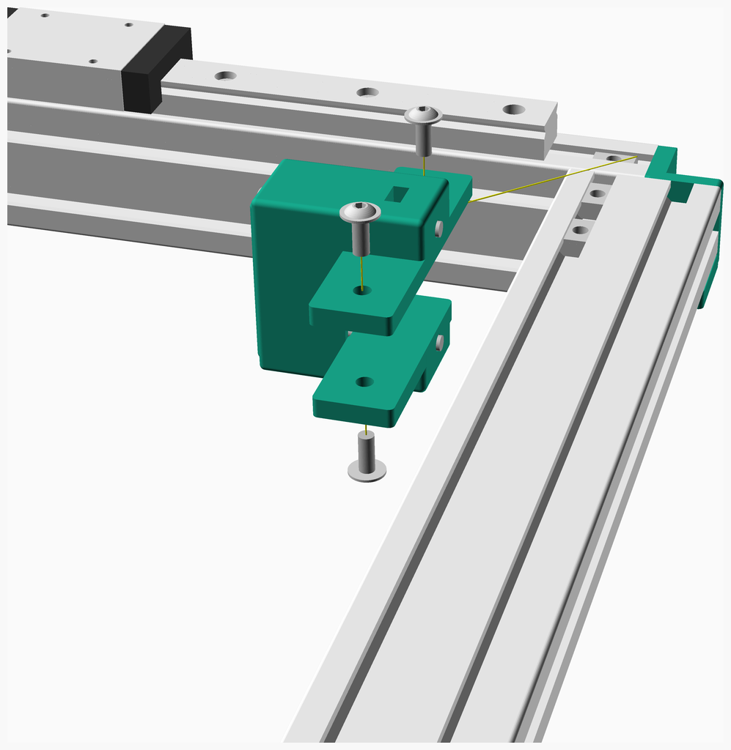
assemblies/frame_idler_assembly.png
