beanz/m-draw-scad/assemblies/frame_motor_assembled.png

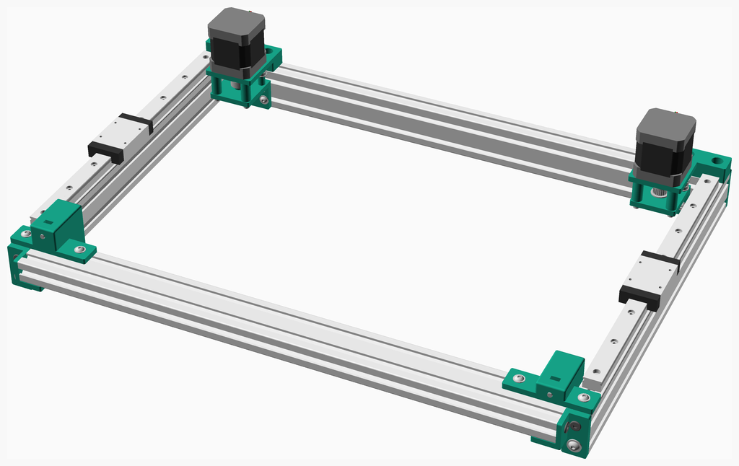
assemblies/frame_motor_assembled.png
