beanz/m-draw-scad/assemblies/frame_motor_assembly.png

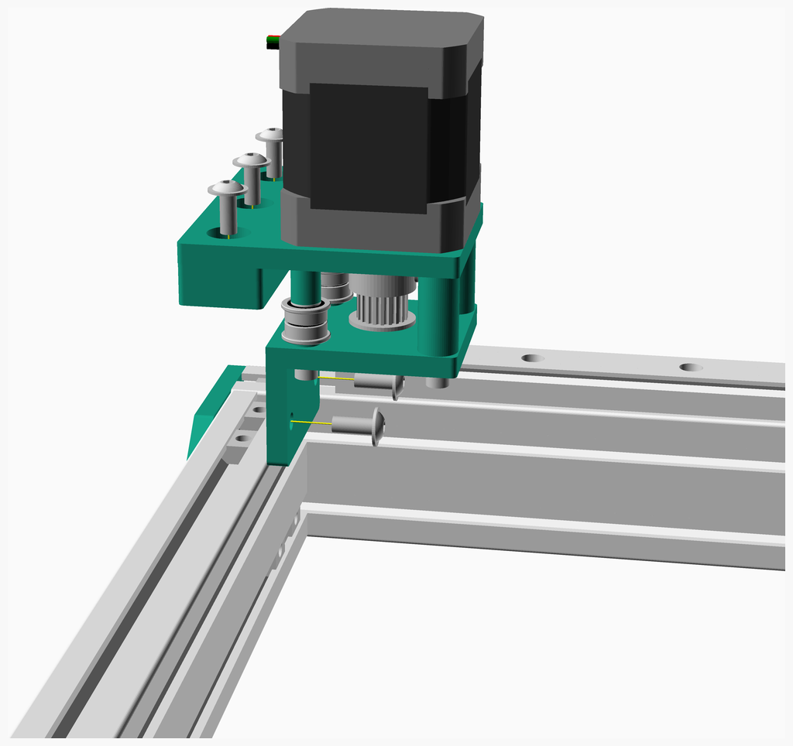
assemblies/frame_motor_assembly.png
