beanz/m-draw-scad/assemblies/frame_x_carriage_assembly.png

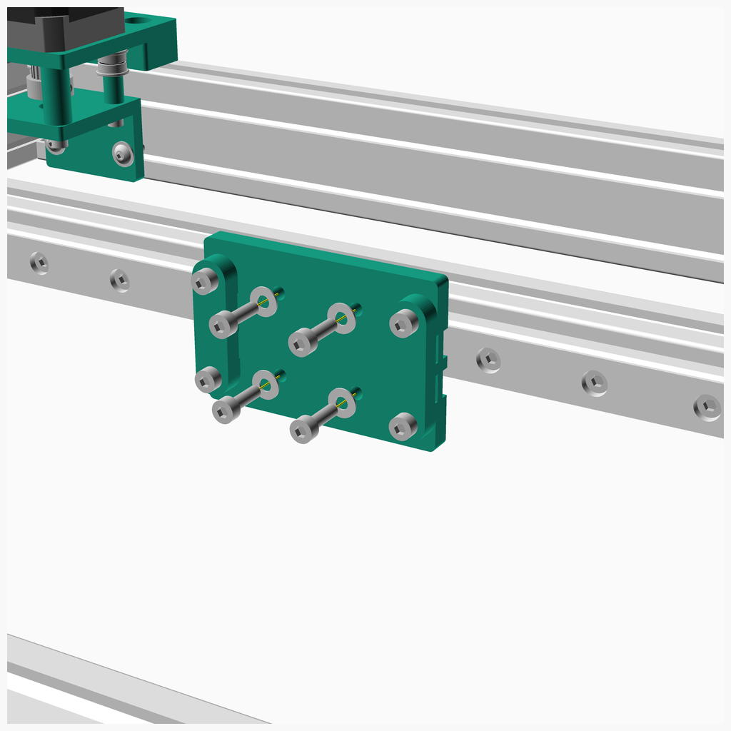
assemblies/frame_x_carriage_assembly.png
