beanz/m-draw-scad/assemblies/frame_x_rail_assembly.png

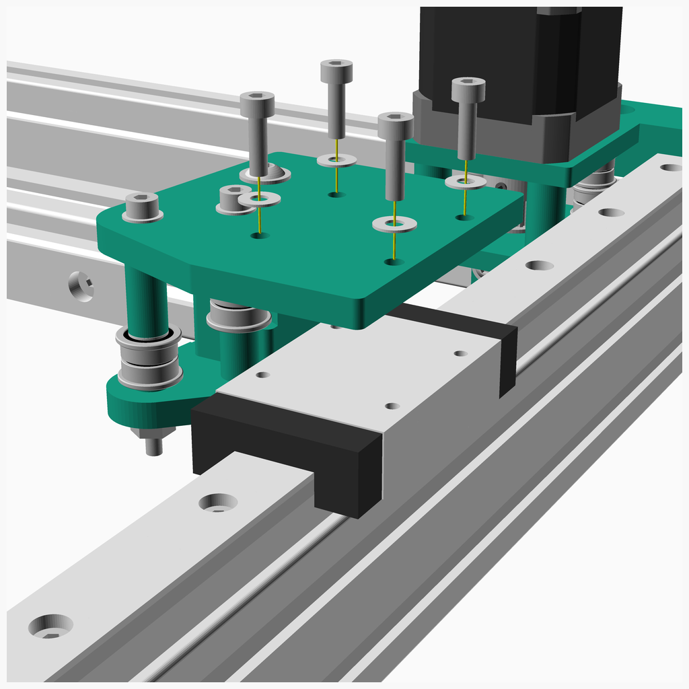
assemblies/frame_x_rail_assembly.png
