beanz/m-draw-scad/assemblies/front_frame_assembled.png

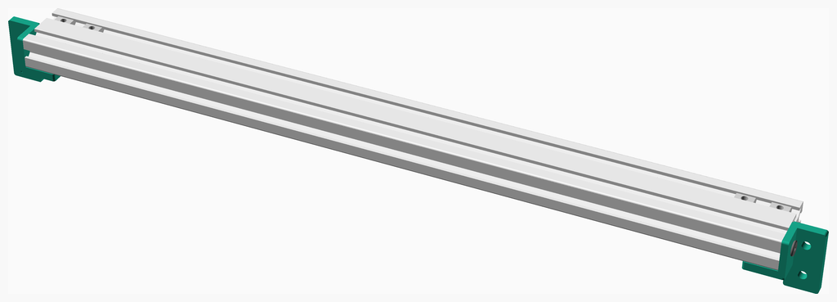
assemblies/front_frame_assembled.png
