beanz/m-draw-scad/assemblies/front_frame_assembly.png

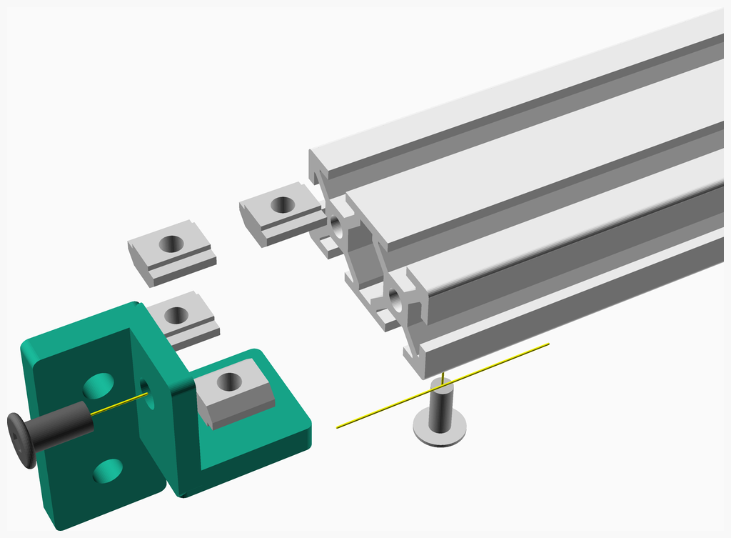
assemblies/front_frame_assembly.png
