beanz/m-draw-scad/assemblies/front_frame_left_assembly.png

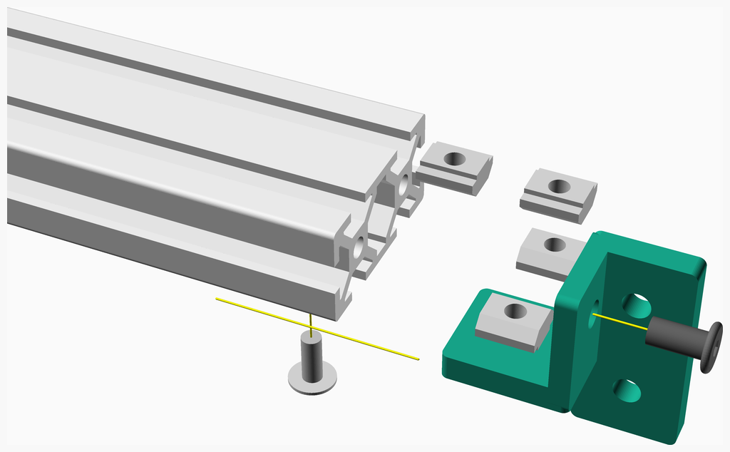
assemblies/front_frame_left_assembly.png
