beanz/m-draw-scad/assemblies/idler_assembled.png

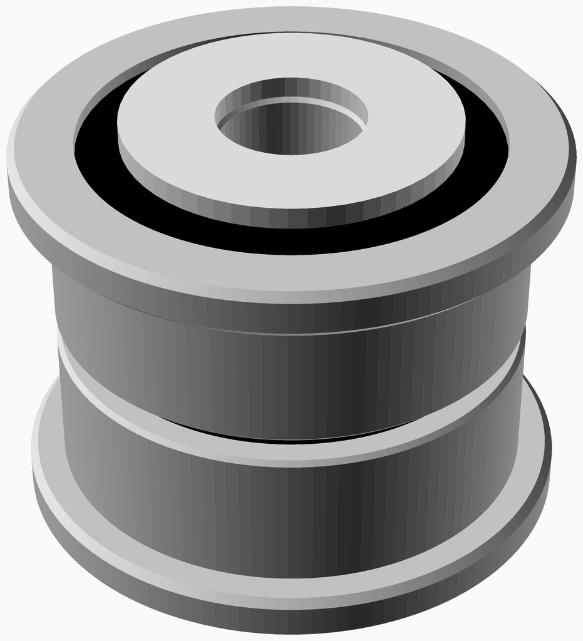
assemblies/idler_assembled.png
