beanz/m-draw-scad/assemblies/idler_assembly.png

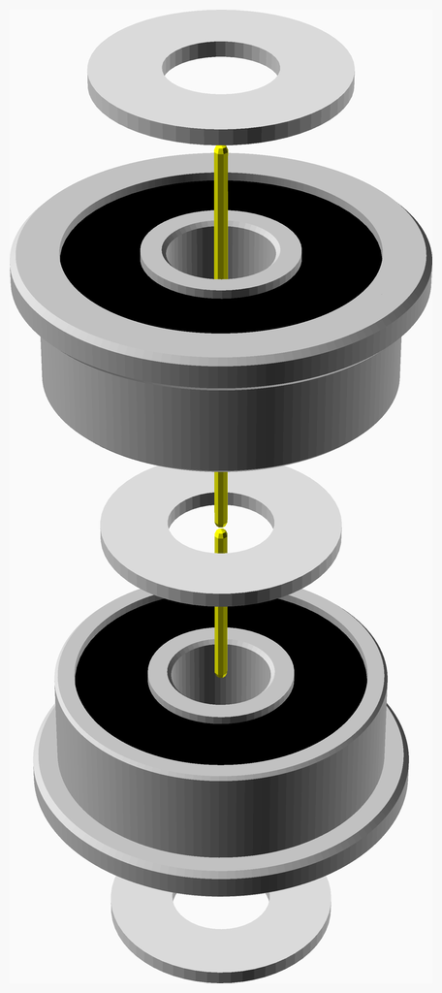
assemblies/idler_assembly.png
