beanz/m-draw-scad/assemblies/left_idler_assembled.png

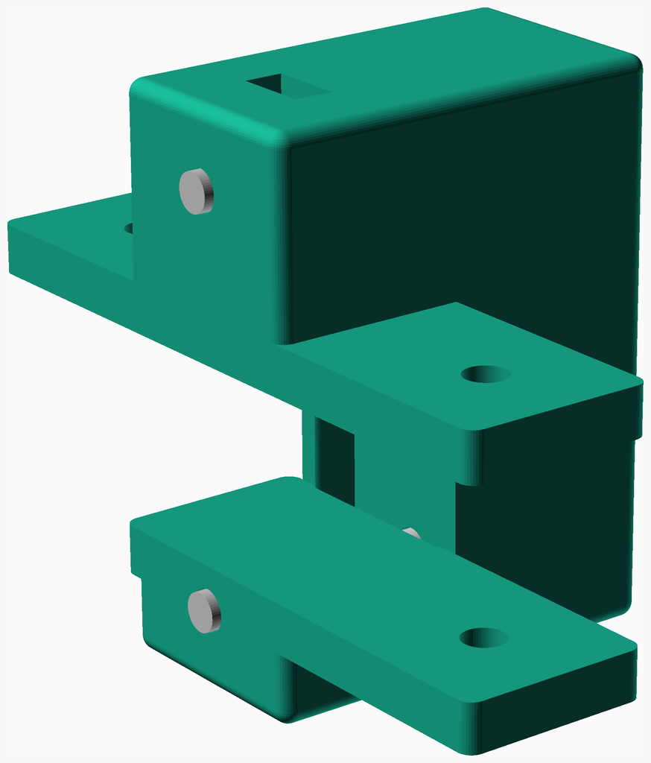
assemblies/left_idler_assembled.png
