beanz/m-draw-scad/assemblies/left_idler_assembly.png

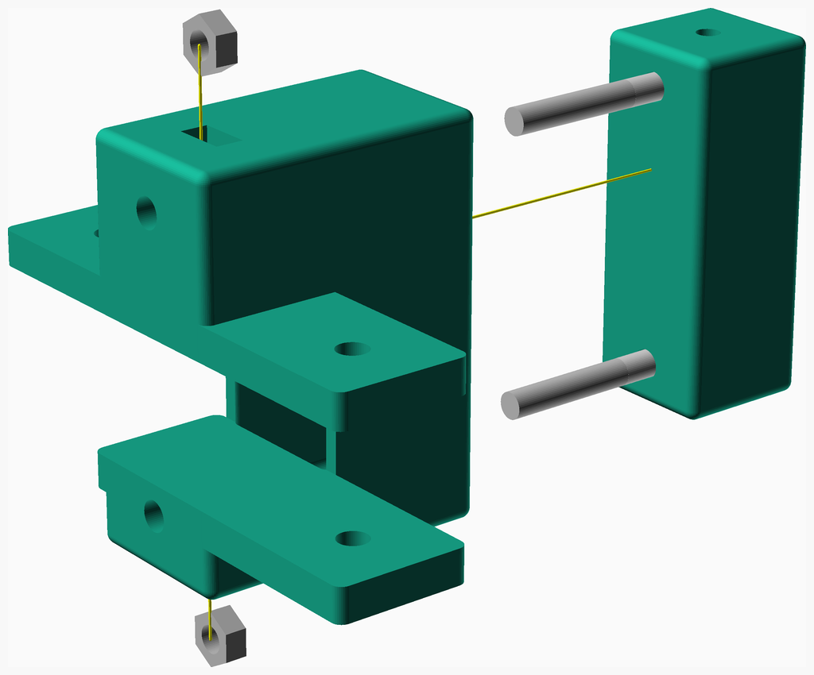
assemblies/left_idler_assembly.png
