beanz/m-draw-scad/assemblies/left_inner_idler_assembled.png

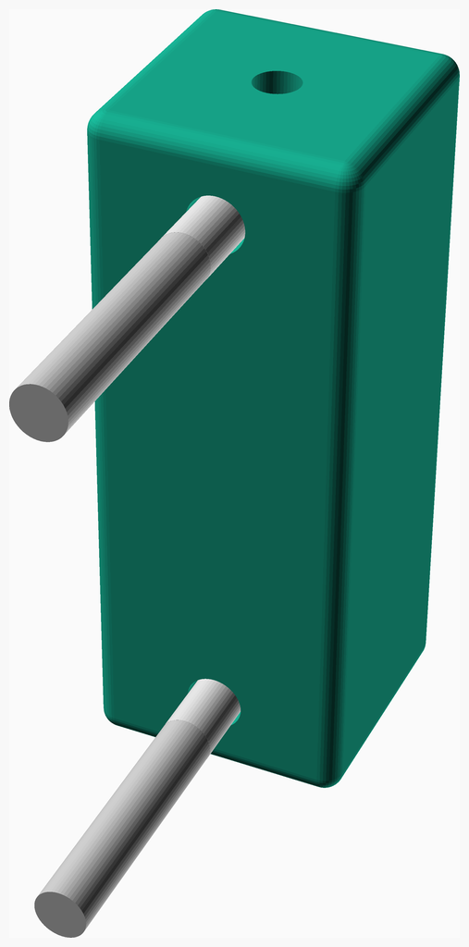
assemblies/left_inner_idler_assembled.png
