beanz/m-draw-scad/assemblies/left_inner_idler_assembly.png

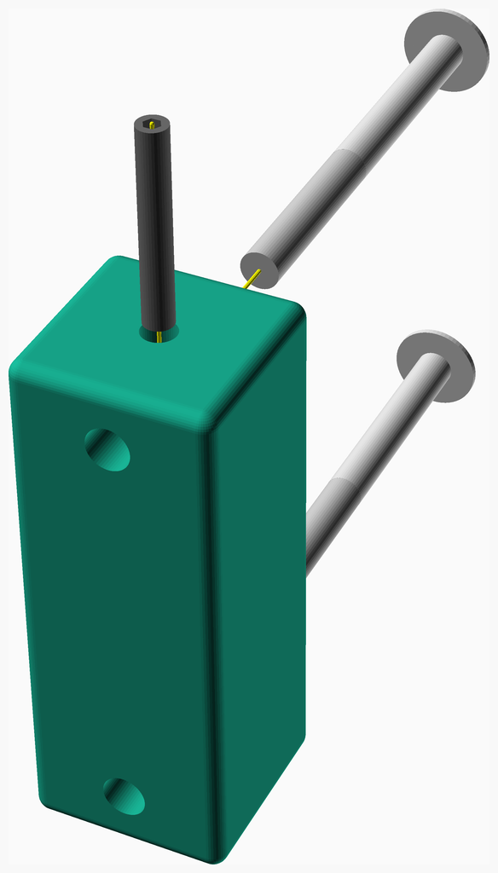
assemblies/left_inner_idler_assembly.png
