beanz/m-draw-scad/assemblies/left_motor_assembly.png

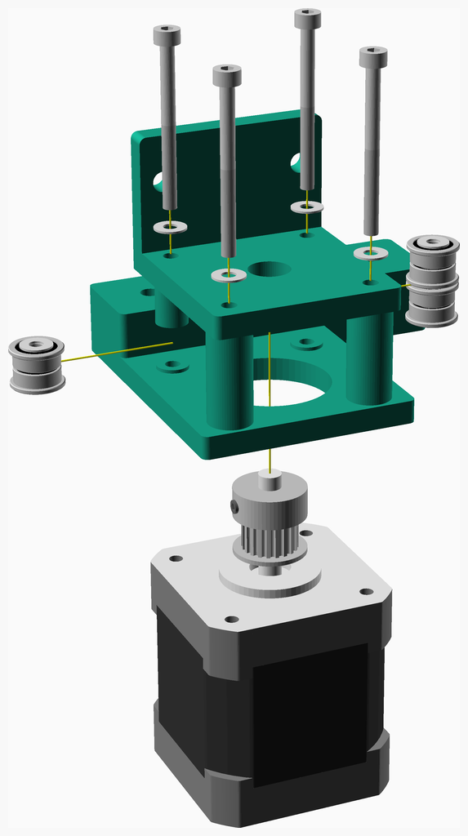
assemblies/left_motor_assembly.png
