beanz/m-draw-scad/assemblies/left_motor_pulley_assembled.png

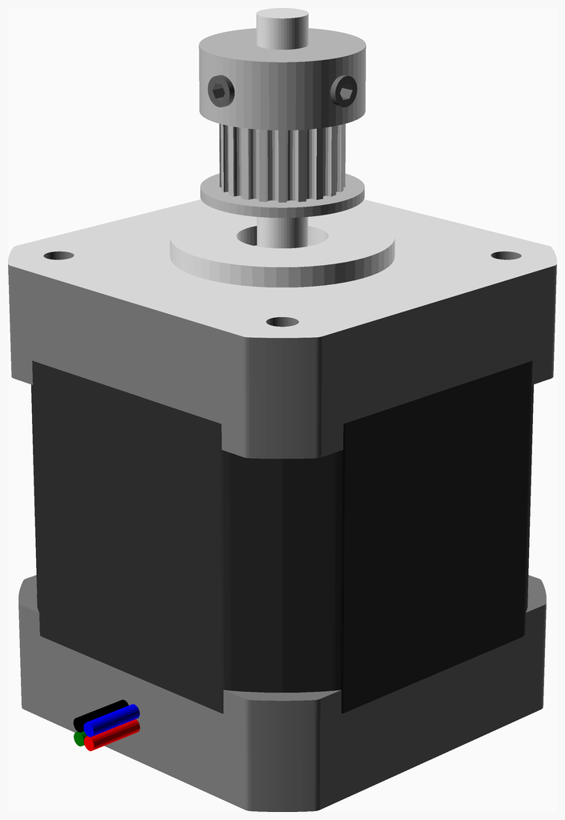
assemblies/left_motor_pulley_assembled.png
