beanz/m-draw-scad/assemblies/left_motor_pulley_assembly.png

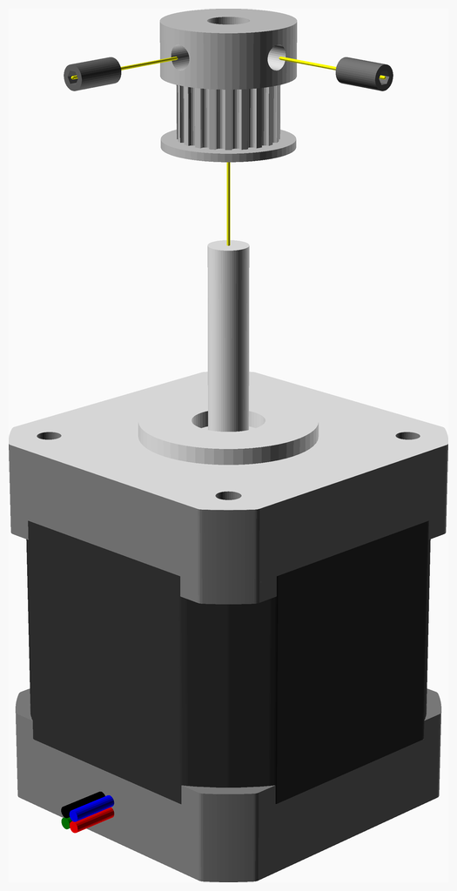
assemblies/left_motor_pulley_assembly.png
