beanz/m-draw-scad/assemblies/left_y_carriage_assembled.png

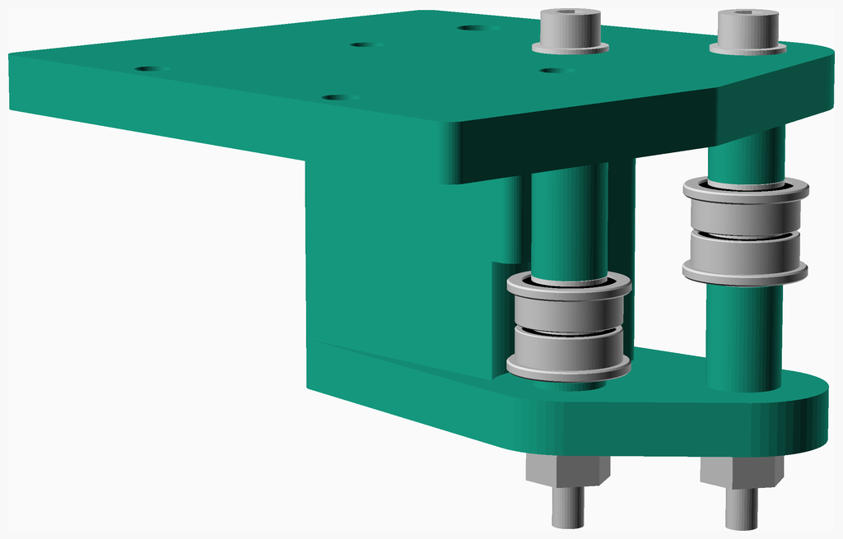
assemblies/left_y_carriage_assembled.png
