beanz/m-draw-scad/assemblies/right_idler_assembled.png

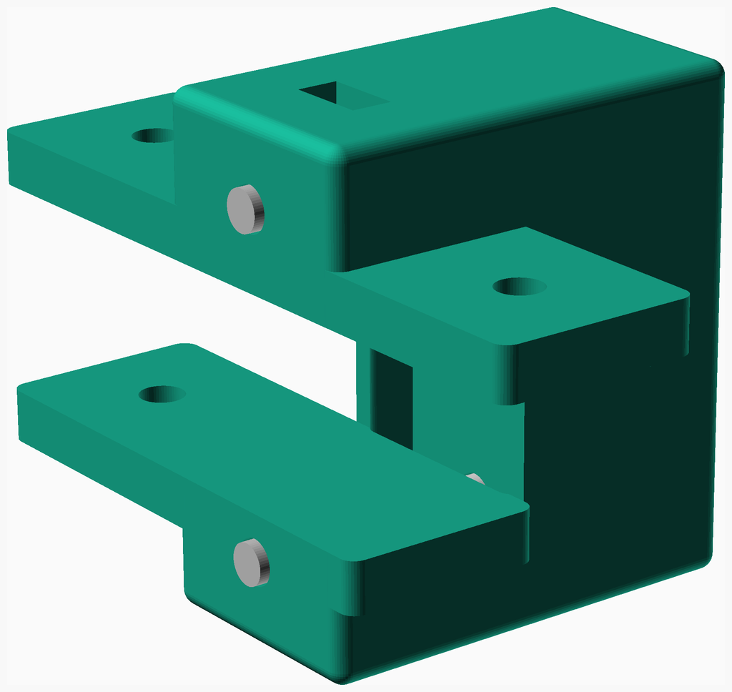
assemblies/right_idler_assembled.png
