beanz/m-draw-scad/assemblies/right_idler_assembly.png

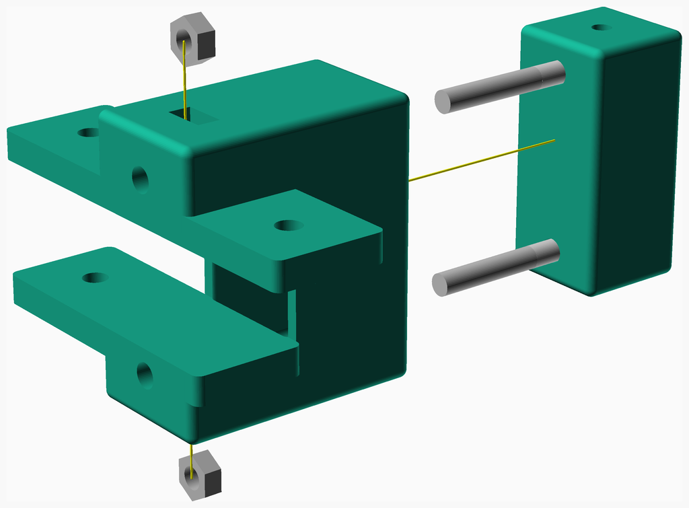
assemblies/right_idler_assembly.png
