beanz/m-draw-scad/assemblies/right_inner_idler_assembly.png

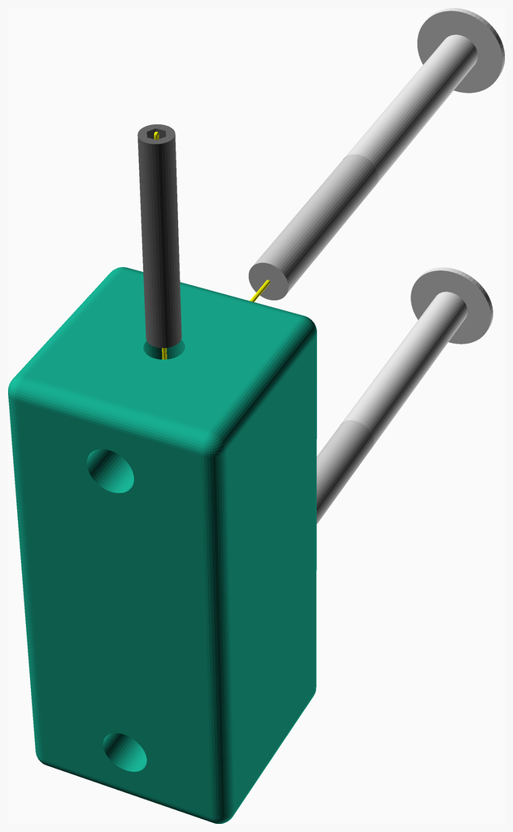
assemblies/right_inner_idler_assembly.png
