beanz/m-draw-scad/assemblies/right_motor_assembly.png

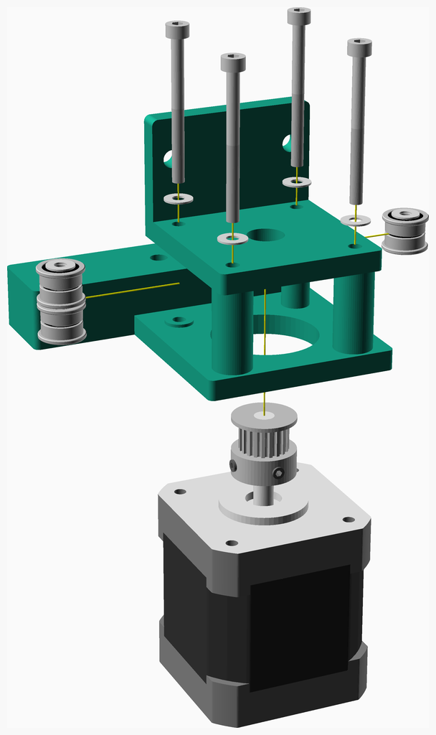
assemblies/right_motor_assembly.png
