beanz/m-draw-scad/assemblies/right_motor_pulley_assembly.png

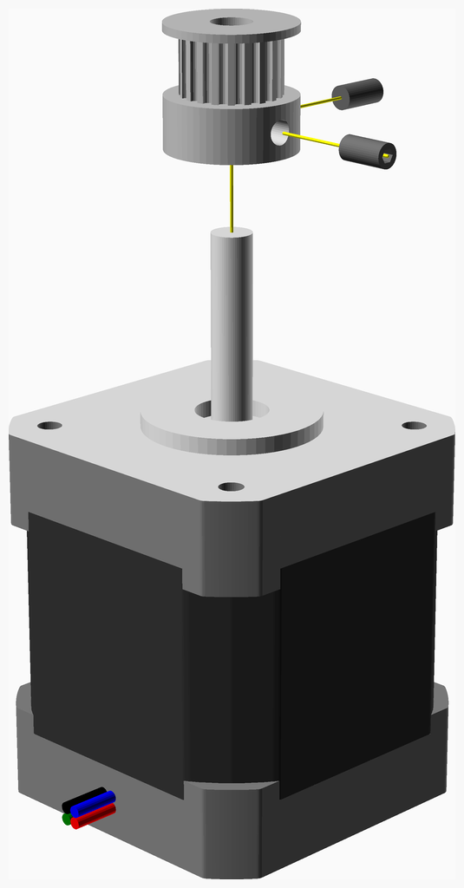
assemblies/right_motor_pulley_assembly.png
