beanz/m-draw-scad/assemblies/right_y_carriage_assembly.png

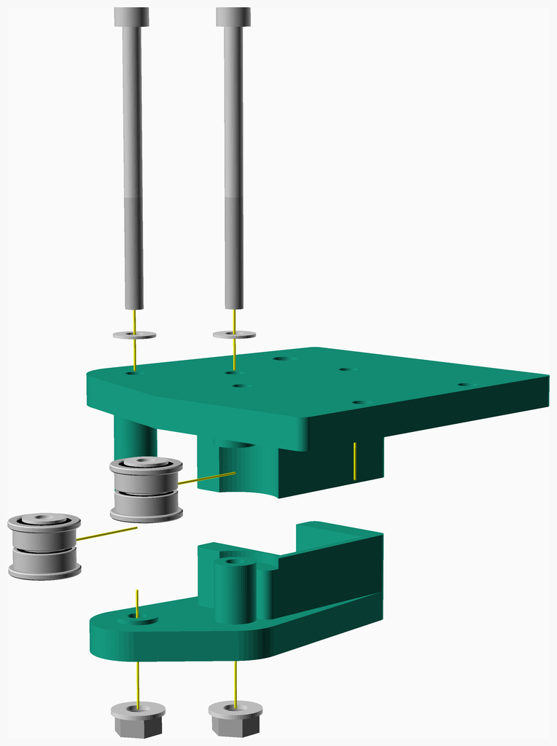
assemblies/right_y_carriage_assembly.png
