beanz/m-draw-scad/assemblies/x_carriage_assembled.png

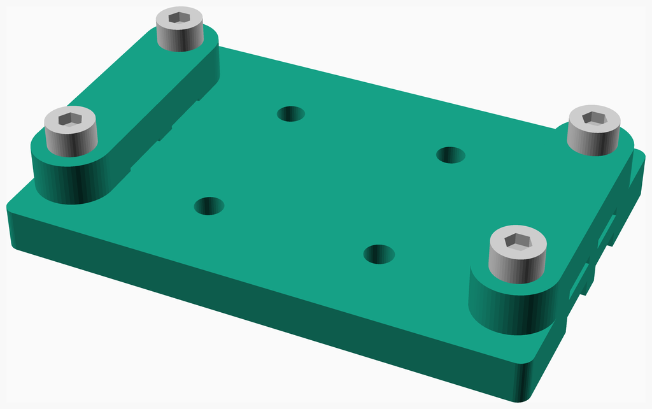
assemblies/x_carriage_assembled.png
