beanz/m-draw-scad/assemblies/x_carriage_assembly.png

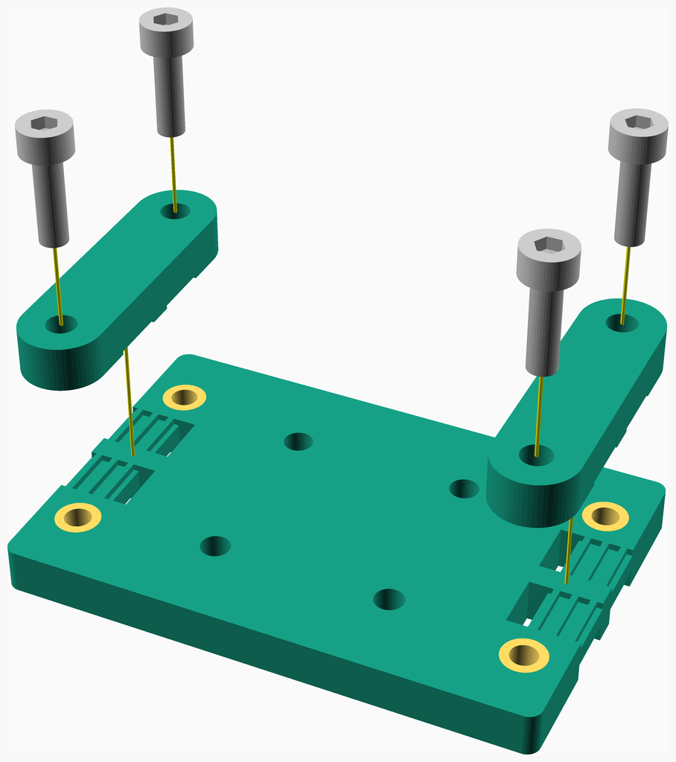
assemblies/x_carriage_assembly.png
