beanz/m-draw-scad/assemblies/x_carriage_insert_assembled.png

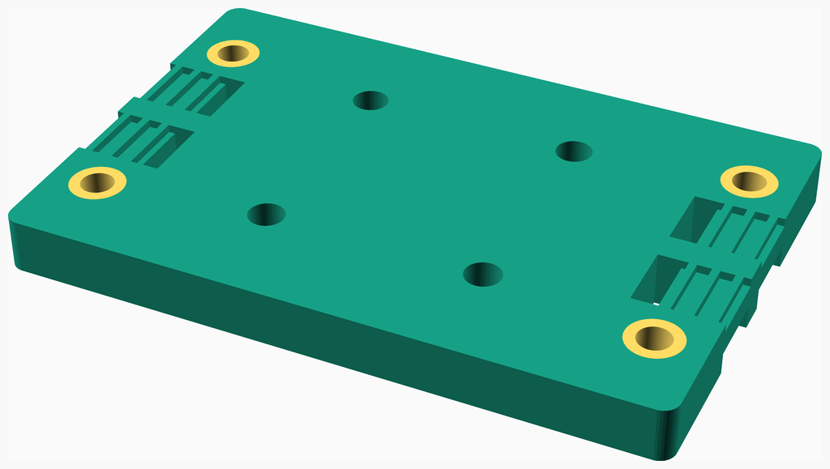
assemblies/x_carriage_insert_assembled.png
