beanz/m-draw-scad/assemblies/x_carriage_insert_assembly.png

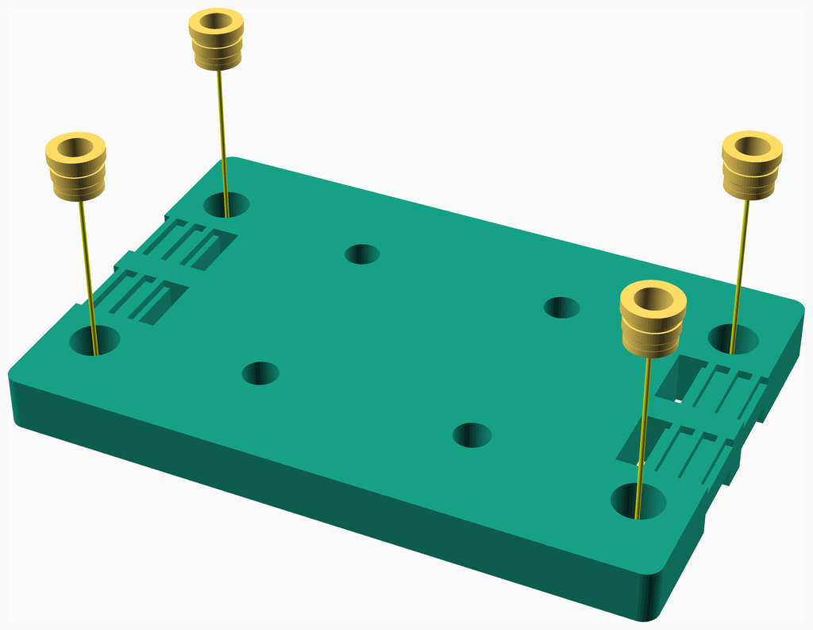
assemblies/x_carriage_insert_assembly.png
