beanz/m-draw-scad/assemblies/x_rail_assembly.png

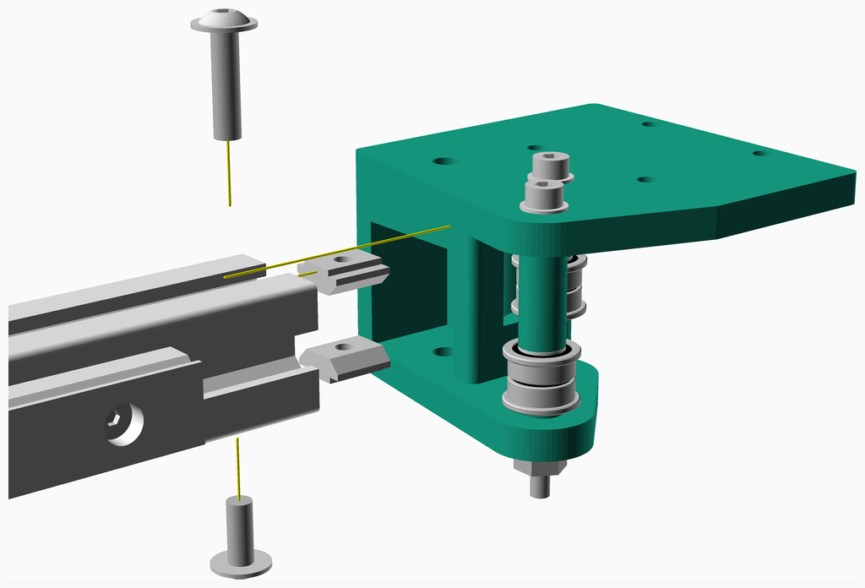
assemblies/x_rail_assembly.png
