beanz/m-draw-scad/assemblies/x_rail_carriage_assembly.png

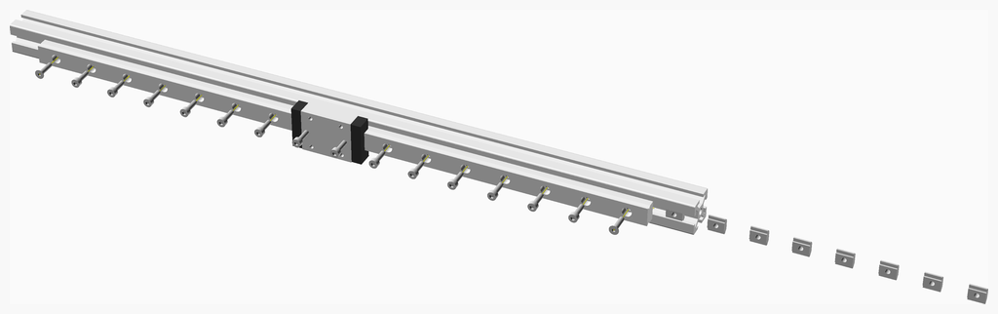
assemblies/x_rail_carriage_assembly.png
