beanz/m-draw-scad/assemblies/x_rail_left_assembly.png

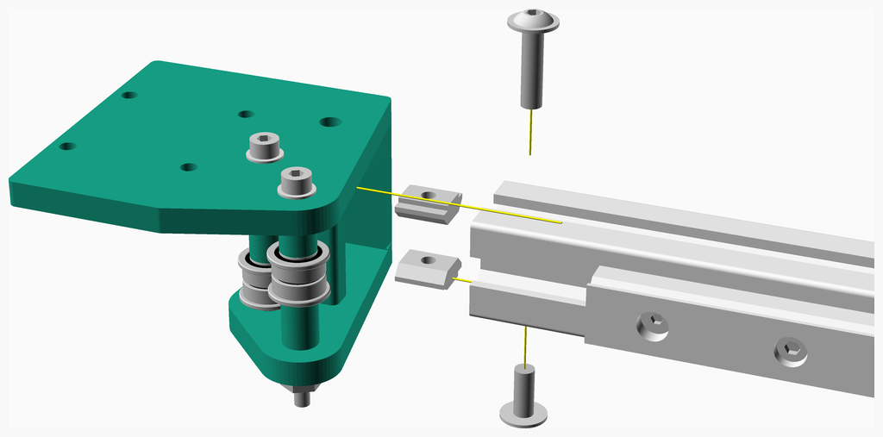
assemblies/x_rail_left_assembly.png
