beanz/m-draw-scad/assemblies/y_rail_assembled.png

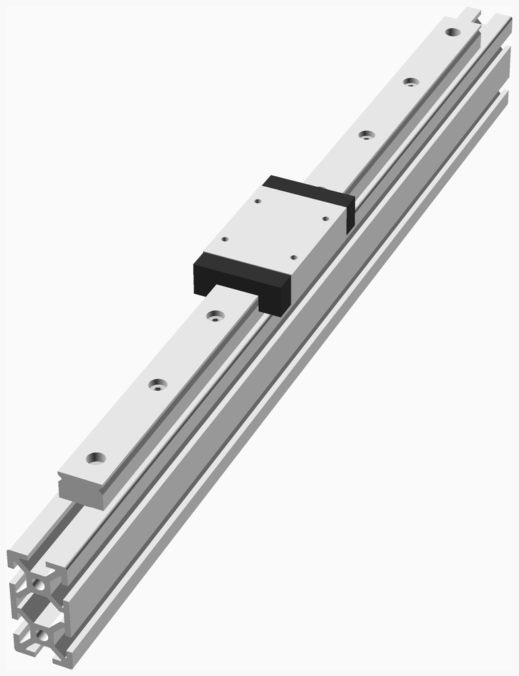
assemblies/y_rail_assembled.png
