beanz/m-draw-scad/assemblies/y_rail_assembly.png

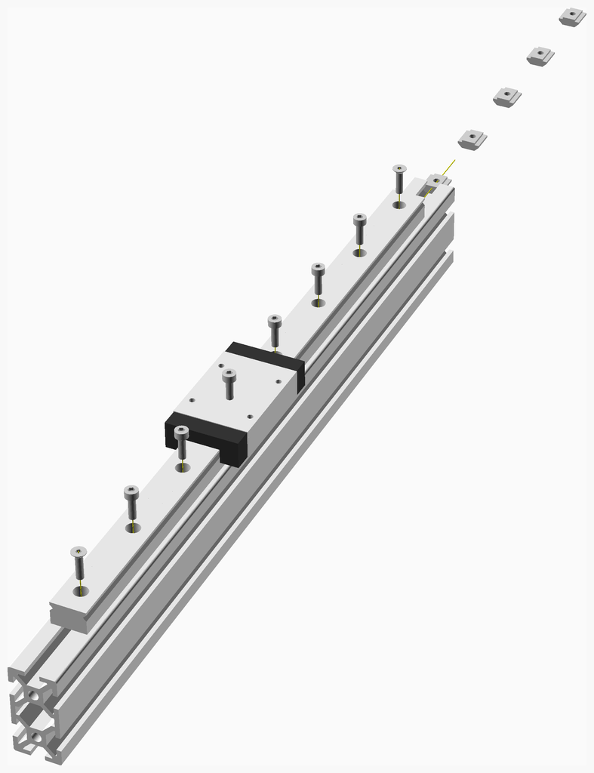
assemblies/y_rail_assembly.png
