beanz/m-draw-scad/(commit log)

2025-05-28 rough layout
    [conf.scad, main.scad]
2025-05-28 add motor mounts
    [conf.scad, main.scad]
2025-05-29 left y carriage assembly
    [conf.scad, main.scad]
2025-05-29 right y carriage assembly
    [main.scad]
2025-05-29 right idler mount
    [conf.scad, main.scad]
2025-05-29 left idler mount
    [main.scad]
2025-05-30 refactor for better spacing and parameterization
    [conf.scad, main.scad]
2025-05-30 start adding corner parts
    [conf.scad, main.scad]
2025-05-31 front/back frame assemblies and split files
    [corners.scad, frame.scad, main.scad]
2025-05-31 refactor: frame assembly
    [corners.scad, frame.scad, main.scad]
2025-05-31 refactor assembly
    [idlers.scad, main.scad, motor.scad, x-carriage.scad, x-rail.scad, y-carriage.scad]
2025-05-31 clearer assembly
    [main.scad]
2025-05-31 motor and idler assembly
    [idlers.scad, main.scad, motor.scad]
2025-05-31 fix: screw interference
    [conf.scad, corners.scad, frame.scad, main.scad, x-carriage.scad]
2025-05-31 assembly clean up
    [main.scad, x-rail.scad, y-carriage.scad]
2025-06-01 improve back frame assembly
    [frame.scad]
2025-06-01 improve motor and mount assembly
    [motor.scad]
2025-06-01 improve idler mount assembly
    [idlers.scad]
2025-06-01 better idler nut traps
    [idlers.scad]
2025-06-01 improve belt clamps
    [x-carriage.scad]
2025-06-01 initial generated
    [bom.csv, left_y_carriage.stl, right_y_carriage.stl, x_belt_clamp.stl, x_carriage.stl]
2025-06-01 update generated
    [bom.csv, left_lower_motor_mount.stl, left_motor_mount.stl, right_lower_motor_mount.stl, right_motor_mount.stl]
